luxio-lighting/luxio-hardware/LX0001/v1.0.0/Assets/connectors/JLCEDA-C55251566/README.txt

HDGC 2060-452-HDGC / C55251566 — original library 3D model

Source: JLCEDA/EasyEDA Official Library
https://lceda.cn/
https://easyeda.com/
Exact component metadata, including upstream copyright/source information,
is retained unmodified in EasyEDA-C55251566-original.json.

HDGC_2060_452_C55251566.step is the original STEP AP214 download.
The preview OBJ includes embedded EasyEDA material records; use the STEP
for CAD. Source URLs, hashes and measured preview bounds: provenance.json.

Housing width/length: 7.90 x 11.50 mm. Overall height including terminal
base: 4.50 mm. These match the nominal saved HDGC manufacturer drawing.
Total envelope including tails/marking: 7.91 x 13.15 x 4.50 mm.
No manufacturing-tolerance certification is implied by these nominal bounds.

Original coordinates retained. Register the model to the footprint before
attaching it: its present origin is not the custom footprint's body center.
This extraction does not change the PCB or fabrication package.
