luxio-lighting/luxio-hardware/LX0001/v1.0.0/Export/connection-check.txt

94 electrical footprints; 2 mounting holes; 266 mapped pins checked.
PASS: schematic netlist, PCB and connection table agree.
Pin-specific checks: ESP32-S3/no PSRAM/4MB flash, two 5V outputs, isolated dual-pin button, wired/USB terminals.
