luxio-lighting/luxio-hardware/LX0001/v1.0.0/Assets/io/C37616412_footprint_notes.txt

GCT USB4215-03-A / JLCPCB C37616412 — release USB connector
Verified 2026-11-11 against manufacturer drawing Rev A, 2024-04-26.
Saved: C37616412_USB4215-03-A.pdf (manufacturer drawing, distributor mirror).
Primary product: https://gct.co/connector/usb4215
Drawing: https://mm.digikey.com/Volume0/opasdata/d220001/medias/docus/6328/USB4215-03-A.pdf
Supplier: https://jlcpcb.com/partdetail/C37616412

USB 2.0, 16 contacts; 5 A collective VBUS / 48 V connector rating.
Source-advertised USB current still limits the controller's USB-only load.
No plastic locating pegs. Four plated slotted shell holes, for 0.80 +/-0.20 mm
metal stakes. Standard component-side pin-in-paste reflow is intended.

Footprint LX0001:USB_C_GCT_USB4215_03_A uses a body-centered origin.
Native mouth points +Y. Body 8.94 x 6.50 x 3.16 mm; body x +/-4.47,
y +/-3.25. All dimensions below are mm and viewed from component side.
Signal row: y=-3.425; length 1.15. Shared A1/B12, A4/B9, A9/B4, A12/B1
lands are 0.60 wide at x=-3.20,-2.40,+2.40,+3.20. Eight 0.30-wide lands
are at x=-1.75,-1.25,-0.75,-0.25,+0.25,+0.75,+1.25,+1.75, in drawing order
B8,A5,B7,A6,A7,B6,A8,B5. Shared physical lands carry both logical pin names.
Shell centers x +/-4.32. Rear y=-2.85, land 1.00x1.80, slot 0.60x1.40.
Front y=+1.15, land 1.00x2.20, slot 0.60x1.80. All shell pads named SH/GND.
Copper extents x +/-4.82, y=-4.00..+2.25. Body extends to y=+3.25.
Courtyard x +/-5.07, y=-4.25..+3.50 (plus 0.025 stroke).
The 5.15 distance from front stake center to signal-land rear edge, 4.00
stake-row pitch and 2.10 mouth-to-front-stake distance determine registration.

60 x 20 mm board integration, v1.0.0 revision 2026-11-11:
Load native footprint on top, rotate -90 degrees, place at (2.75,5.25).
Board outline x=0..60,y=0..20. Fabrication origin (0,20): CPL=(X,20-Y).
Mouth x=-0.50 (0.50 mm beyond input edge). Body x=-0.50..6.00,
y=0.78..9.72. Shell centers (1.60,0.93),(5.60,0.93),(1.60,9.57),
(5.60,9.57). J2 is also on top at (6.50,15.25), rotation -90;
its body spans x=0.75..12.25,y=11.30..19.20. Nominal body-to-body gap
across the width is 1.58 mm. Both connectors open toward the input end;
J2's face sits 1.25 mm farther inward than the USB mouth.
All shell holes and annuli clear J2 and other component bodies.
Shell masks open on BOTH sides; F.Paste only. Normal hybrid SMT/PIP assembly
applies, with no courtyard exception or opposite-side fillet restriction.
Previous 66.5 mm geometry: Assets/review-history/stacked-inputs-665mm.

Attached STEP: Source/libraries/models/USB_C_C37616412_library.step.
The exact C37616412 library record links to the shared model
USB-C-SMD_GT-USB-7010B. Its 8.94 x 6.50 x 3.16 mm body and shell centers
match the GCT drawing. The 0.90 mm stake depth is within 0.80 +/-0.20 mm.
Offset (0,0,1.58) mm; no rotation/scaling. This is a library visualization,
not a manufacturer-authenticated GCT enclosure model. Original metadata and
source files: Assets/connectors/JLCEDA-C37616412. The older simplified WRL
is retained as history and is no longer attached.

Superseded: HDGC C2936195 and HRO C165948 footprints/PDFs are historical
comparison evidence only. The HDGC plastic peg holes collide with terminal
copper when both input connectors are centered; do not substitute it back.
