luxio-lighting/luxio-hardware/LX0001/v1.0.0/Assets/connectors/HDGC_2060_452_C55251566_drawing.png

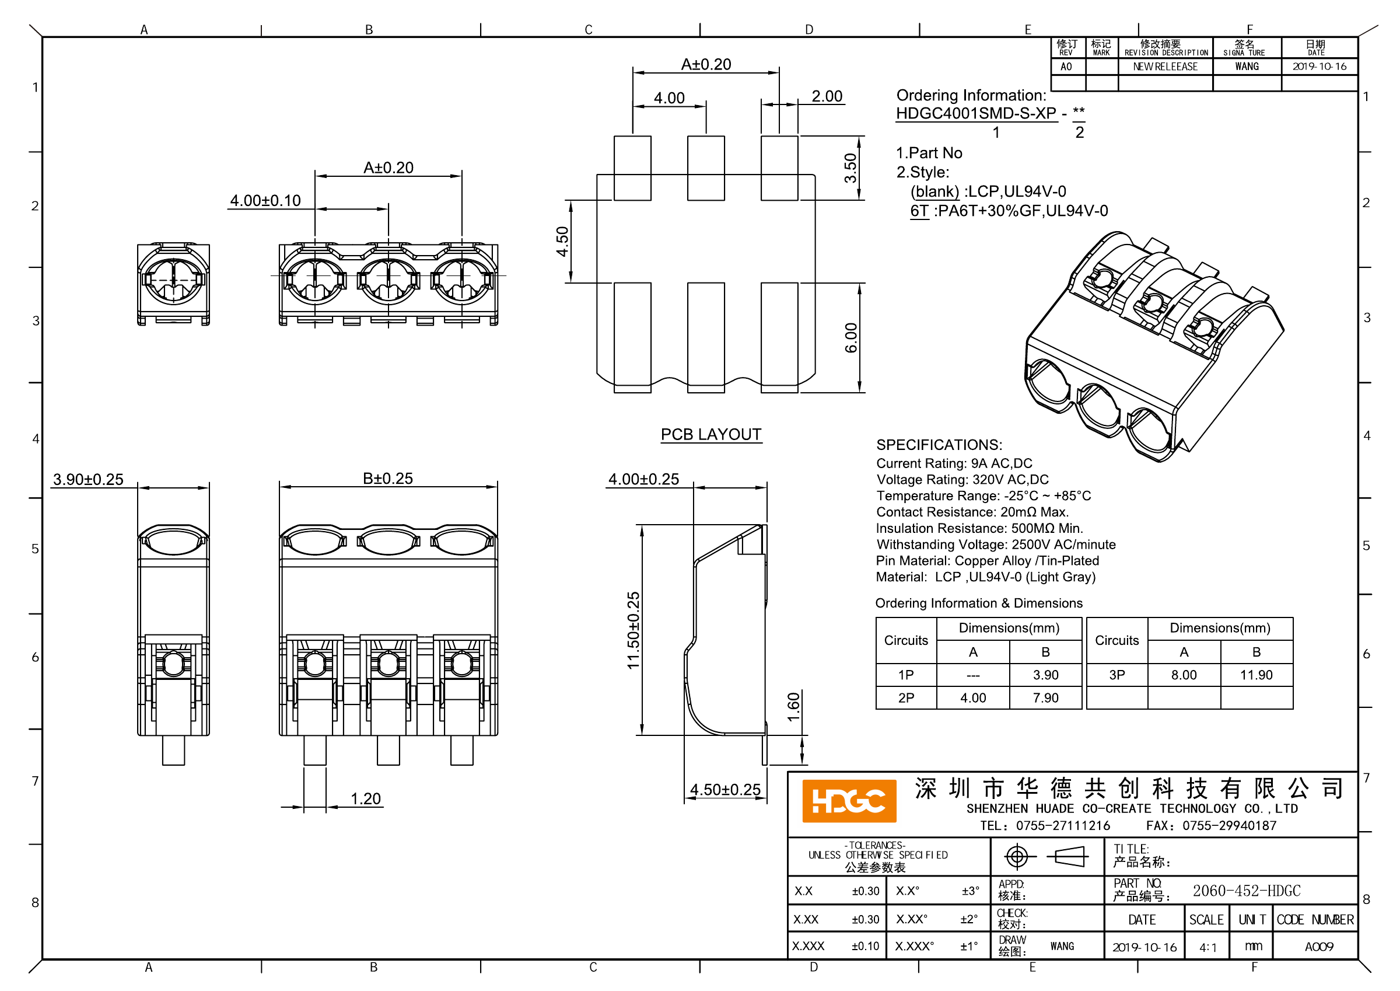
LX0001/v1.0.0/Assets/connectors/HDGC_2060_452_C55251566_drawing.png
