luxio-lighting/luxio-hardware/LX0001/v1.0.0/Assets/connectors/WAGO_2060_452_dimensional_drawing.png

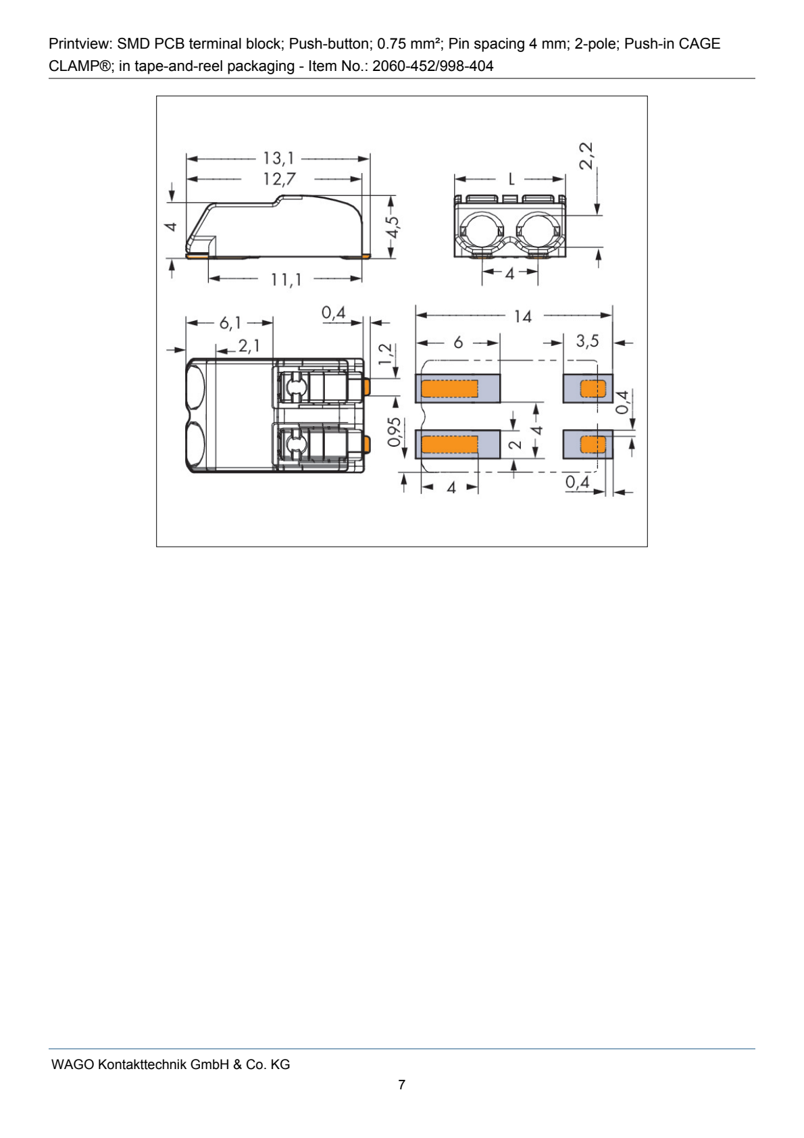
LX0001/v1.0.0/Assets/connectors/WAGO_2060_452_dimensional_drawing.png
