luxio-lighting/luxio-hardware/LX0001/v1.0.0/Assets/input-layout-proposal/side-by-side-top.png

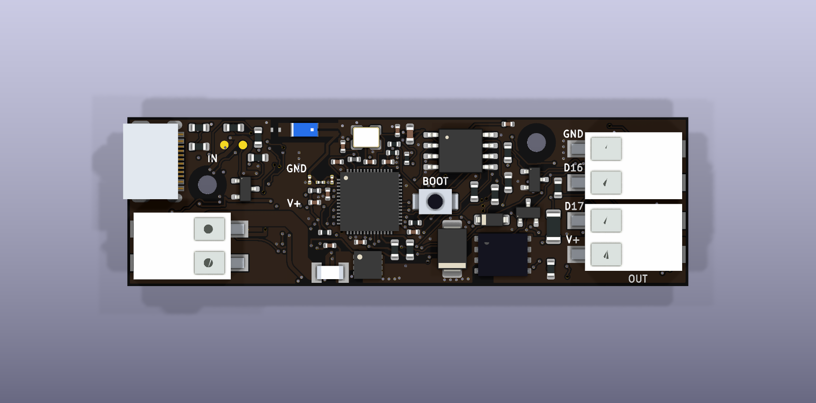
LX0001/v1.0.0/Assets/input-layout-proposal/side-by-side-top.png
