luxio-lighting/luxio-hardware/LX0001/v1.0.0/Assets/io/C2135_BAT54C_page1.png

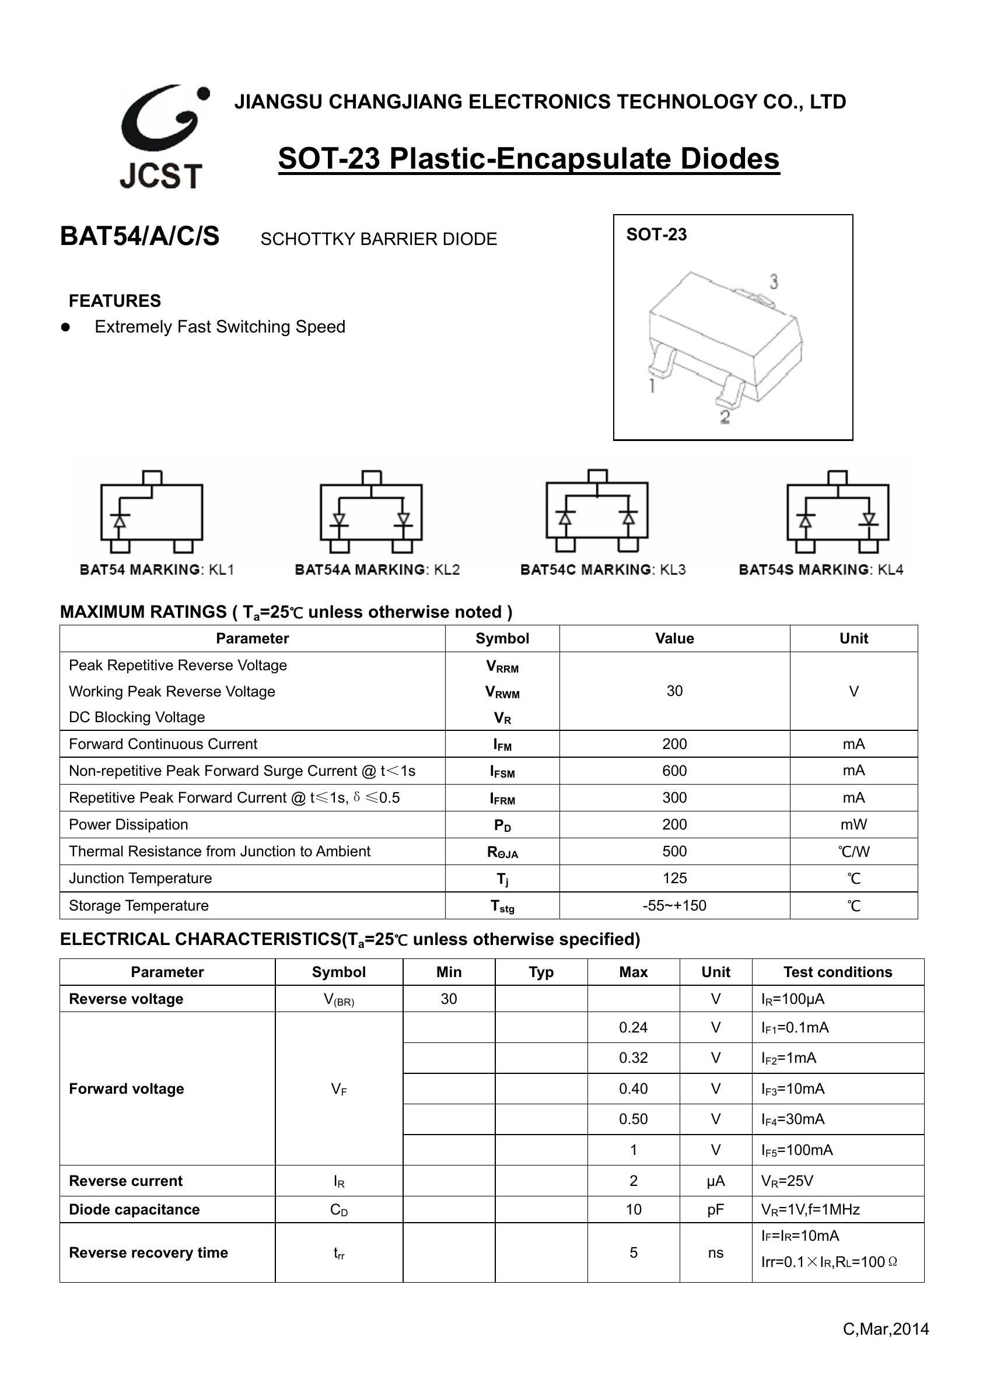
LX0001/v1.0.0/Assets/io/C2135_BAT54C_page1.png
