luxio-lighting/luxio-hardware/LX0001/v1.0.0/Assets/io/C165948_TYPE-C-31-M-12_page1.png

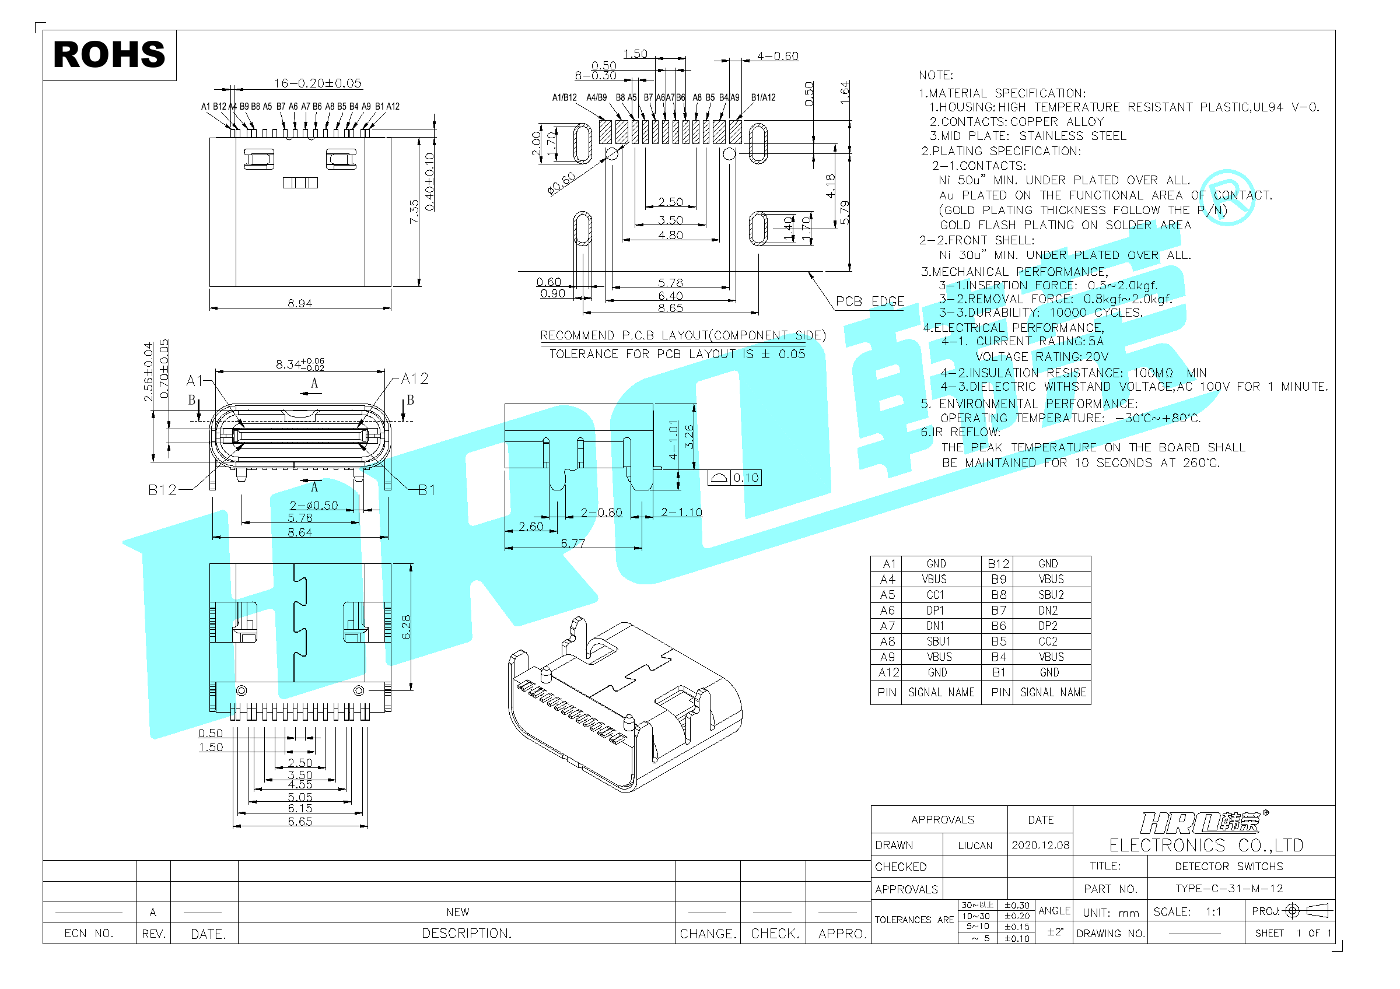
LX0001/v1.0.0/Assets/io/C165948_TYPE-C-31-M-12_page1.png
