luxio-lighting/luxio-hardware/LX0001/v1.0.0/Assets/io/C720477_TS-1088-AR02016_page1.png

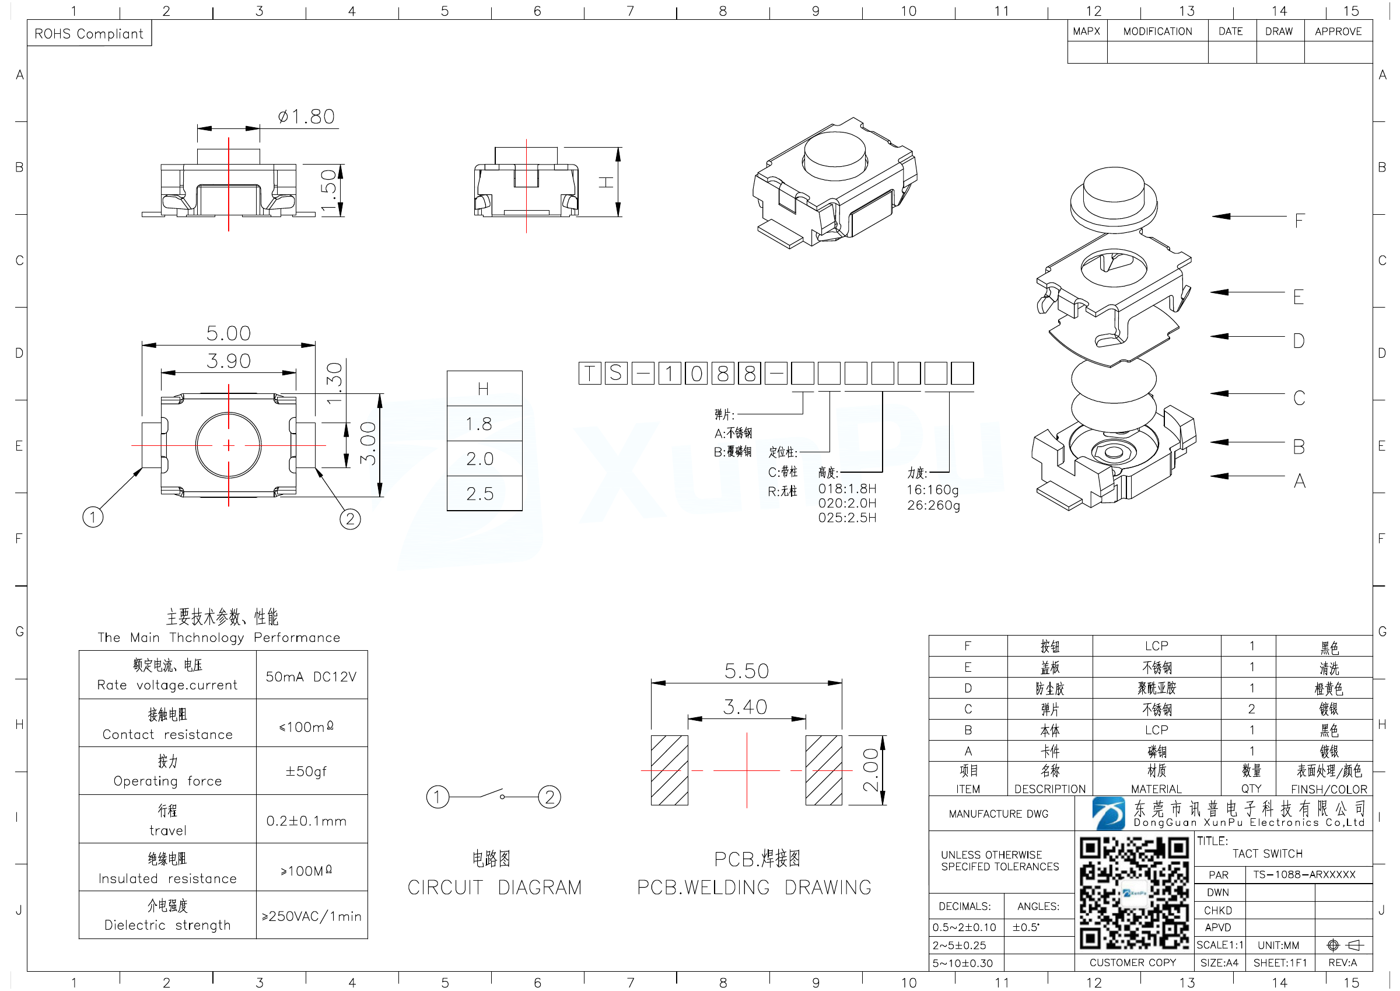
LX0001/v1.0.0/Assets/io/C720477_TS-1088-AR02016_page1.png
