luxio-lighting/luxio-hardware/LX0001/v1.0.0/Assets/io/C2927038_USB-TYPE-C-018_drawing.png

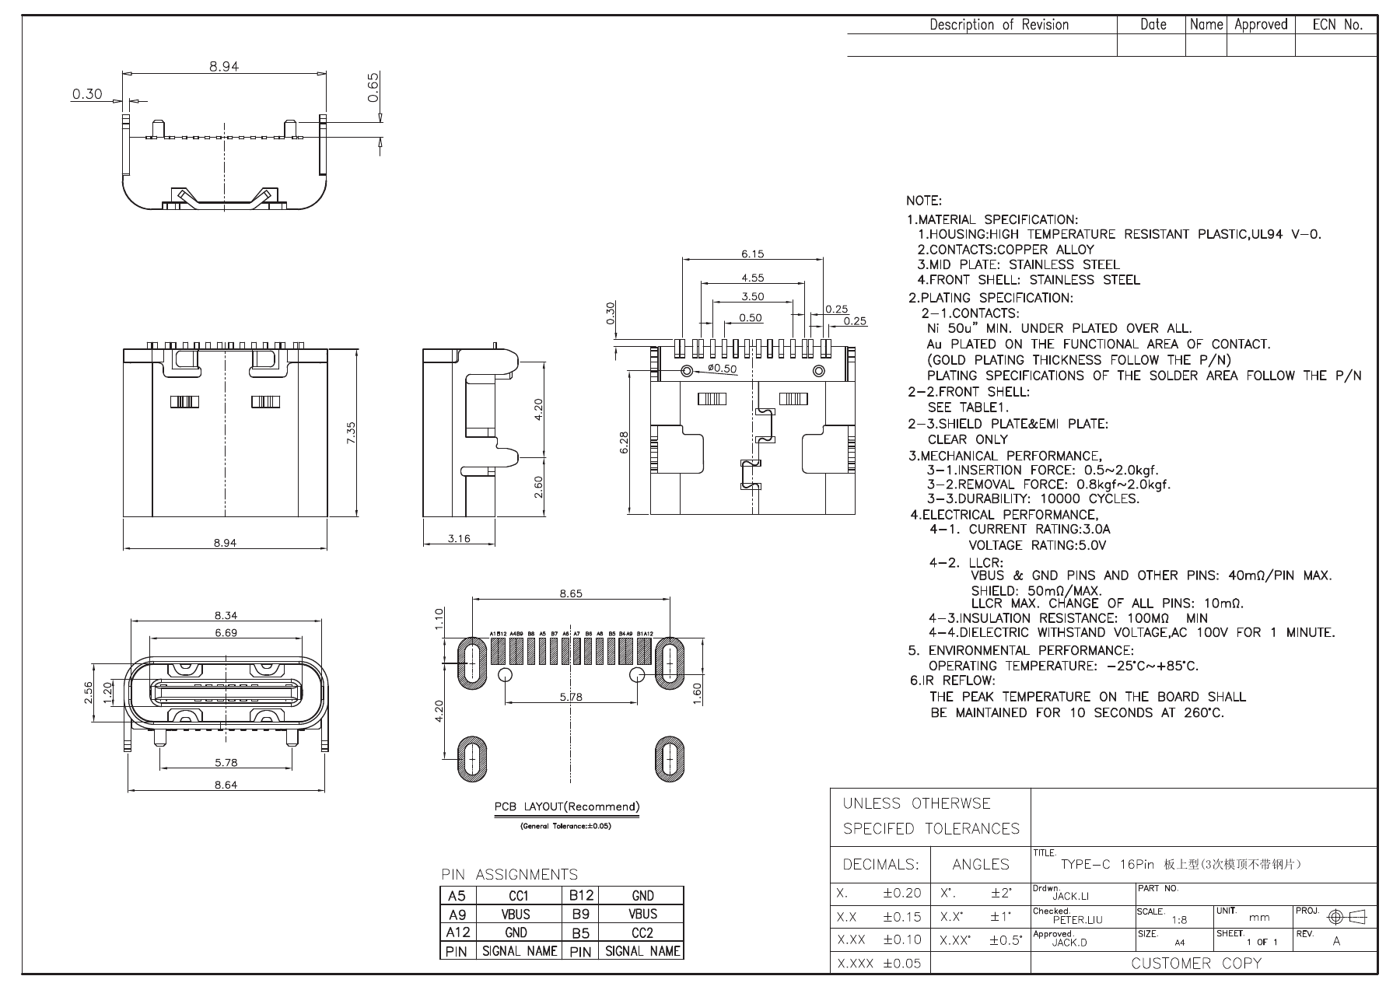
LX0001/v1.0.0/Assets/io/C2927038_USB-TYPE-C-018_drawing.png
