luxio-lighting/luxio-hardware/LX0001/v1.0.0/Assets/io/C2936195_USB_candidate.png

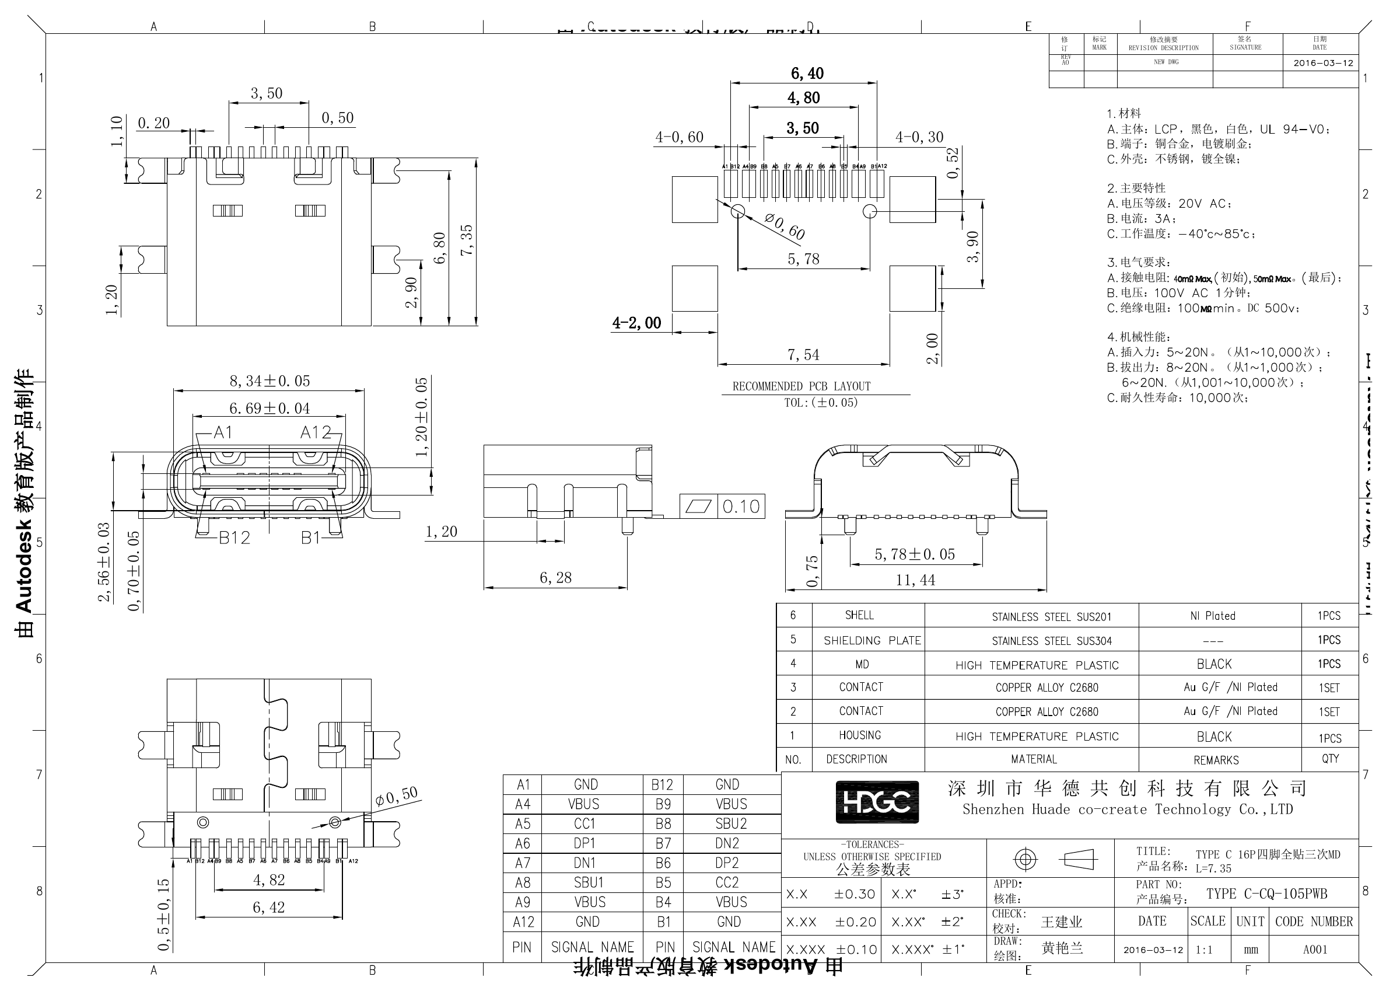
LX0001/v1.0.0/Assets/io/C2936195_USB_candidate.png
