luxio-lighting/luxio-hardware/LX0001/v1.0.0/Assets/io/C37616412_USB4215-03-A_drawing.png

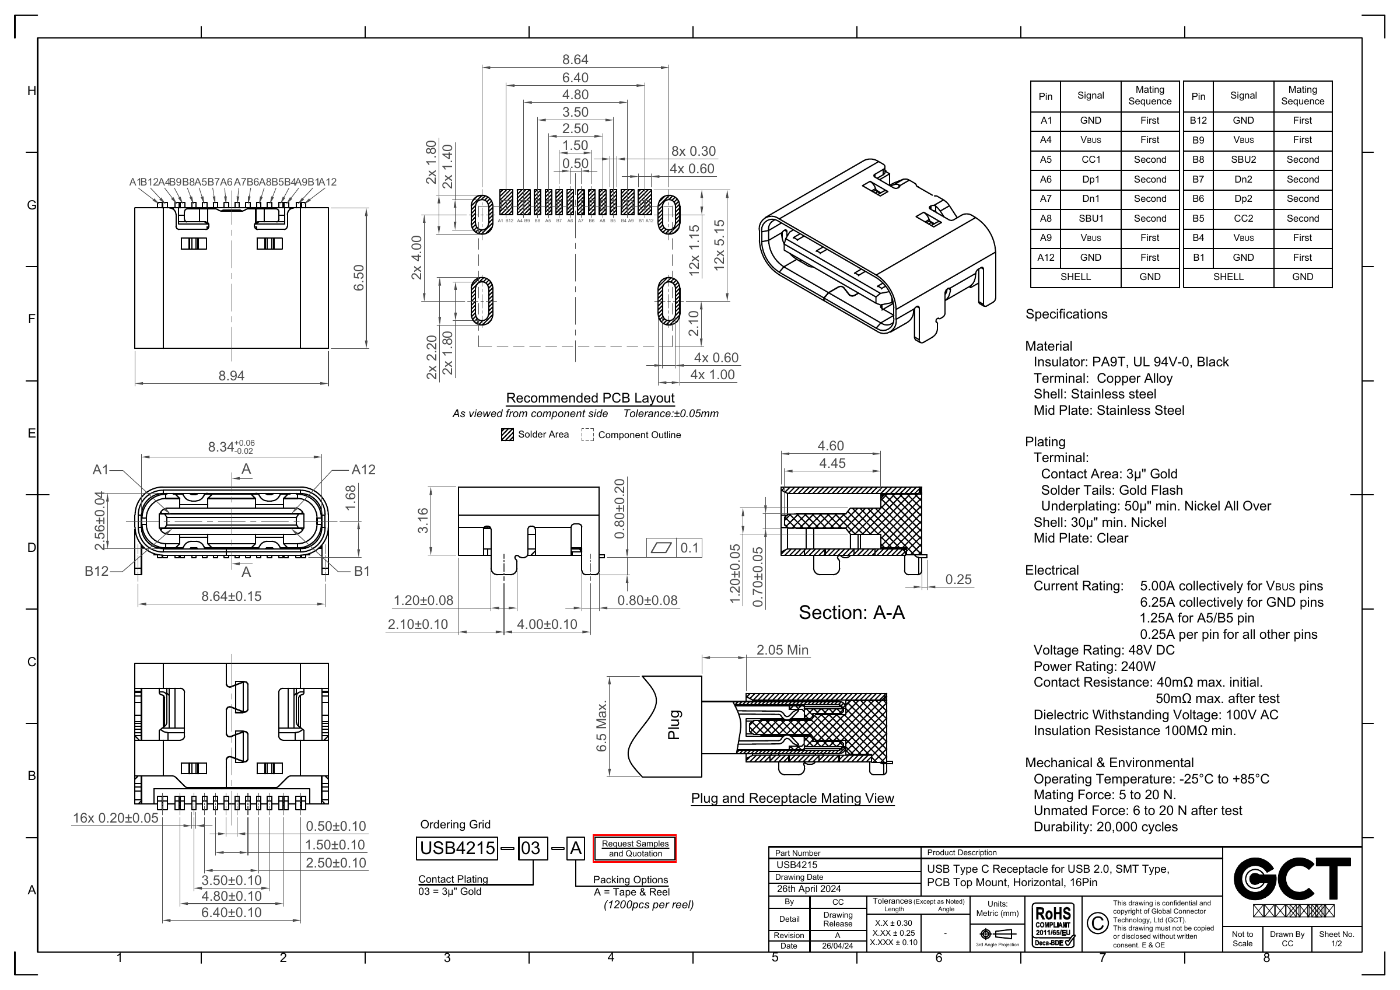
LX0001/v1.0.0/Assets/io/C37616412_USB4215-03-A_drawing.png
