luxio-lighting/luxio-hardware/LX0001/v1.0.0/Assets/io/C53340455_USB_candidate.png

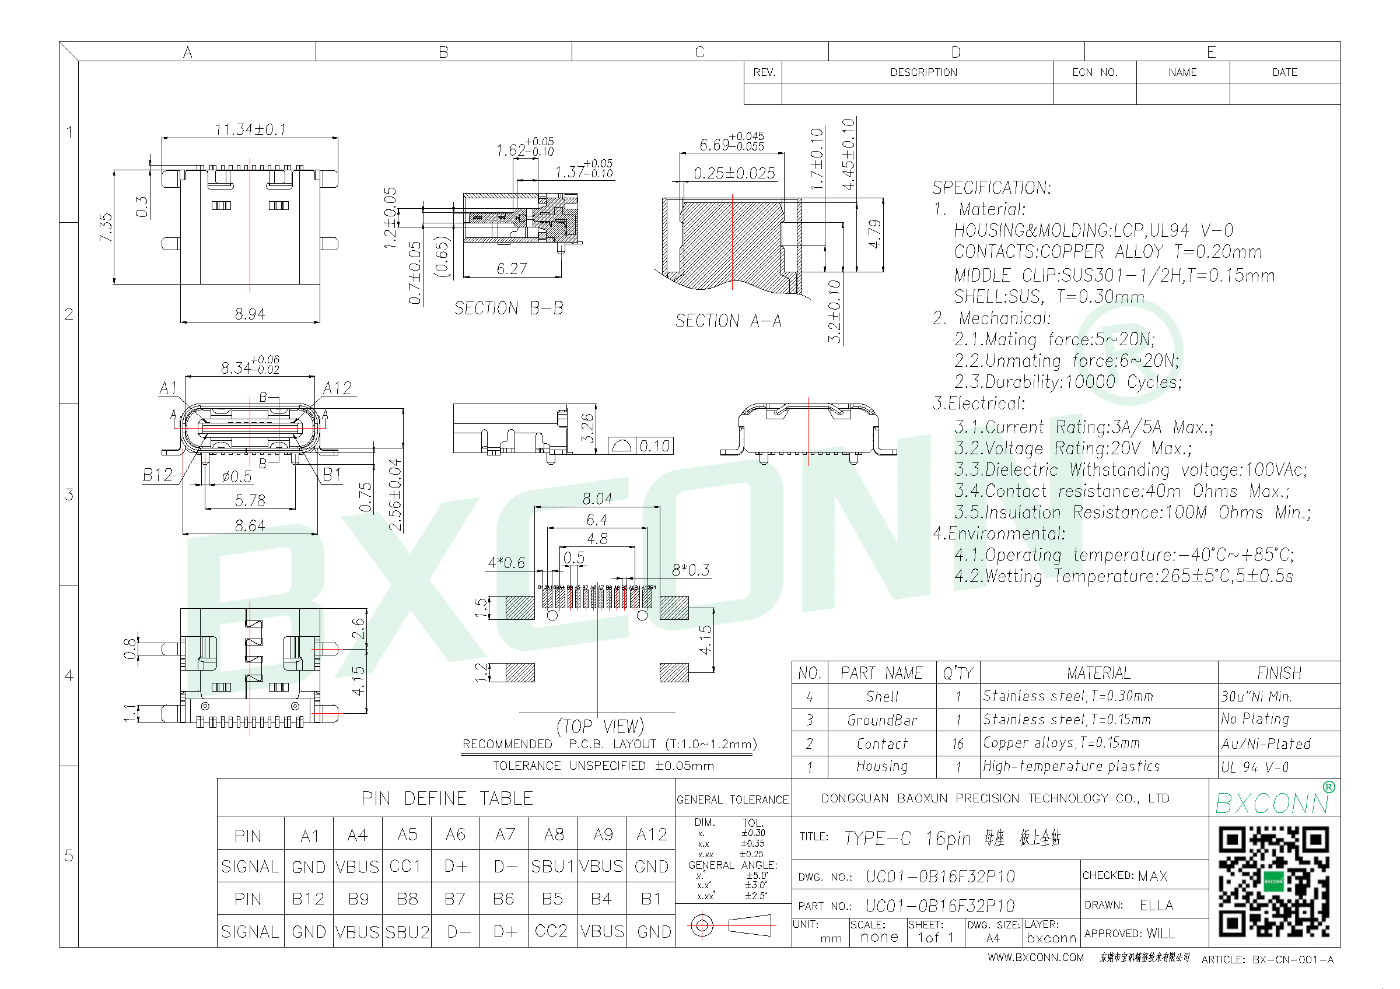
LX0001/v1.0.0/Assets/io/C53340455_USB_candidate.png
