luxio-lighting/luxio-hardware/LX0001/v1.0.0/Assets/power/CMSA80P06A-2.png

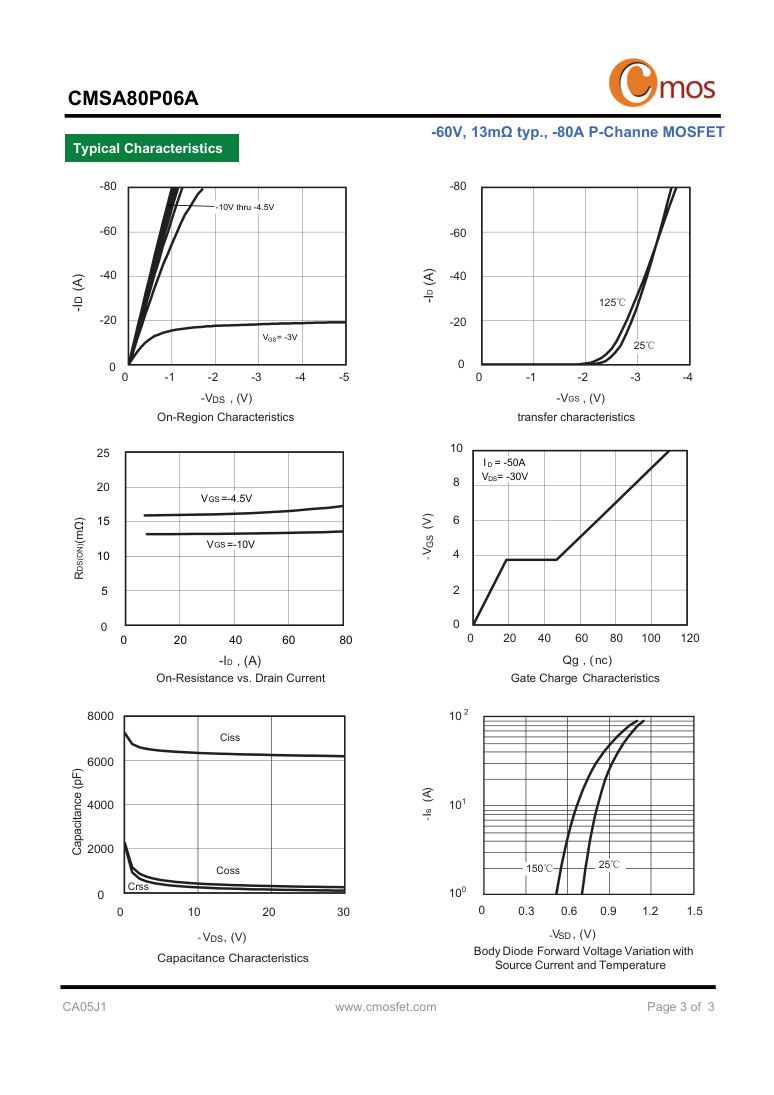
LX0001/v1.0.0/Assets/power/CMSA80P06A-2.png
