luxio-lighting/luxio-hardware/LX0001/v1.0.0/Assets/power/csd18543q3a.pdf.png

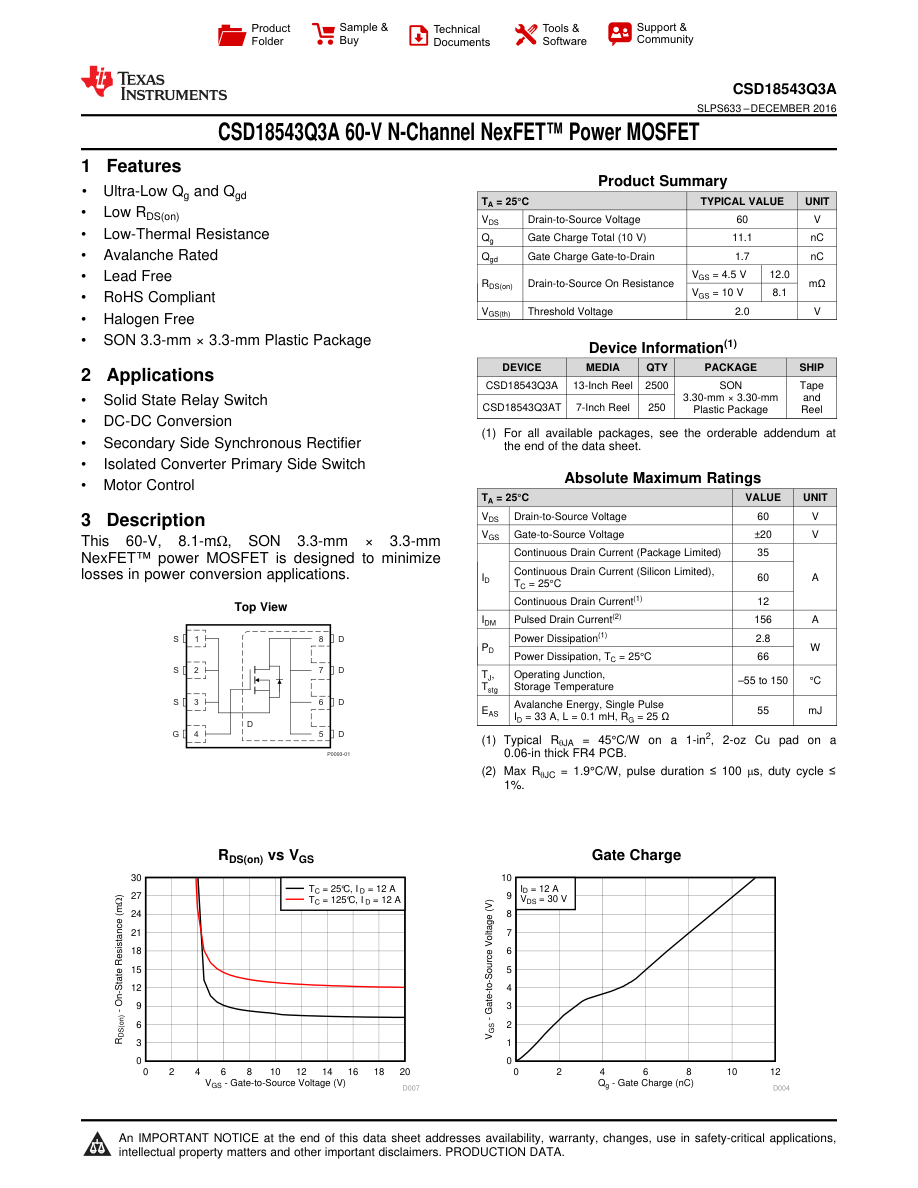
LX0001/v1.0.0/Assets/power/csd18543q3a.pdf.png
