luxio-lighting/luxio-hardware/LX0001/v1.0.0/Assets/power/DMP6023LE-pinout.png

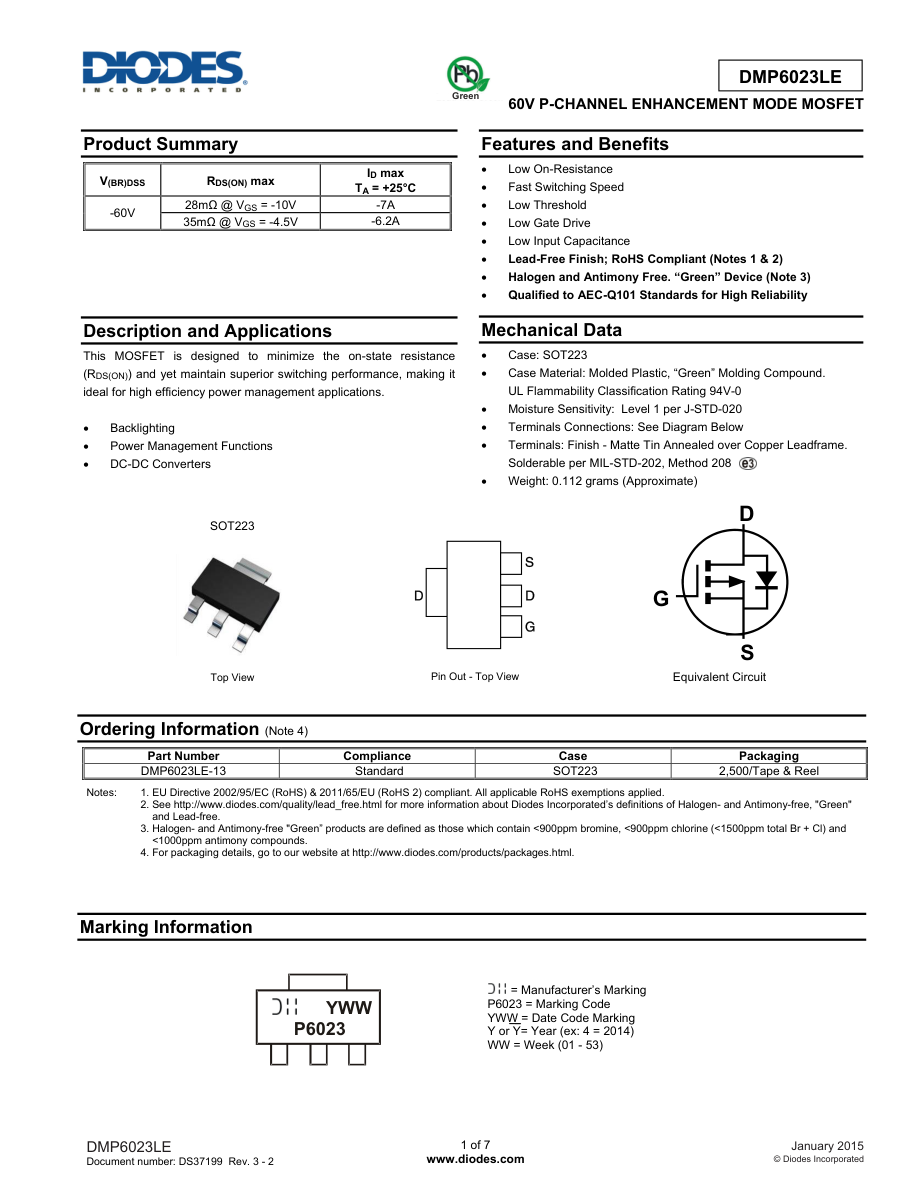
LX0001/v1.0.0/Assets/power/DMP6023LE-pinout.png
