luxio-lighting/luxio-hardware/LX0001/v1.0.0/Assets/power/tps2553.pdf.png

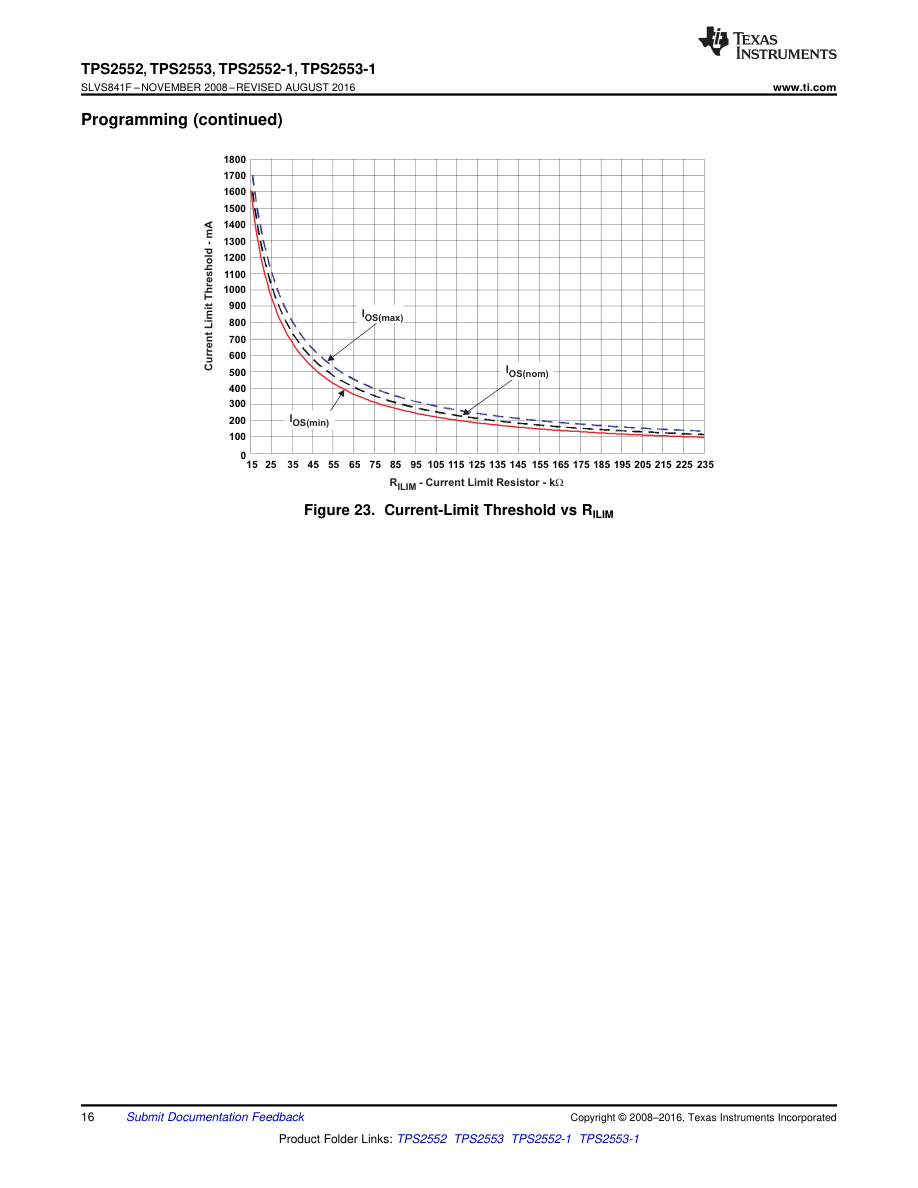
LX0001/v1.0.0/Assets/power/tps2553.pdf.png
