luxio-lighting/luxio-hardware/LX0001/v1.0.0/Export/copper-bottom.png

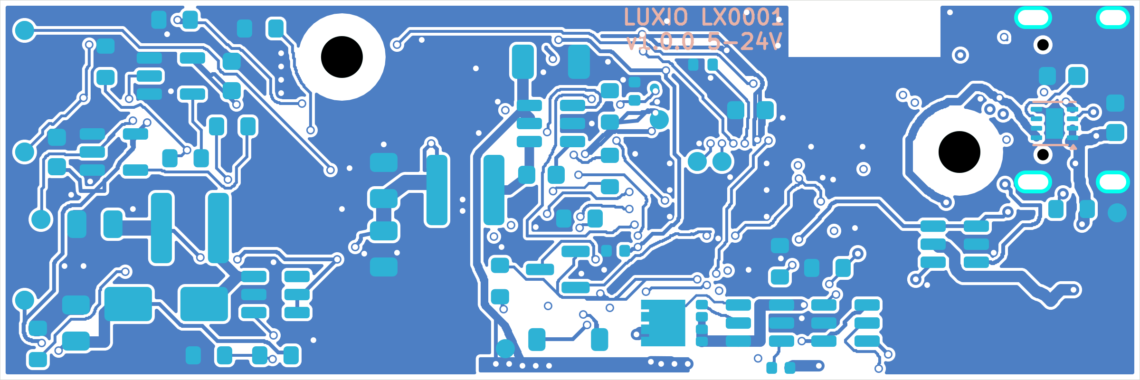
LX0001/v1.0.0/Export/copper-bottom.png
