luxio-lighting/luxio-hardware/LX0001/v1.0.0/Source/cost_review.txt

LX0001 v1.0.0 — component cost estimate after DEALON USB substitution

83 fitted parts /46 supplier codes; USD12.3170/board at100 boards.
Excludes PCB, assembly, feeders, attrition, shipping and tax.
C2927038 price/stock fetched2026-11-12. Other components retain their dated supplier snapshots. Not a reserved quotation.

LCSC       Qty/board UnitUSD Cost/board Ref
C122837        1 0.1969 0.1969 U4
C127620        1 0.0443 0.0443 ANT1
C13585         1 0.1011 0.1011 C8
C14663         3 0.0058 0.0174 C9,C14,C17
C14890         1 0.0018 0.0018 R14
C1525          7 0.0031 0.0217 C101,C102,C103,C104,C105,C108,C110
C1549          2 0.0018 0.0036 C112,C113
C15849         1 0.0112 0.0112 C6
C1588          1 0.0082 0.0082 C18
C161414        2 0.0125 0.0250 C114,C115
C17168         1 0.0012 0.0012 R105
C179173        1 1.0674 1.0674 U10
C18216         1 0.0228 0.0228 L100
C183158        1 0.0844 0.0844 F1
C19702         2 0.0177 0.0354 C100,C107
C20526         1 0.0103 0.0103 Q2
C2135          1 0.0246 0.0246 D4
C22775         2 0.0021 0.0042 R16,R27
C23186         2 0.0015 0.0030 R1,R2
C23345         2 0.0017 0.0034 R3,R4
C2480          1 0.0192 0.0192 D2
C25744         5 0.0010 0.0050 R100,R101,R102,R103,R110
C25803         7 0.0029 0.0203 R22,R17,R18,R28,R29,R10,R13
C25804         3 0.0022 0.0066 R15,R24,R30
C25819         1 0.0016 0.0016 R12
C2913192       1 2.0662 2.0662 U1
C2927038       1 0.0506 0.0506 J1
C2941042       2 2.0515 4.1030 U3,U5
C307331        2 0.0085 0.0170 C5,C7
C31850         1 0.0042 0.0042 R23
C32347484      1 0.8500 0.8500 U6
C38117         1 0.0493 0.0493 L1
C45783         4 0.0842 0.3368 C10,C11,C12,C13
C52923         3 0.0057 0.0171 C106,C109,C111
C55251566      3 0.1660 0.4980 J2,J3,J4
C57269         1 0.0466 0.0466 L2
C655034        1 0.0532 0.0532 Y1
C720477        1 0.0414 0.0414 SW1
C7470946       1 0.0403 0.0403 D3
C7484          2 0.0695 0.1390 U8,U9
C7519          1 0.1192 0.1192 U2
C81598         1 0.0124 0.0124 D1
C840100        2 0.9694 1.9388 Q1,Q3
C84817         1 0.0823 0.0823 U7
C913699        1 0.0944 0.0944 L101
C98043         1 0.0166 0.0166 L102
