luxio-lighting/luxio-hardware/LX0001/v1.0.0/Export/component-costs.csv

lcsc | designators | quantity_per_board | required_quantity_100_boards | unit_price_usd | cost_per_board_usd | cost_100_boards_usd | available_stock | observed_at_utc | source_url
C122837 | U4 | 1 | 100 | 0.1969 | 0.1969 | 19.69 | 12099 | 2026-11-11T22:44:12.739354+00:00 | https://jlcpcb.com/api/overseas-pcb-order/v1/smtComponentShopCart/getComponentDetail?componentCode=C122837
C127620 | ANT1 | 1 | 100 | 0.0443 | 0.0443 | 4.43 | 21976 | 2026-11-11T13:00:22Z | https://jlcpcb.com/api/overseas-pcb-order/v1/smtComponentShopCart/getComponentDetail?componentCode=C127620
C13585 | C8 | 1 | 100 | 0.1011 | 0.1011 | 10.11 | 2595851 | 2026-11-11T11:47:00Z | https://jlcpcb.com/api/overseas-pcb-order/v1/smtComponentShopCart/getComponentDetail?componentCode=C13585
C14663 | C9,C14,C17 | 3 | 300 | 0.0058 | 0.0174 | 1.74 | 24795240 | 2026-11-11T11:47:00Z | https://jlcpcb.com/api/overseas-pcb-order/v1/smtComponentShopCart/getComponentDetail?componentCode=C14663
C14890 | R14 | 1 | 100 | 0.0018 | 0.0018 | 0.18 | 29104 | 2026-11-11T11:47:00Z | https://jlcpcb.com/api/overseas-pcb-order/v1/smtComponentShopCart/getComponentDetail?componentCode=C14890
C1525 | C101,C102,C103,C104,C105,C108,C110 | 7 | 700 | 0.0031 | 0.0217 | 2.17 | 23336222 | 2026-11-11T11:46:59Z | https://jlcpcb.com/api/overseas-pcb-order/v1/smtComponentShopCart/getComponentDetail?componentCode=C1525
C1549 | C112,C113 | 2 | 200 | 0.0018 | 0.0036 | 0.36 | 958063 | 2026-11-11T11:46:59Z | https://jlcpcb.com/api/overseas-pcb-order/v1/smtComponentShopCart/getComponentDetail?componentCode=C1549
C15849 | C6 | 1 | 100 | 0.0112 | 0.0112 | 1.12 | 8918774 | 2026-11-11T11:47:44Z | https://jlcpcb.com/api/overseas-pcb-order/v1/smtComponentShopCart/getComponentDetail?componentCode=C15849
C1588 | C18 | 1 | 100 | 0.0082 | 0.0082 | 0.82 | 4761056 | 2026-11-11T22:44:12.739354+00:00 | https://jlcpcb.com/api/overseas-pcb-order/v1/smtComponentShopCart/getComponentDetail?componentCode=C1588
C161414 | C114,C115 | 2 | 200 | 0.0125 | 0.025 | 2.5 | 33848 | 2026-11-11T11:47:01Z | https://jlcpcb.com/api/overseas-pcb-order/v1/smtComponentShopCart/getComponentDetail?componentCode=C161414
C17168 | R105 | 1 | 100 | 0.0012 | 0.0012 | 0.12 | 13890683 | 2026-11-11T11:47:00Z | https://jlcpcb.com/api/overseas-pcb-order/v1/smtComponentShopCart/getComponentDetail?componentCode=C17168
C179173 | U10 | 1 | 100 | 1.0674 | 1.0674 | 106.74 | 2064 | 2026-11-11T11:47:01Z | https://jlcpcb.com/api/overseas-pcb-order/v1/smtComponentShopCart/getComponentDetail?componentCode=C179173
C18216 | L100 | 1 | 100 | 0.0228 | 0.0228 | 2.28 | 50007 | 2026-11-11T11:47:00Z | https://jlcpcb.com/api/overseas-pcb-order/v1/smtComponentShopCart/getComponentDetail?componentCode=C18216
C183158 | F1 | 1 | 100 | 0.0844 | 0.0844 | 8.44 | 2122 | 2026-11-11T11:47:01Z | https://jlcpcb.com/api/overseas-pcb-order/v1/smtComponentShopCart/getComponentDetail?componentCode=C183158
C19702 | C100,C107 | 2 | 200 | 0.0177 | 0.0354 | 3.54 | 6970687 | 2026-11-11T11:47:00Z | https://jlcpcb.com/api/overseas-pcb-order/v1/smtComponentShopCart/getComponentDetail?componentCode=C19702
C20526 | Q2 | 1 | 100 | 0.0103 | 0.0103 | 1.03 | 4111492 | 2026-11-11T11:47:00Z | https://jlcpcb.com/api/overseas-pcb-order/v1/smtComponentShopCart/getComponentDetail?componentCode=C20526
C2135 | D4 | 1 | 100 | 0.0246 | 0.0246 | 2.46 | 165977 | 2026-11-11T11:47:00Z | https://jlcpcb.com/api/overseas-pcb-order/v1/smtComponentShopCart/getComponentDetail?componentCode=C2135
C22775 | R16,R27 | 2 | 200 | 0.0021 | 0.0042 | 0.42 | 6545386 | 2026-11-11T11:47:00Z | https://jlcpcb.com/api/overseas-pcb-order/v1/smtComponentShopCart/getComponentDetail?componentCode=C22775
C23186 | R1,R2 | 2 | 200 | 0.0015 | 0.003 | 0.3 | 18434736 | 2026-11-11T11:47:00Z | https://jlcpcb.com/api/overseas-pcb-order/v1/smtComponentShopCart/getComponentDetail?componentCode=C23186
C23345 | R3,R4 | 2 | 200 | 0.0017 | 0.0034 | 0.34 | 4690688 | 2026-11-11T11:47:00Z | https://jlcpcb.com/api/overseas-pcb-order/v1/smtComponentShopCart/getComponentDetail?componentCode=C23345
C2480 | D2 | 1 | 100 | 0.0192 | 0.0192 | 1.92 | 1393158 | 2026-11-11T11:46:59Z | https://jlcpcb.com/api/overseas-pcb-order/v1/smtComponentShopCart/getComponentDetail?componentCode=C2480
C25744 | R100,R101,R102,R103,R110 | 5 | 500 | 0.001 | 0.005 | 0.5 | 15152057 | 2026-11-11T11:47:00Z | https://jlcpcb.com/api/overseas-pcb-order/v1/smtComponentShopCart/getComponentDetail?componentCode=C25744
C25803 | R22,R17,R18,R28,R29,R10,R13 | 7 | 700 | 0.0029 | 0.0203 | 2.03 | 12927296 | 2026-11-11T11:47:00Z | https://jlcpcb.com/api/overseas-pcb-order/v1/smtComponentShopCart/getComponentDetail?componentCode=C25803
C25804 | R15,R24,R30 | 3 | 300 | 0.0022 | 0.0066 | 0.66 | 33355199 | 2026-11-11T11:47:00Z | https://jlcpcb.com/api/overseas-pcb-order/v1/smtComponentShopCart/getComponentDetail?componentCode=C25804
C25819 | R12 | 1 | 100 | 0.0016 | 0.0016 | 0.16 | 2253598 | 2026-11-11T11:47:00Z | https://jlcpcb.com/api/overseas-pcb-order/v1/smtComponentShopCart/getComponentDetail?componentCode=C25819
C2913192 | U1 | 1 | 100 | 2.0662 | 2.0662 | 206.62 | 781 | 2026-11-11T11:47:45Z | https://jlcpcb.com/api/overseas-pcb-order/v1/smtComponentShopCart/getComponentDetail?componentCode=C2913192
C2927038 | J1 | 1 | 100 | 0.0506 | 0.0506 | 5.06 | 194721 | 2026-11-12T13:22:00.833419+00:00 | https://jlcpcb.com/api/overseas-pcb-order/v1/smtComponentShopCart/getComponentDetail?componentCode=C2927038
C2941042 | U3,U5 | 2 | 200 | 2.0515 | 4.103 | 410.3 | 18978 | 2026-11-11T11:47:01Z | https://jlcpcb.com/api/overseas-pcb-order/v1/smtComponentShopCart/getComponentDetail?componentCode=C2941042
C307331 | C5,C7 | 2 | 200 | 0.0085 | 0.017 | 1.7 | 15474133 | 2026-11-11T19:44:21Z | https://jlcpcb.com/partdetail/C307331
C31850 | R23 | 1 | 100 | 0.0042 | 0.0042 | 0.42 | 2239622 | 2026-11-11T11:47:44Z | https://jlcpcb.com/api/overseas-pcb-order/v1/smtComponentShopCart/getComponentDetail?componentCode=C31850
C32347484 | U6 | 1 | 100 | 0.85 | 0.85 | 85.0 | 813 | 2026-11-11T11:47:01Z | https://jlcpcb.com/api/overseas-pcb-order/v1/smtComponentShopCart/getComponentDetail?componentCode=C32347484
C38117 | L1 | 1 | 100 | 0.0493 | 0.0493 | 4.93 | 37531 | 2026-11-11T11:47:00Z | https://jlcpcb.com/api/overseas-pcb-order/v1/smtComponentShopCart/getComponentDetail?componentCode=C38117
C45783 | C10,C11,C12,C13 | 4 | 400 | 0.0842 | 0.3368 | 33.68 | 2799208 | 2026-11-11T11:47:44Z | https://jlcpcb.com/api/overseas-pcb-order/v1/smtComponentShopCart/getComponentDetail?componentCode=C45783
C52923 | C106,C109,C111 | 3 | 300 | 0.0057 | 0.0171 | 1.71 | 8484075 | 2026-11-11T11:47:00Z | https://jlcpcb.com/api/overseas-pcb-order/v1/smtComponentShopCart/getComponentDetail?componentCode=C52923
C55251566 | J2,J3,J4 | 3 | 300 | 0.166 | 0.498 | 49.8 | 19989 | 2026-11-11T11:47:01Z | https://jlcpcb.com/api/overseas-pcb-order/v1/smtComponentShopCart/getComponentDetail?componentCode=C55251566
C57269 | L2 | 1 | 100 | 0.0466 | 0.0466 | 4.66 | 28128 | 2026-11-11T11:47:00Z | https://jlcpcb.com/api/overseas-pcb-order/v1/smtComponentShopCart/getComponentDetail?componentCode=C57269
C655034 | Y1 | 1 | 100 | 0.0532 | 0.0532 | 5.32 | 2657 | 2026-11-11T11:47:45Z | https://jlcpcb.com/api/overseas-pcb-order/v1/smtComponentShopCart/getComponentDetail?componentCode=C655034
C720477 | SW1 | 1 | 100 | 0.0414 | 0.0414 | 4.14 | 850648 | 2026-11-11T11:47:01Z | https://jlcpcb.com/api/overseas-pcb-order/v1/smtComponentShopCart/getComponentDetail?componentCode=C720477
C7470946 | D3 | 1 | 100 | 0.0403 | 0.0403 | 4.03 | 10310 | 2026-11-11T11:47:01Z | https://jlcpcb.com/api/overseas-pcb-order/v1/smtComponentShopCart/getComponentDetail?componentCode=C7470946
C7484 | U8,U9 | 2 | 200 | 0.0695 | 0.139 | 13.9 | 18376 | 2026-11-11T11:46:59Z | https://jlcpcb.com/api/overseas-pcb-order/v1/smtComponentShopCart/getComponentDetail?componentCode=C7484
C7519 | U2 | 1 | 100 | 0.1192 | 0.1192 | 11.92 | 24773 | 2026-11-11T11:47:00Z | https://jlcpcb.com/api/overseas-pcb-order/v1/smtComponentShopCart/getComponentDetail?componentCode=C7519
C81598 | D1 | 1 | 100 | 0.0124 | 0.0124 | 1.24 | 3020259 | 2026-11-11T11:47:01Z | https://jlcpcb.com/api/overseas-pcb-order/v1/smtComponentShopCart/getComponentDetail?componentCode=C81598
C840100 | Q1,Q3 | 2 | 200 | 0.9694 | 1.9388 | 193.88 | 1755 | 2026-11-11T11:47:01Z | https://jlcpcb.com/api/overseas-pcb-order/v1/smtComponentShopCart/getComponentDetail?componentCode=C840100
C84817 | U7 | 1 | 100 | 0.0823 | 0.0823 | 8.23 | 26822 | 2026-11-11T11:47:01Z | https://jlcpcb.com/api/overseas-pcb-order/v1/smtComponentShopCart/getComponentDetail?componentCode=C84817
C913699 | L101 | 1 | 100 | 0.0944 | 0.0944 | 9.44 | 3005 | 2026-11-11T11:47:01Z | https://jlcpcb.com/api/overseas-pcb-order/v1/smtComponentShopCart/getComponentDetail?componentCode=C913699
C98043 | L102 | 1 | 100 | 0.0166 | 0.0166 | 1.66 | 6382 | 2026-11-11T11:47:01Z | https://jlcpcb.com/api/overseas-pcb-order/v1/smtComponentShopCart/getComponentDetail?componentCode=C98043
