luxio-lighting/luxio-hardware/LX0001/v1.0.0/Assets/review-history/stacked-inputs-665mm/Source/connections.csv

Reference | Value | Pin | Net
U1 | ESP32-S3 | 1 | RF_CHIP
U1 | ESP32-S3 | 2 | VDD3P3_RF
U1 | ESP32-S3 | 3 | VDD3P3_RF
U1 | ESP32-S3 | 4 | ESP_EN
U1 | ESP32-S3 | 5 | BOOT
U1 | ESP32-S3 | 6 | CC1_SENSE
U1 | ESP32-S3 | 7 | CC2_SENSE
U1 | ESP32-S3 | 9 | VBUS_SENSE
U1 | ESP32-S3 | 10 | USB_STRIP_EN
U1 | ESP32-S3 | 20 | +3V3
U1 | ESP32-S3 | 22 | GPIO16
U1 | ESP32-S3 | 23 | GPIO17
U1 | ESP32-S3 | 24 | GPIO18_BUTTON
U1 | ESP32-S3 | 25 | USB_DM
U1 | ESP32-S3 | 26 | USB_DP
U1 | ESP32-S3 | 27 | DATA_ENABLE
U1 | ESP32-S3 | 29 | VDD_SPI
U1 | ESP32-S3 | 30 | FLASH_IO3
U1 | ESP32-S3 | 31 | FLASH_IO2
U1 | ESP32-S3 | 32 | FLASH_CS
U1 | ESP32-S3 | 33 | SPICLK
U1 | ESP32-S3 | 34 | FLASH_IO1
U1 | ESP32-S3 | 35 | FLASH_IO0
U1 | ESP32-S3 | 46 | +3V3
U1 | ESP32-S3 | 51 | STRAP45
U1 | ESP32-S3 | 52 | STRAP46
U1 | ESP32-S3 | 53 | XTAL_N
U1 | ESP32-S3 | 54 | XTAL_P
U1 | ESP32-S3 | 55 | +3V3
U1 | ESP32-S3 | 56 | +3V3
U1 | ESP32-S3 | 57 | GND
U1 | ESP32-S3 | 11 | USB_HIGH_CURRENT
U1 | ESP32-S3 | 49 | UART_TX
U1 | ESP32-S3 | 50 | UART_RX
U10 | W25Q32JVSSIQ | 1 | FLASH_CS
U10 | W25Q32JVSSIQ | 2 | FLASH_IO1
U10 | W25Q32JVSSIQ | 3 | FLASH_IO2
U10 | W25Q32JVSSIQ | 4 | GND
U10 | W25Q32JVSSIQ | 5 | FLASH_IO0
U10 | W25Q32JVSSIQ | 6 | FLASH_CLK
U10 | W25Q32JVSSIQ | 7 | FLASH_IO3
U10 | W25Q32JVSSIQ | 8 | VDD_SPI
L100 | 2nH 900mA | 1 | +3V3
L100 | 2nH 900mA | 2 | VDD3P3_RF
C100 | 10uF 10V | 1 | +3V3
C100 | 10uF 10V | 2 | GND
C101 | 100nF 16V | 1 | +3V3
C101 | 100nF 16V | 2 | GND
C102 | 100nF 16V | 1 | VDD3P3_RF
C102 | 100nF 16V | 2 | GND
C103 | 100nF 16V | 1 | +3V3
C103 | 100nF 16V | 2 | GND
C104 | 100nF 16V | 1 | +3V3
C104 | 100nF 16V | 2 | GND
C105 | 100nF 16V | 1 | +3V3
C105 | 100nF 16V | 2 | GND
C106 | 1uF 25V | 1 | +3V3
C106 | 1uF 25V | 2 | GND
C107 | 10uF 10V | 1 | +3V3
C107 | 10uF 10V | 2 | GND
C108 | 100nF 16V | 1 | VDD_SPI
C108 | 100nF 16V | 2 | GND
C109 | 1uF 25V | 1 | VDD_SPI
C109 | 1uF 25V | 2 | GND
C110 | 100nF 16V | 1 | VDD_SPI
C110 | 100nF 16V | 2 | GND
R100 | 10k | 1 | +3V3
R100 | 10k | 2 | ESP_EN
C111 | 1uF 25V | 1 | ESP_EN
C111 | 1uF 25V | 2 | GND
R101 | 10k | 1 | +3V3
R101 | 10k | 2 | BOOT
R102 | 10k | 1 | STRAP45
R102 | 10k | 2 | GND
R103 | 10k | 1 | STRAP46
R103 | 10k | 2 | GND
Y1 | 40MHz 12pF 10ppm | 1 | XTAL_P_CRYSTAL
Y1 | 40MHz 12pF 10ppm | 2 | GND
Y1 | 40MHz 12pF 10ppm | 3 | XTAL_N
Y1 | 40MHz 12pF 10ppm | 4 | GND
C112 | 18pF 50V C0G | 1 | XTAL_P_CRYSTAL
C112 | 18pF 50V C0G | 2 | GND
C113 | 18pF 50V C0G | 1 | XTAL_N
C113 | 18pF 50V C0G | 2 | GND
L101 | 24nH | 1 | XTAL_P
L101 | 24nH | 2 | XTAL_P_CRYSTAL
C114 | 1.5pF 50V C0G | 1 | RF_CHIP
C114 | 1.5pF 50V C0G | 2 | GND
L102 | 2.7nH | 1 | RF_CHIP
L102 | 2.7nH | 2 | RF_50
C115 | 1.5pF 50V C0G | 1 | RF_50
C115 | 1.5pF 50V C0G | 2 | GND
L104 | DNP 0R antenna tune | 1 | ANT_TUNE
L104 | DNP 0R antenna tune | 2 | GND
ANT1 | RFECA3216060A1T | 1 | RF_50
ANT1 | RFECA3216060A1T | 2 | ANT_TUNE
ANT1 | RFECA3216060A1T | 3 | GND
R105 | 0 | 1 | SPICLK
R105 | 0 | 2 | FLASH_CLK
R110 | 10k | 1 | VDD_SPI
R110 | 10k | 2 | FLASH_CS
J1 | USB4215-03-A | A1 | GND
J1 | USB4215-03-A | A4 | USB_5V
J1 | USB4215-03-A | A5 | CC1
J1 | USB4215-03-A | A6 | USB_DP_CONN
J1 | USB4215-03-A | A7 | USB_DM_CONN
J1 | USB4215-03-A | A9 | USB_5V
J1 | USB4215-03-A | A12 | GND
J1 | USB4215-03-A | B1 | GND
J1 | USB4215-03-A | B4 | USB_5V
J1 | USB4215-03-A | B5 | CC2
J1 | USB4215-03-A | B6 | USB_DP_CONN
J1 | USB4215-03-A | B7 | USB_DM_CONN
J1 | USB4215-03-A | B9 | USB_5V
J1 | USB4215-03-A | B12 | GND
J1 | USB4215-03-A | SH | GND
R1 | 5.1k | 1 | CC1
R1 | 5.1k | 2 | GND
R2 | 5.1k | 1 | CC2
R2 | 5.1k | 2 | GND
R3 | 22 | 1 | USB_DM_CONN
R3 | 22 | 2 | USB_DM
R4 | 22 | 1 | USB_DP_CONN
R4 | 22 | 2 | USB_DP
U2 | USBLC6-2SC6 | 1 | USB_DM_CONN
U2 | USBLC6-2SC6 | 2 | GND
U2 | USBLC6-2SC6 | 3 | USB_DP_CONN
U2 | USBLC6-2SC6 | 4 | USB_DP_CONN
U2 | USBLC6-2SC6 | 5 | USB_5V
U2 | USBLC6-2SC6 | 6 | USB_DM_CONN
R8 | 100k | 1 | USB_5V
R8 | 100k | 2 | VBUS_SENSE
R9 | 150k | 1 | VBUS_SENSE
R9 | 150k | 2 | GND
C4 | 100nF 50V | 1 | VBUS_SENSE
C4 | 100nF 50V | 2 | GND
C6 | 1uF 50V | 1 | USB_5V
C6 | 1uF 50V | 2 | GND
R25 | 100k | 1 | CC1
R25 | 100k | 2 | CC1_SENSE
R26 | 100k | 1 | CC2
R26 | 100k | 2 | CC2_SENSE
C15 | 100nF 50V | 1 | CC1_SENSE
C15 | 100nF 50V | 2 | GND
C16 | 100nF 50V | 1 | CC2_SENSE
C16 | 100nF 50V | 2 | GND
U6 | LMR51410YFDBVR | 1 | BUCK_BST
U6 | LMR51410YFDBVR | 2 | GND
U6 | LMR51410YFDBVR | 3 | BUCK_FB
U6 | LMR51410YFDBVR | 4 | VSYS
U6 | LMR51410YFDBVR | 5 | VSYS
U6 | LMR51410YFDBVR | 6 | BUCK_SW
C8 | 10uF 50V | 1 | VSYS
C8 | 10uF 50V | 2 | GND
C9 | 100nF 50V | 1 | BUCK_BST
C9 | 100nF 50V | 2 | BUCK_SW
L1 | 10uH 1.5A Isat1.95A | 1 | BUCK_SW
L1 | 10uH 1.5A Isat1.95A | 2 | +3V3
C10 | 22uF 25V | 1 | +3V3
C10 | 22uF 25V | 2 | GND
C11 | 22uF 25V | 1 | +3V3
C11 | 22uF 25V | 2 | GND
U7 | MT3608 | 1 | BOOST_SW
U7 | MT3608 | 2 | GND
U7 | MT3608 | 3 | BOOST_FB
U7 | MT3608 | 4 | +3V3
U7 | MT3608 | 5 | +3V3
L2 | 4.7uH 2A Isat2.9A | 1 | +3V3
L2 | 4.7uH 2A Isat2.9A | 2 | BOOST_SW
D2 | SS14 | 1 | +5V_DATA
D2 | SS14 | 2 | BOOST_SW
C12 | 22uF 25V | 1 | +3V3
C12 | 22uF 25V | 2 | GND
C13 | 22uF 25V | 1 | +5V_DATA
C13 | 22uF 25V | 2 | GND
R14 | 73.2k | 1 | +5V_DATA
R14 | 73.2k | 2 | BOOST_FB
R15 | 10k | 1 | BOOST_FB
R15 | 10k | 2 | GND
R22 | 100k | 1 | +3V3
R22 | 100k | 2 | BUCK_FB
R23 | 22k | 1 | BUCK_FB
R23 | 22k | 2 | BUCK_FB_LOW
R24 | 10k | 1 | BUCK_FB_LOW
R24 | 10k | 2 | GND
D3 | SMBJ24A | 1 | VSYS
D3 | SMBJ24A | 2 | GND
U8 | SN74AHCT1G125DBVR | 1 | DATA_OE_N
U8 | SN74AHCT1G125DBVR | 2 | GPIO16
U8 | SN74AHCT1G125DBVR | 3 | GND
U8 | SN74AHCT1G125DBVR | 4 | DATA16_5V
U8 | SN74AHCT1G125DBVR | 5 | +5V_DATA
R16 | 100 | 1 | DATA16_5V
R16 | 100 | 2 | DATA16_OUT
R17 | 100k | 1 | DATA16_OUT
R17 | 100k | 2 | GND
R18 | 100k | 1 | GPIO16
R18 | 100k | 2 | GND
C14 | 100nF 50V | 1 | +5V_DATA
C14 | 100nF 50V | 2 | GND
Q4 | MMBT3904 | 1 | DATA_ENABLE_B
Q4 | MMBT3904 | 2 | GND
Q4 | MMBT3904 | 3 | DATA_OE_N
R19 | 10k | 1 | DATA_ENABLE
R19 | 10k | 2 | DATA_ENABLE_B
R20 | 100k | 1 | DATA_ENABLE_B
R20 | 100k | 2 | GND
R21 | 10k | 1 | +5V_DATA
R21 | 10k | 2 | DATA_OE_N
SW1 | TS-1088-AR02016 | 1 | BUTTON_COMMON
SW1 | TS-1088-AR02016 | 2 | GND
U9 | SN74AHCT1G125DBVR | 1 | DATA_OE_N
U9 | SN74AHCT1G125DBVR | 2 | GPIO17
U9 | SN74AHCT1G125DBVR | 3 | GND
U9 | SN74AHCT1G125DBVR | 4 | DATA17_5V
U9 | SN74AHCT1G125DBVR | 5 | +5V_DATA
R27 | 100 | 1 | DATA17_5V
R27 | 100 | 2 | DATA17_OUT
R28 | 100k | 1 | DATA17_OUT
R28 | 100k | 2 | GND
R29 | 100k | 1 | GPIO17
R29 | 100k | 2 | GND
C17 | 100nF 50V | 1 | +5V_DATA
C17 | 100nF 50V | 2 | GND
J2 | 2060-452-HDGC | 1 | GND
J2 | 2060-452-HDGC | 2 | DC_IN
J3 | 2060-452-HDGC | 1 | DATA16_OUT
J3 | 2060-452-HDGC | 2 | GND
J4 | 2060-452-HDGC | 1 | LED_VCC
J4 | 2060-452-HDGC | 2 | DATA17_OUT
D4 | BAT54C | 1 | BOOT
D4 | BAT54C | 2 | GPIO18_BUTTON
D4 | BAT54C | 3 | BUTTON_COMMON
R30 | 10k | 1 | +3V3
R30 | 10k | 2 | GPIO18_BUTTON
TP1 | GND | 1 | GND
TP2 | +3V3 | 1 | +3V3
TP3 | ESP_EN | 1 | ESP_EN
TP5 | USB_FAULT | 1 | USB_FAULT
TP6 | GPIO16 | 1 | GPIO16
TP7 | GPIO17 | 1 | GPIO17
TP8 | +5V_DATA | 1 | +5V_DATA
TP9 | VSYS | 1 | VSYS
TP10 | GPIO18_BUTTON | 1 | GPIO18_BUTTON
TP11 | UART_TX | 1 | UART_TX
TP12 | UART_RX | 1 | UART_RX
F1 | 8A 32V | 1 | DC_IN
F1 | 8A 32V | 2 | DC_FUSED
Q1 | CSD18543Q3A | 1 | DC_FUSED
Q1 | CSD18543Q3A | 2 | DC_FUSED
Q1 | CSD18543Q3A | 3 | DC_FUSED
Q1 | CSD18543Q3A | 4 | DC_GATE
Q1 | CSD18543Q3A | 5 | VSYS
U3 | LM74700QDBVRQ1 | 1 | DC_VCAP
U3 | LM74700QDBVRQ1 | 2 | GND
U3 | LM74700QDBVRQ1 | 3 | DC_FUSED
U3 | LM74700QDBVRQ1 | 4 | VSYS
U3 | LM74700QDBVRQ1 | 5 | DC_GATE
U3 | LM74700QDBVRQ1 | 6 | DC_FUSED
C5 | 100nF 50V | 1 | DC_VCAP
C5 | 100nF 50V | 2 | DC_FUSED
U4 | TPS2553DBVR | 1 | USB_5V
U4 | TPS2553DBVR | 2 | GND
U4 | TPS2553DBVR | 3 | USB_ENABLE
U4 | TPS2553DBVR | 4 | USB_FAULT
U4 | TPS2553DBVR | 5 | USB_ILIM
U4 | TPS2553DBVR | 6 | USB_LIMITED
R10 | 100k | 1 | USB_5V
R10 | 100k | 2 | USB_ENABLE
R11 | 30.1k 1% | 1 | USB_ILIM
R11 | 30.1k 1% | 2 | USB_ILIM_MID
Q2 | MMBT3904 | 1 | DC_SENSE_B
Q2 | MMBT3904 | 2 | GND
Q2 | MMBT3904 | 3 | USB_ENABLE
D1 | 1N4148W | 1 | DC_SENSE_R
D1 | 1N4148W | 2 | DC_FUSED
R12 | 47k | 1 | DC_SENSE_R
R12 | 47k | 2 | DC_SENSE_B
R13 | 100k | 1 | DC_SENSE_B
R13 | 100k | 2 | GND
U5 | LM74700QDBVRQ1 | 1 | USB_VCAP
U5 | LM74700QDBVRQ1 | 2 | GND
U5 | LM74700QDBVRQ1 | 3 | USB_LIMITED
U5 | LM74700QDBVRQ1 | 4 | VSYS
U5 | LM74700QDBVRQ1 | 5 | USB_GATE
U5 | LM74700QDBVRQ1 | 6 | USB_LIMITED
Q3 | CSD18543Q3A | 1 | USB_LIMITED
Q3 | CSD18543Q3A | 2 | USB_LIMITED
Q3 | CSD18543Q3A | 3 | USB_LIMITED
Q3 | CSD18543Q3A | 4 | USB_GATE
Q3 | CSD18543Q3A | 5 | VSYS
C7 | 100nF 50V | 1 | USB_VCAP
C7 | 100nF 50V | 2 | USB_LIMITED
R31 | 30.1k 1% | 1 | USB_ILIM_MID
R31 | 30.1k 1% | 2 | GND
R32 | 30.1k 1% | 1 | USB_ILIM
R32 | 30.1k 1% | 2 | USB_ILIM_HIGH
Q5 | 2N7002 | 1 | USB_HIGH_CURRENT
Q5 | 2N7002 | 2 | GND
Q5 | 2N7002 | 3 | USB_ILIM_HIGH
R33 | 100k | 1 | USB_HIGH_CURRENT
R33 | 100k | 2 | GND
Q6 | CMSA80P06A | 1 | VSYS
Q6 | CMSA80P06A | 2 | VSYS
Q6 | CMSA80P06A | 3 | VSYS
Q6 | CMSA80P06A | 4 | STRIP_GATE
Q6 | CMSA80P06A | 5 | LED_VCC
R34 | 100k | 1 | VSYS
R34 | 100k | 2 | STRIP_GATE
D5 | BZT52C12 | 1 | VSYS
D5 | BZT52C12 | 2 | STRIP_GATE
R35 | 2.2k 0.25W | 1 | STRIP_GATE
R35 | 2.2k 0.25W | 2 | STRIP_PULLDOWN
Q7 | MMBT5551 | 1 | STRIP_USB_BASE
Q7 | MMBT5551 | 2 | GND
Q7 | MMBT5551 | 3 | STRIP_PULLDOWN
R36 | 10k | 1 | USB_STRIP_EN
R36 | 10k | 2 | STRIP_USB_BASE
R37 | 100k | 1 | STRIP_USB_BASE
R37 | 100k | 2 | GND
Q8 | MMBT5551 | 1 | STRIP_DC_BASE
Q8 | MMBT5551 | 2 | GND
Q8 | MMBT5551 | 3 | STRIP_PULLDOWN
R38 | 10k | 1 | DC_SENSE_R
R38 | 10k | 2 | STRIP_DC_BASE
R39 | 100k | 1 | STRIP_DC_BASE
R39 | 100k | 2 | GND
R40 | 100k | 1 | LED_VCC
R40 | 100k | 2 | GND
