luxio-lighting/luxio-hardware/LX0001/v1.0.0/Assets/connectors/JLCEDA-C55251566/HDGC_2060_452_C55251566.step

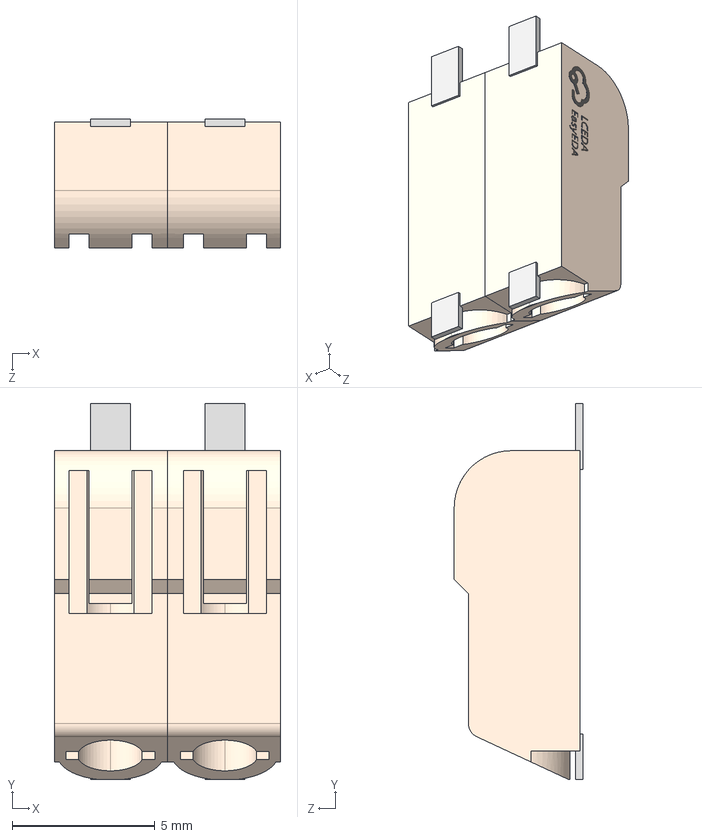
[picture p26: CAD file, 2026-11-11]
LX0001/v1.0.0/Assets/connectors/JLCEDA-C55251566/HDGC_2060_452_C55251566.step
7.91 x 13.2 x 4.50 mm
