luxio-lighting/luxio-hardware/(list of files, cad)

Other CAD files:
LX0001/v1.0.0/Assets/connectors/JLCEDA-C55251566/HDGC_2060_452_C55251566_preview.obj
