luxio-lighting/luxio-hardware/LX0001/v1.0.0/Export/manufacturing-geometry-check.txt

PASS: independent drill / solder-paste geometry check.
Board: /Users/emile/Git/@luxio-lighting/luxio-hardware/LX0001/v1.0.0/Source/LX0001.kicad_pcb
SHA256: 3cc160da4f7fa13ef59384af6bed833262a5ae5767c5308019eb83b8bfa82ea1
189 drilled items (181 vias), 320 paste apertures, 60480 comparisons.
Via-in-paste allowlist: empty. Net equality does not suppress any intersection.
Minimum routing-via drill/paste clearance: 0.100 mm (1nm numerical allowance).
Reviewed connector pin-in-paste slots: 4. These are J1 component stakes, not routing vias.
Violations: 0.
