luxio-lighting/luxio-hardware/LX0001/v1.0.0/Assets/review-history/two-layer-fabrication-intent.txt

LX0001 v1.0.0 — fabrication and assembly intent

Board: 60.0 x 20.0 mm, two copper layers, FR-4, 1.6 mm nominal, 1 oz finished
copper on each side. Black solder mask BOTH sides; white silkscreen. Lead-free
ENIG finish for fine-pitch QFN/RF assembly. Components on BOTH sides. Supply
a panel with tooling rails/fiducials suitable for JLCPCB standard two-side PCBA;
array/rail design belongs to the assembler and must preserve the RF keepout.
Do not change copper thickness without rechecking QFN clearances and RF geometry.

M2 mounting: two 2.2 mm NPTH at (9.0,17.0) and (42.0,3.0) mm measured from the
top-left board corner. Use heads/standoffs no larger than 4.4 mm diameter.
The associated copper/trace/via clearance is 4.6 mm diameter. Add enclosure
strain relief for wiring and USB insertion. No metal/case wall over the antenna.
The centered BOOT/USER button actuator is at (30.0,10.0) mm on the top side.

Input J2 and output J3/J4 are HDGC 2060-452-HDGC, JLCPCB C55251566. Connector
pin numbering is assigned by this design because the mechanical part is
unpolarized. Use schematic, top assembly drawing and silkscreen for wiring.
Viewed from the top with input left/output right, output order from top to
bottom is GND, GPIO16 (5 V logic), GPIO17 (5 V logic), VCC. Input is GND then
VCC from top to bottom. Output VCC follows selected input voltage; it is not
regulated to a strip's required voltage. Choose a matching external supply.

J1 USB-C is centered underside at the input end; GCT USB4215-03-A, C37616412.
Its four metal shell stakes are only 0.80 +/-0.20 mm deep and stay recessed
inside the 1.6 mm PCB. There are no plastic locating pegs. Shell annuli have
component-side mask/paste openings only; top annuli remain mask-covered.
A nominal 0.13 mm annulus/body-edge overlap with the top terminal is an
intentional opposite-side mechanical exception. Do not form a top-side solder
fillet under the terminal; inspect the first article after PIP reflow.
Exact derivation: Assets/io/C37616412_footprint_notes.txt. The earlier HDGC
C2936195 and HRO C165948 USB choices are superseded reference evidence.
Keep manufacturer front/rear terminal lands and verify the assembler's body
origin against the annotated mechanical drawings, especially the HDGC terminal
whose body-to-pad registration is graphical rather than dimensioned.

Minimum electrical clearance 0.127 mm. Ordinary signal width is 0.15 mm;
reviewed short, low-current escapes may use 0.127 mm (including the short BUCK_FB_LOW neck).
NPTH-to-copper minimum 0.20 mm. USB shell holes are plated slots.
Signal vias use 0.45/0.20 mm; power and ground banks retain larger vias where
specified in the board. Tent ordinary vias with mask. Keep routing-via drills
at least 0.10 mm from solder-paste apertures. Do not expose through vias in QFN solder
paste apertures without a filled/capped-via process and updated stencil review.

The ceramic antenna is Walsin RFECA3216060A1T, C127620, at (14.5,1.5) mm.
Preserve its Type1 8 x 3 mm middle-edge clearance window: x=10.5..18.5 mm,
y=0..3 mm. Bottom copper, pads and vias are prohibited there; top copper
contains only the deliberate manufacturer antenna lands and feed pattern.
The split FEED/GND lands and opposite tuning land are specified by Walsin
ASC_RFECA3216060A1T_V09 page 3, saved as
Assets/core/Walsin-RFECA3216060A1T-V09.pdf. L104 is an optional DNP antenna
tuning position; do not populate its 0-ohm candidate without RF measurement.
Maintain continuous bottom ground beneath the RF feed outside this window.
The router-only reference-ground protection must not remove the final ground
pour. See Source/antenna_routing_proposal.json and Source/core_notes.txt.
Matching values are initial reference values. Antenna matching, feed impedance
and radiated performance need first-article measurement in the intended case.
The short feed exit differs from the manufacturer's test-board geometry.
A two-layer board order is not a calibrated RF impedance coupon or RF
certification. The former RFANT corner antenna is superseded.

JLCPCB BOM/CPL use selected supplier C-codes. Cost/stock evidence is a dated
snapshot, not a reservation. The component-only estimate excludes PCB, ENIG,
assembly, setup, feeder fees, attrition, tax and shipping. Obtain the live quote
and review assembly rotations, substitutions and bottom-side mirroring before
accepting a manufacturing order. No fabrication order is placed by this task.
