luxio-lighting/luxio-hardware/LX0001/v1.0.0/Assets/review-history/stacked-inputs-665mm/Export/assembly-top.png

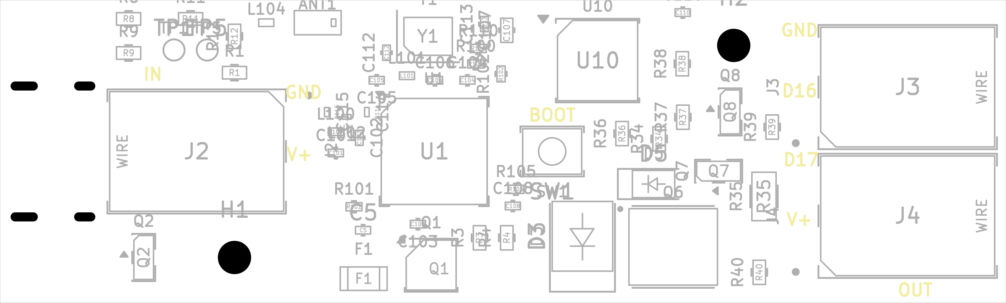
LX0001/v1.0.0/Assets/review-history/stacked-inputs-665mm/Export/assembly-top.png
