luxio-lighting/luxio-hardware/LX0001/v1.0.0/Export/assembly-top.png

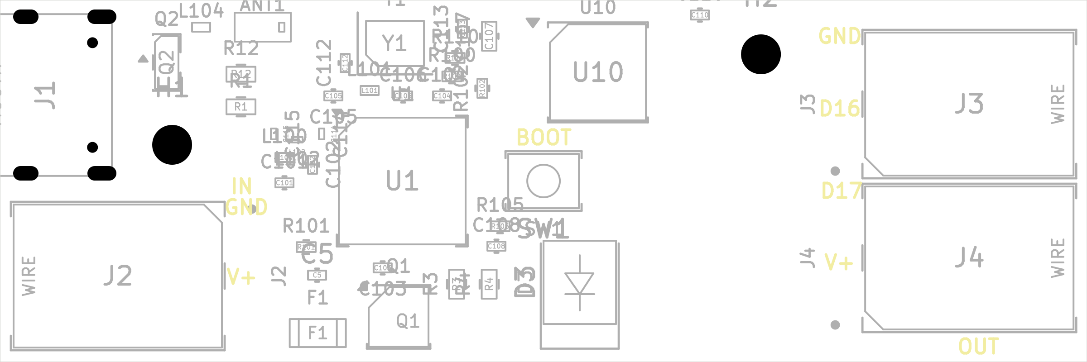
LX0001/v1.0.0/Export/assembly-top.png
