luxio-lighting/luxio-hardware/LX0001/v1.0.0/Assets/review-history/stacked-inputs-665mm/Export/README.txt

LX0001 v1.0.0 — 66.5 x 20 mm four-layer fabrication package

Upload LX0001-v1.0.0-Gerbers.zip with JLCPCB-BOM.csv and JLCPCB-CPL.csv.
Use JLCPCB-order-settings.txt: JLC04161H-7628, 1.6 mm, 1 oz outer/0.5 oz
inner copper, black mask, ENIG, two-sided assembly, minimum via drill 0.30 mm.
Re-upload both Gerbers and CPL: the fabrication origin changed with the outline.

109 fitted components; L104 is DNP. Bare test pads and mounting holes are
excluded from assembly. Review normal supplier placement orientations.
The USB shell holes now clear the opposite-side terminal. No special
courtyard exception or no-top-fillet mounting restriction remains.

CAD checks: zero DRC findings or exclusions, zero unconnected nets, zero
schematic parity differences and clean ERC. All 249 routing vias use 0.30 mm
drills, are tented, and meet the independent 0.10 mm drill/paste check.
The four shell pins intersect their own PIP apertures as intended.

Hardware remains unbuilt. First-article electrical, 5 A thermal, RF, USB and
assembly validation is required before the 100-board lot. Firmware is not
included. No manufacturing order has been placed.

Source/LX0001.kicad_pcb is the editable board. Previous packages in
Assets/review-history are historical evidence, not manufacturing inputs.
