luxio-lighting/luxio-hardware/LX0001/v1.0.0/Assets/review-history/usb-overlap-before-665mm/Export/README.txt

LX0001 v1.0.0 — final four-layer fabrication package

Upload LX0001-v1.0.0-Gerbers.zip for PCB fabrication and JLCPCB-BOM.csv /
JLCPCB-CPL.csv for two-sided assembly. Apply JLCPCB-order-settings.txt,
including JLC04161H-7628, 1.6mm, 1oz outer/0.5oz inner copper, black mask
and ENIG. Select minimum via hole 0.30 mm. Keep the exact stackup and antenna keepout.

The BOM contains109 fitted components. L104 is DNP. Bare test pads and
mounting holes are excluded. Review supplier placement rotations and the
recessed USB shell-stake PIP assembly detail in the assembly preview.

CAD checks: zero unconnected nets, zero schematic parity differences, zero
ERC findings, all246 routing vias with 0.30mm holes, tented and independently checked for
0.10mm drill-to-paste clearance. Four specifically documented USB shell
stake / top terminal courtyard flags remain. They are not waived globally.

Hardware has not been built. First-article electrical,5A thermal,RF tuning,
USB and assembly validation remain necessary before the100-board lot.
Source/first-article-validation.txt and firmware-interface.txt define that
work. Firmware is not included. No manufacturing order has been placed.

Historical candidates are archived in Assets/review-history and are not
manufacturing inputs. The editable final board is Source/LX0001.kicad_pcb.
