luxio-lighting/luxio-hardware/LX0001/v1.0.0/Assets/review-history/authoring-progress/production-work/README.txt

INCOMPLETE ENGINEERING CANDIDATE — NOT FOR FABRICATION

This candidate improves on the34-open main Source checkpoint but still has30 open connections. Do not send it for assembly. Main Source remains unchanged.

Changes: C104 ground via with nearby EN/3V3 via spacing; smaller relocated TP3 retained; C4 ground via between ESP32 paste windows; DC_VCAP escape; R2 GND with split J2 paste aperture; U5 gate escape; additional DC_FUSED route.

The TP3 and J2 footprint edits still require library/generator synchronization and assembly review. All mapping and paste geometry checks pass; those checks do not establish electrical function, current capability or production qualification.

Other private ground-return candidates were rejected for shorts/clearance failures and are not included here.
