luxio-lighting/luxio-hardware/LX0001/v1.0.0/Assets/review-history/authoring-progress/preview-centered-bottom.png

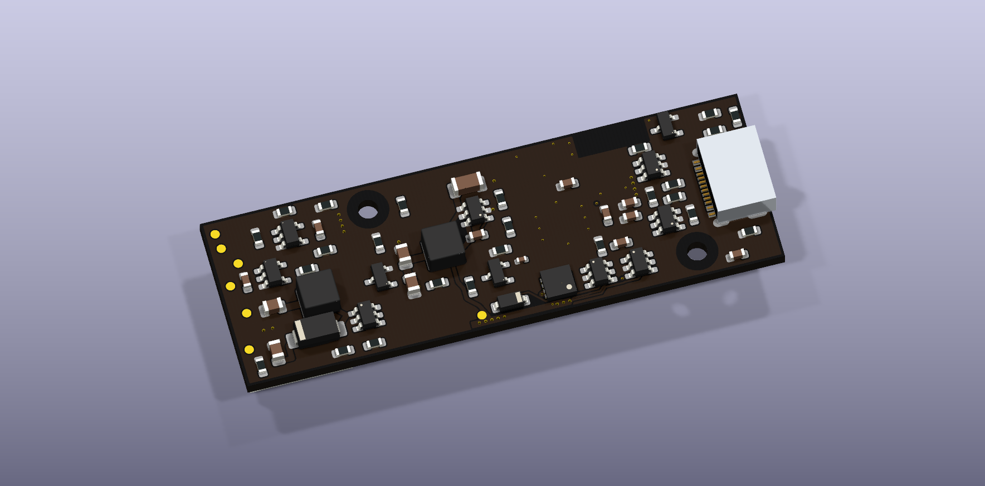
LX0001/v1.0.0/Assets/review-history/authoring-progress/preview-centered-bottom.png
