luxio-lighting/luxio-hardware/LX0001/v1.0.0/Assets/review-history/authoring-progress/preview-routing-bottom.png

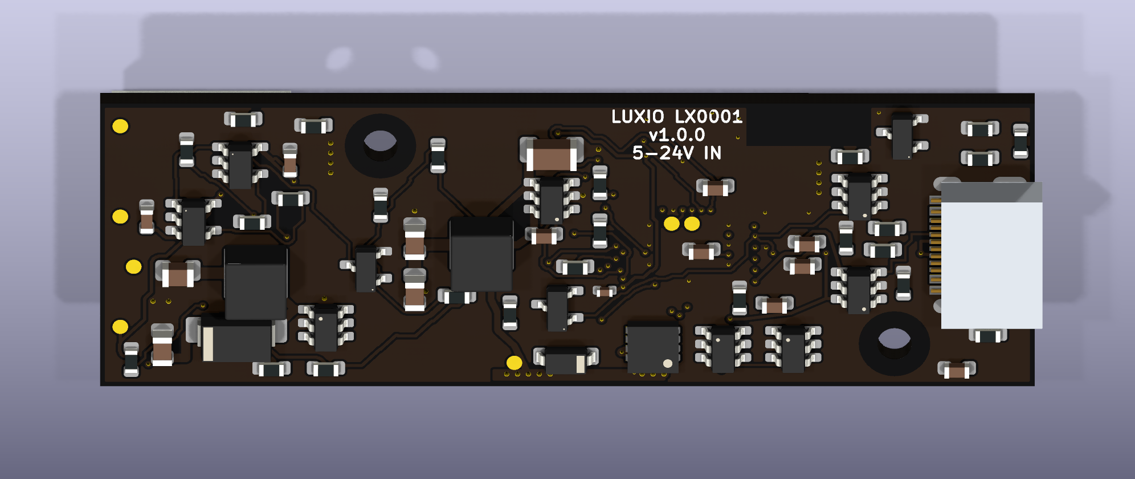
LX0001/v1.0.0/Assets/review-history/authoring-progress/preview-routing-bottom.png
