luxio-lighting/luxio-hardware/LX0001/v1.0.0/Assets/review-history/before-library-3d-models/Export/preview-top.png

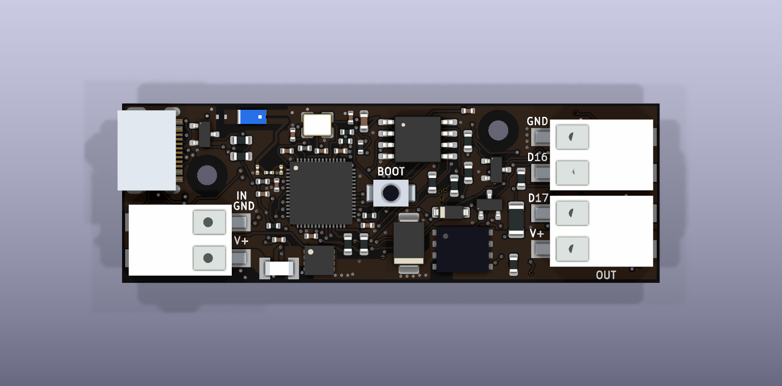
LX0001/v1.0.0/Assets/review-history/before-library-3d-models/Export/preview-top.png
