luxio-lighting/luxio-hardware/LX0001/v1.0.0/Assets/review-history/stacked-inputs-665mm/Export/preview-bottom.png

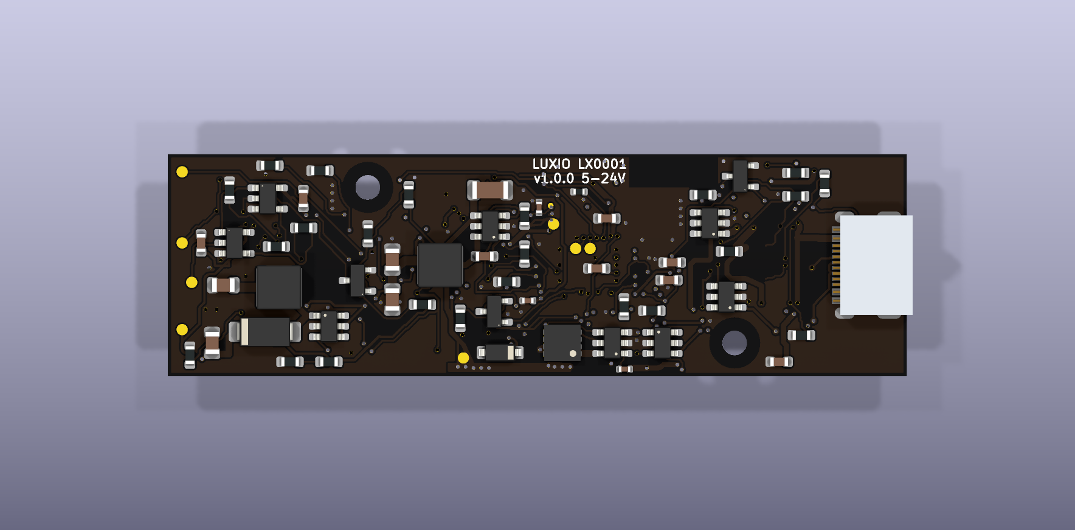
LX0001/v1.0.0/Assets/review-history/stacked-inputs-665mm/Export/preview-bottom.png
