luxio-lighting/luxio-hardware/LX0001/v1.0.0/Assets/review-history/usb-overlap-before-665mm/Export/copper-top.png

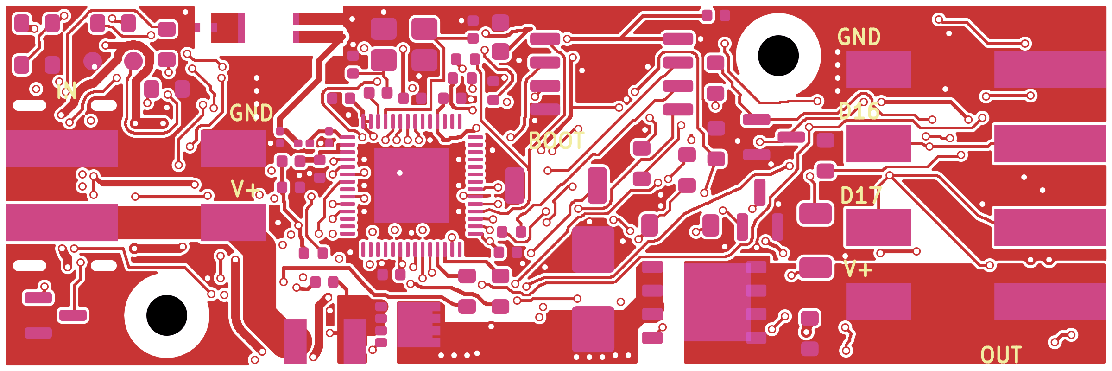
LX0001/v1.0.0/Assets/review-history/usb-overlap-before-665mm/Export/copper-top.png
