luxio-lighting/luxio-hardware/LX0001/v1.0.0/Assets/review-history/before-library-3d-models/Export/schematic.pdf

1 | 2 | 3 | 4 | 5 | 6 | 7 | 8

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
Size: A3 | Rev: 1.0.0 | F Date: 2026-11-11
KiCad E.D.A. 10.0.7 | Id: 1/14

# Title: LX0001 digital LED controller

### File: LX0001.kicad_sch

### Sheet: /

Luxio

MCU power, straps and 40 MHz clock (continued) File: core_2.kicad_sch | 4 MB flash and SPI termination

File: flash.kicad_sch Wired priority and USB current limiting

File: power.kicad_sch | Wired priority and USB current limiting (continued) File: power_2.kicad_sch
Two 5 V data outputs and strip terminals File: outputs.kicad_sch | Centered BOOT / GPIO18 button

File: button.kicad_sch

ESP32-S3 / no PSRAM

File: mcu.kicad_sch | MCU power, straps and 40 MHz clock File: core.kicad_sch 2.4 GHz ceramic antenna and RF matching
File: rf.kicad_sch | USB-C data and source detection
File: usb.kicad_sch 3.3 V buck and 5 V logic boost File: regulators.kicad_sch | 3.3 V buck and 5 V logic boost (continued) File: regulators_2.kicad_sch Production and recovery test pads File: test.kicad_sch

60 x 20 mm / 4 copper layers / black solder mask / 5 A at 24 V design target 4 MB flash, no PSRAM. USB powers 5 V strips only. Wired input has priority. Initial fabrication design: assembled electrical, thermal and RF validation required.

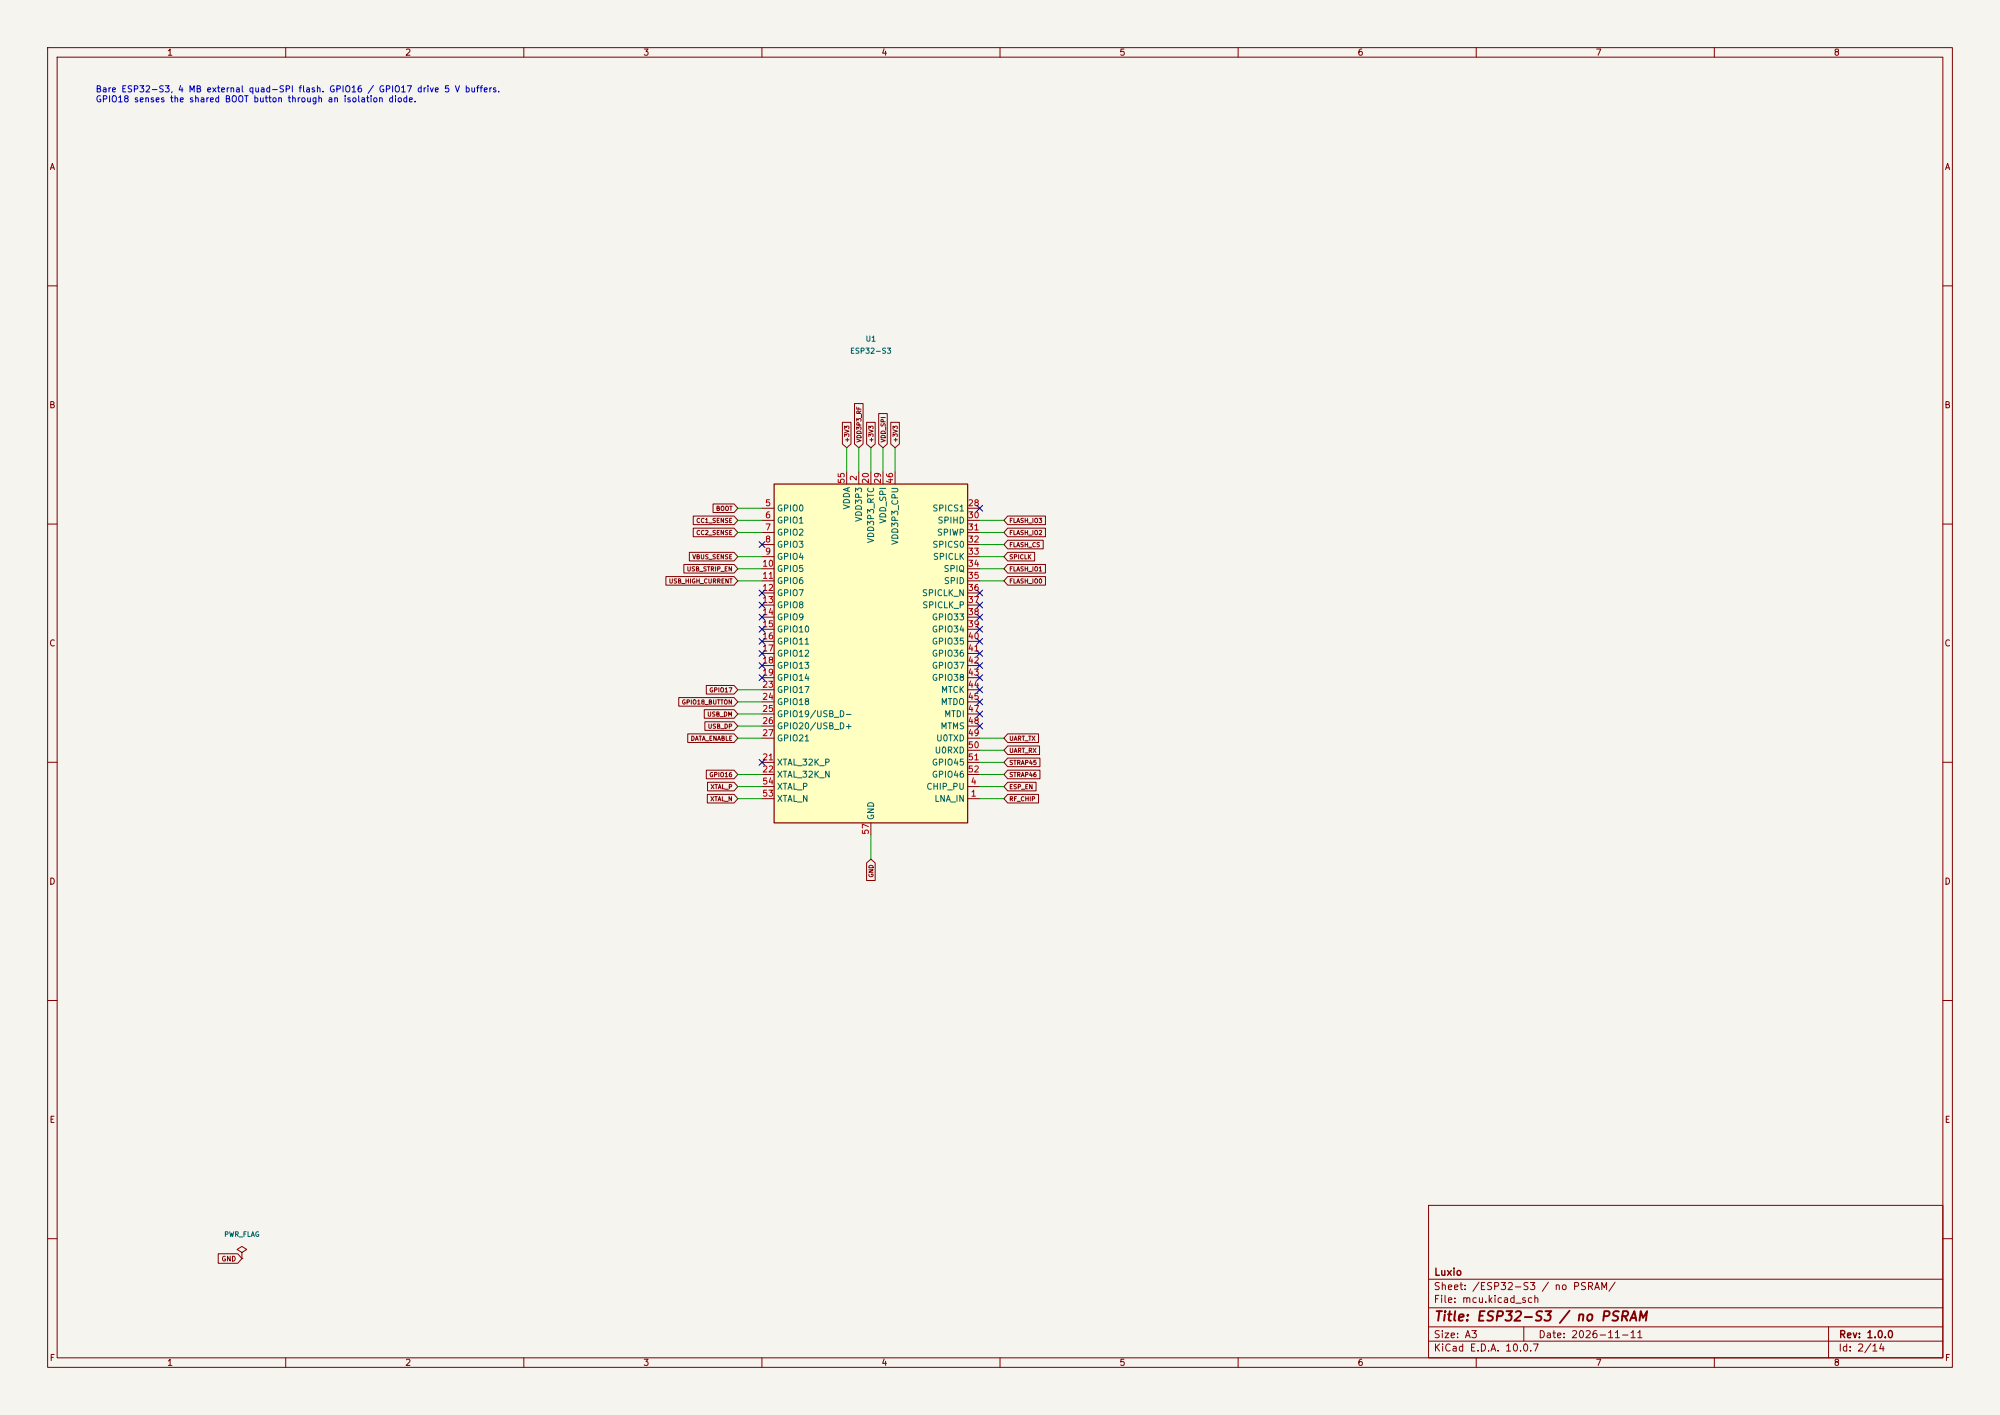
[picture p58: page 2]

Bare ESP32-S3, 4 MB external quad-SPI flash. GPIO16 / GPIO17 drive 5 V buffers. GPIO18 senses the shared BOOT button through an isolation diode.

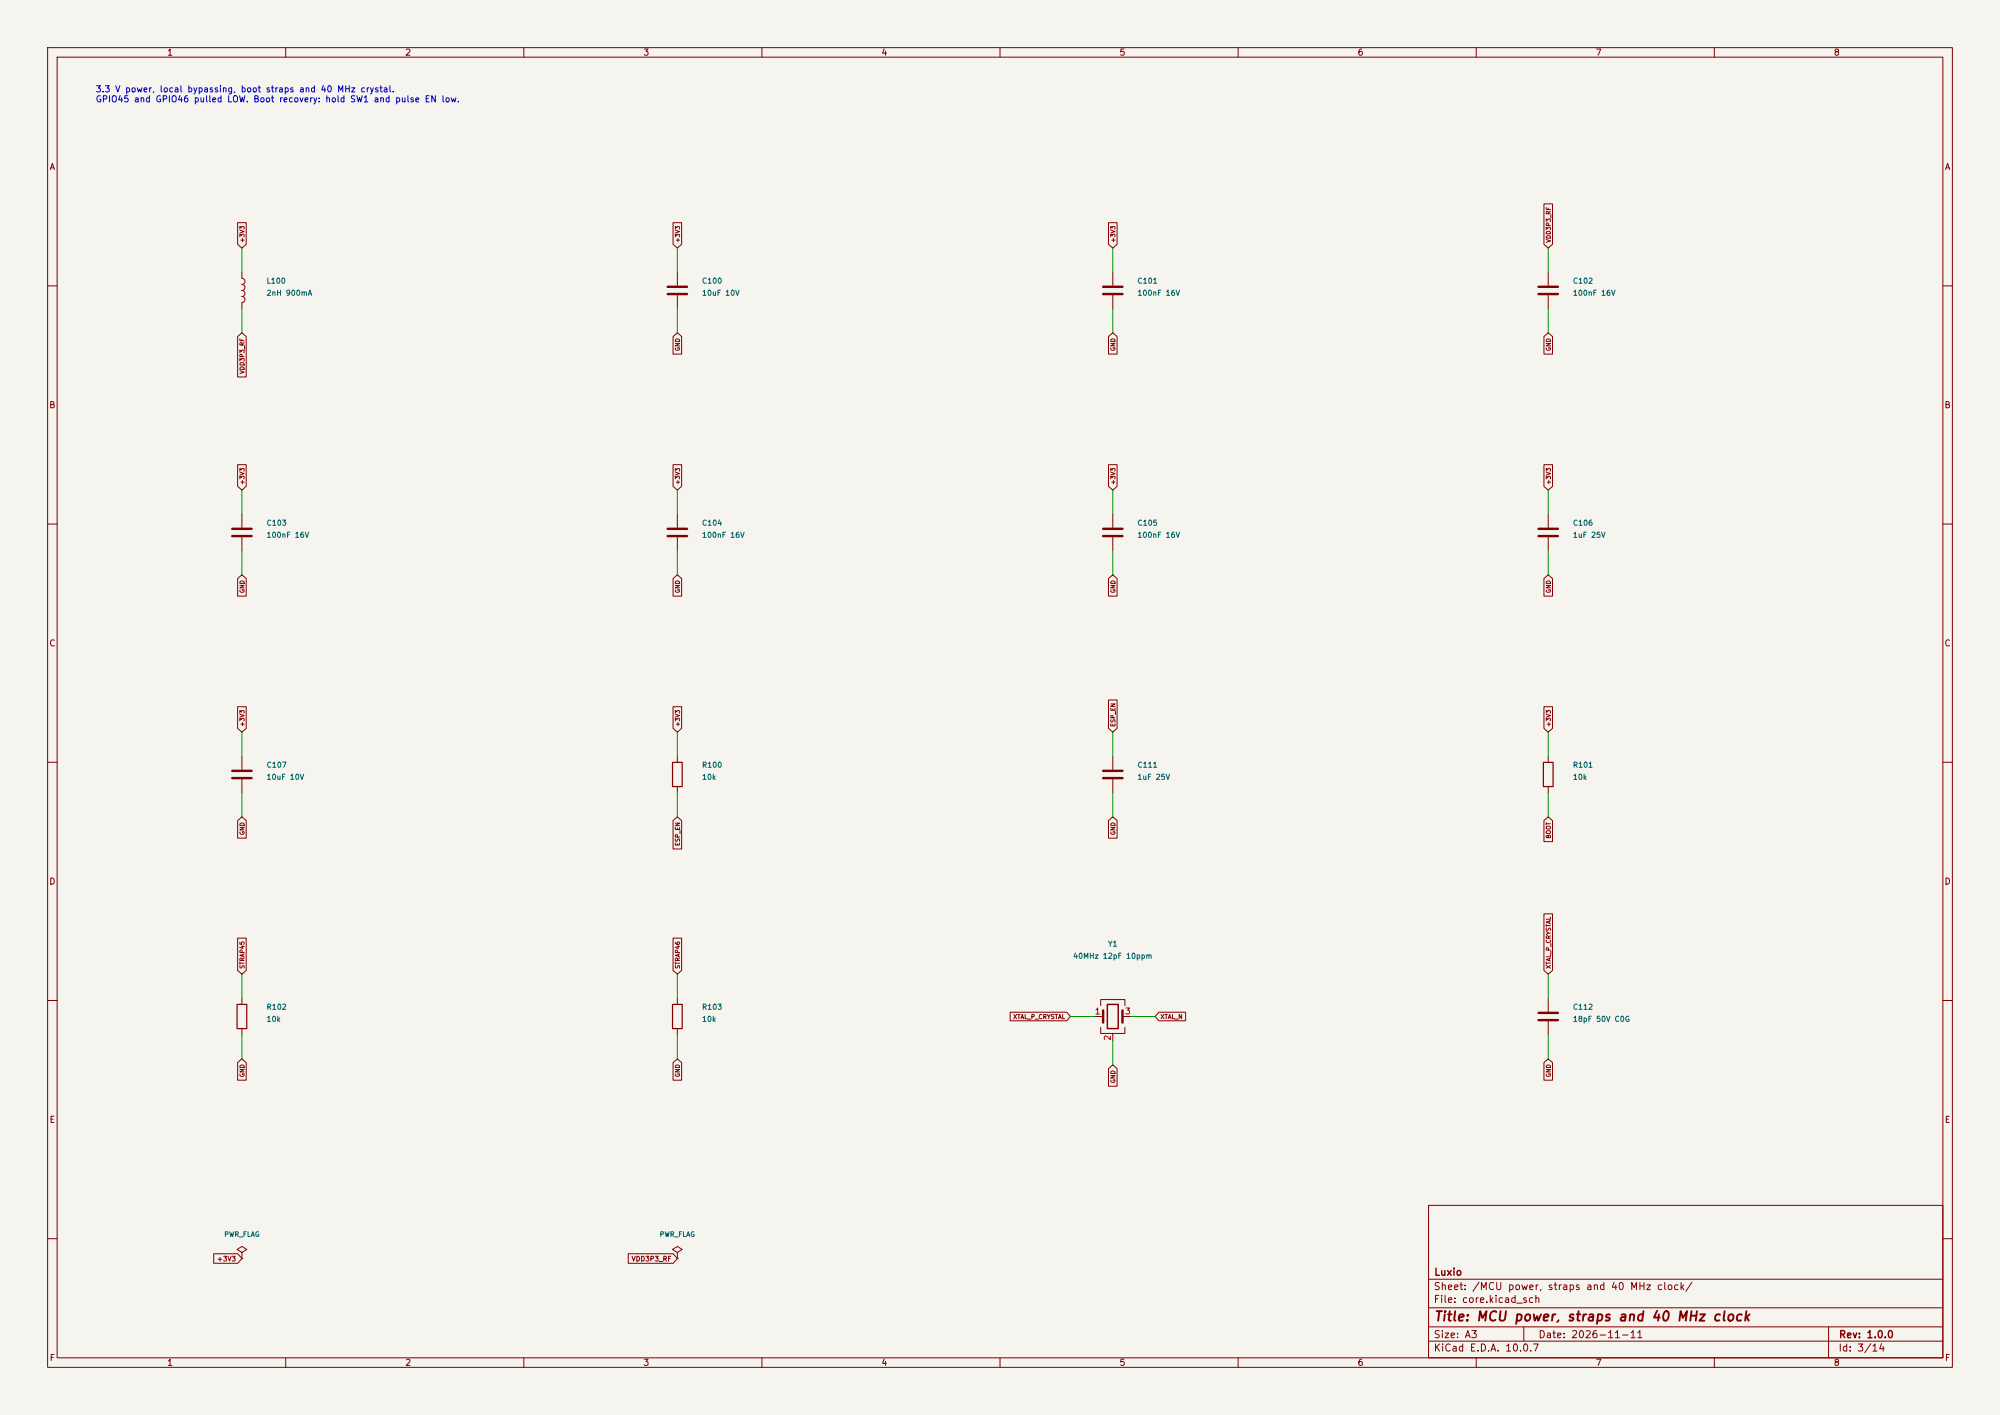
[picture p59: page 3]

Luxio
Sheet: /MCU power, straps and 40 MHz clock/
File: core.kicad_sch
Title: MCU power, straps and 40 MHz clock

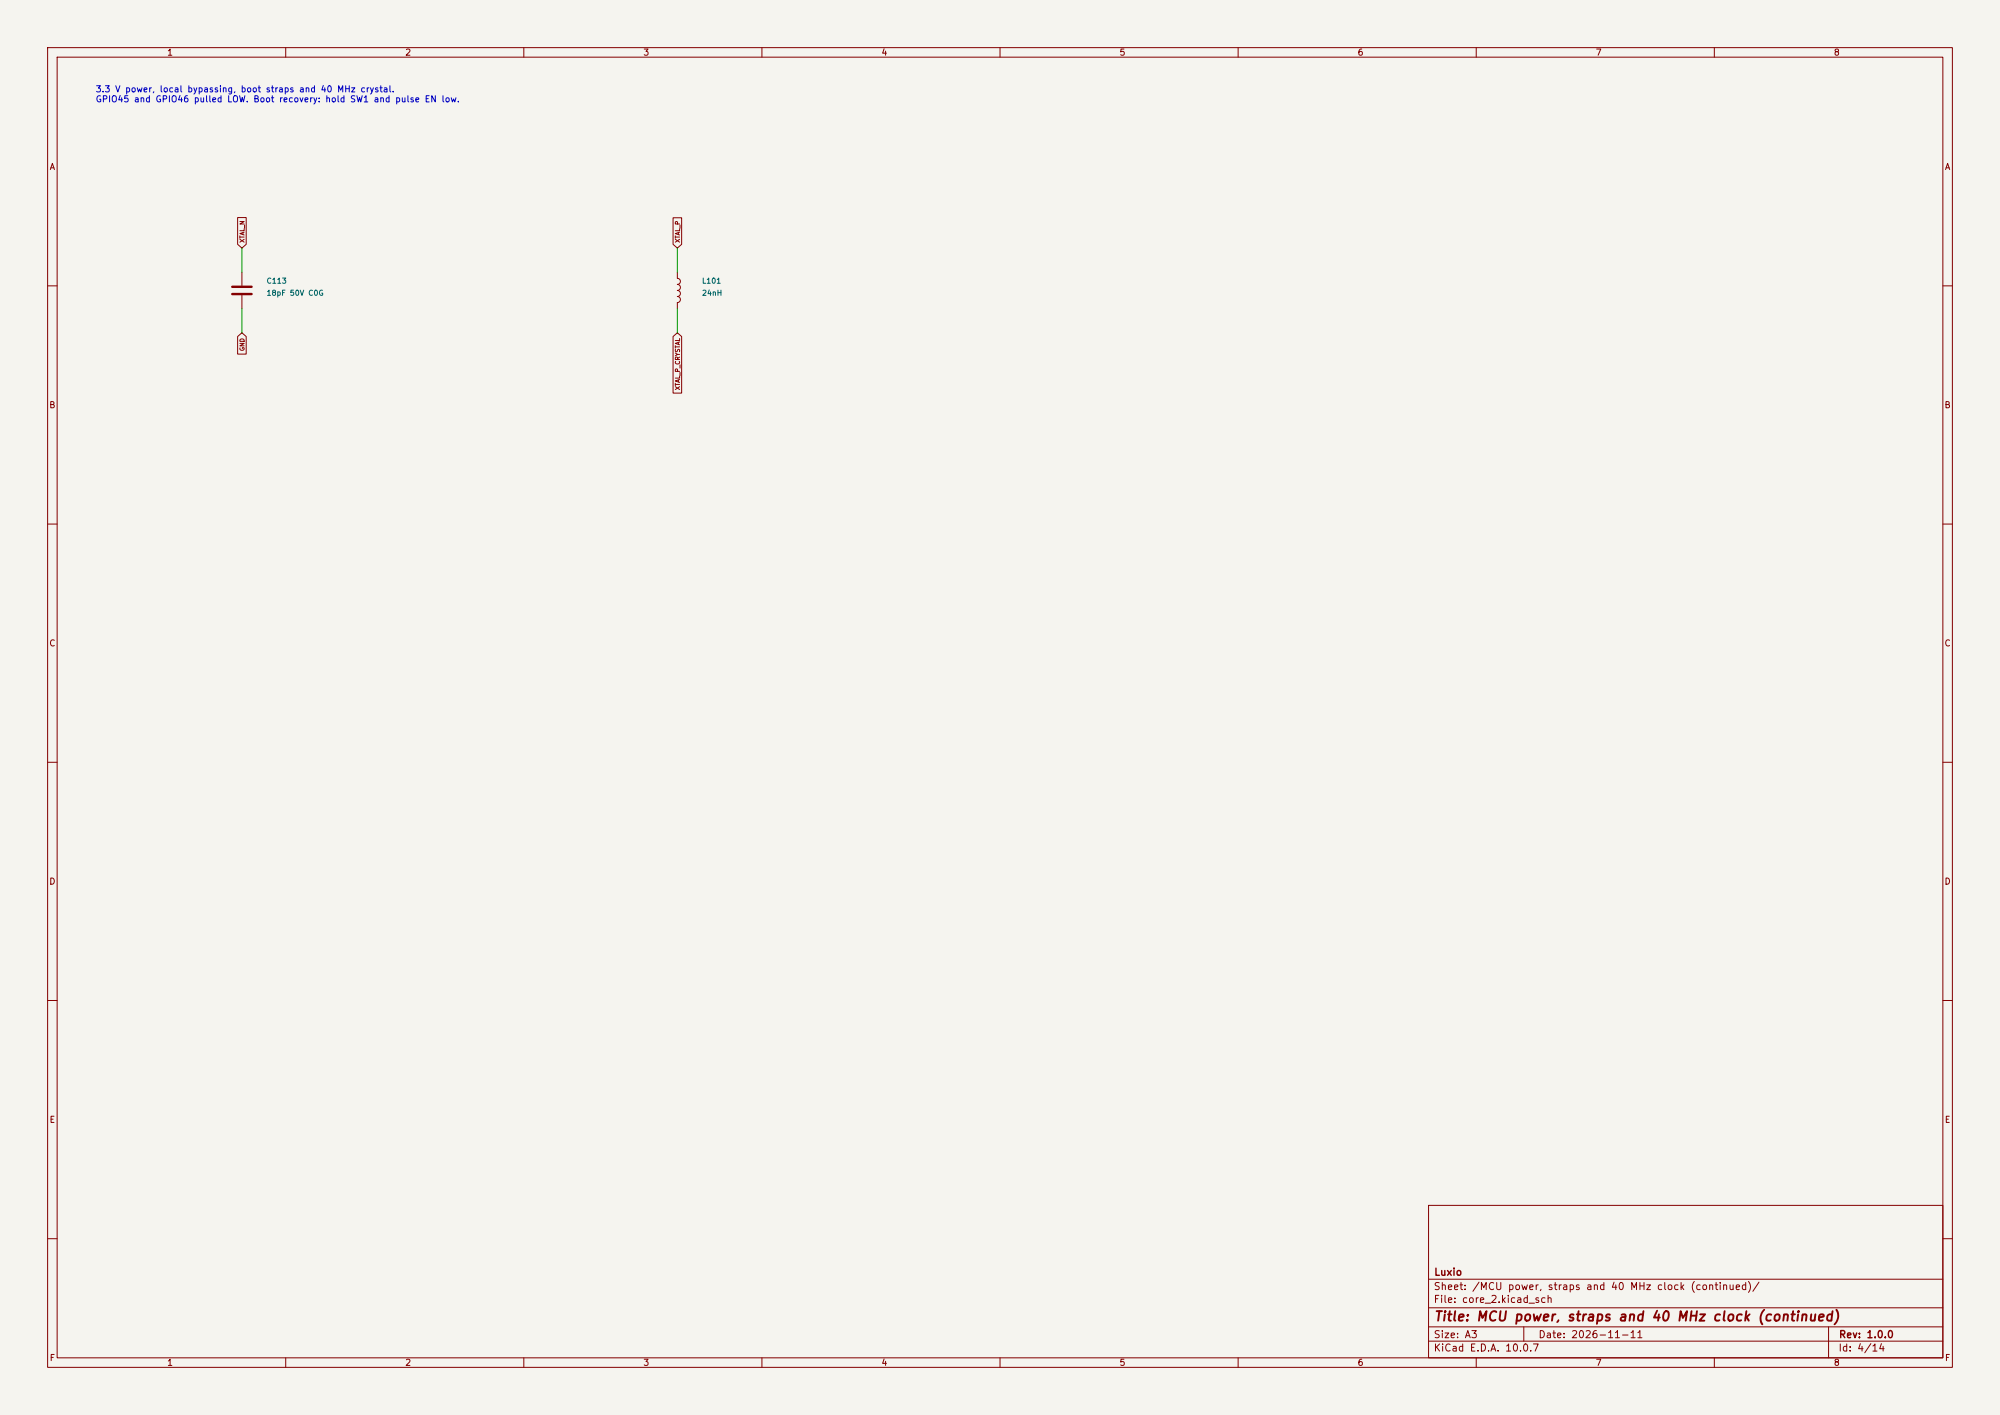
[picture p60: page 4]

3.3 V power, local bypassing, boot straps and 40 MHz crystal. GPIO45 and GPIO46 pulled LOW. Boot recovery: hold SW1 and pulse EN low.

Luxio
Sheet: /MCU power, straps and 40 MHz clock (continued)/
File: core_2.kicad_sch
Title: MCU power, straps and 40 MHz clock (continued)

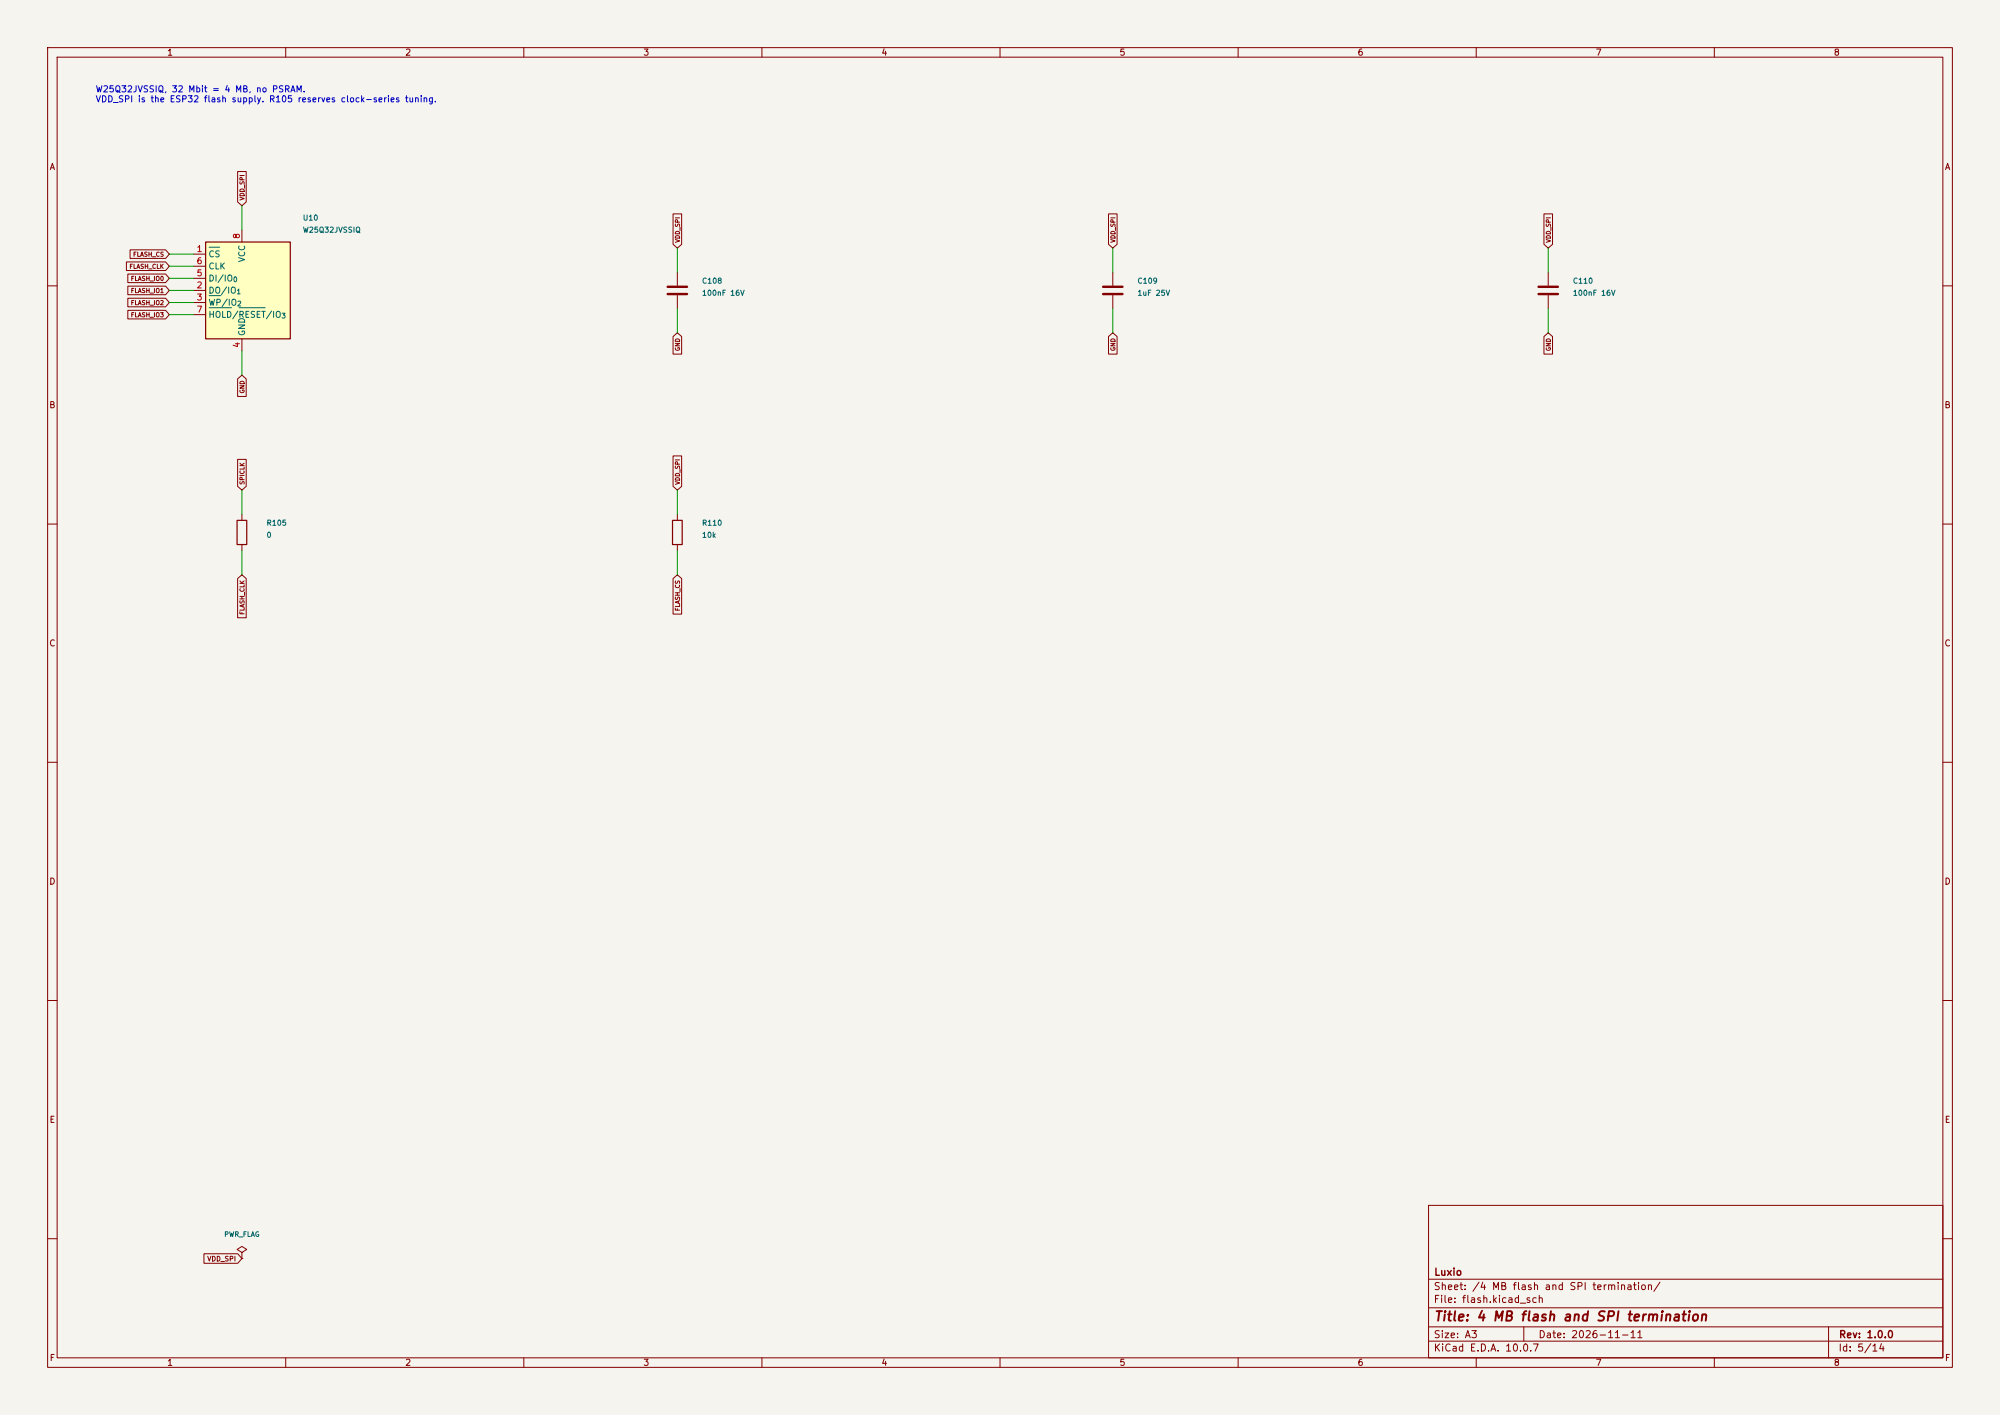
[picture p61: page 5]

W25Q32JVSSIQ, 32 Mbit = 4 MB, no PSRAM. VDD_SPI is the ESP32 flash supply. R105 reserves clock-series tuning.

4 DI/IO0 5 CLK 6 HOLD/RESET/IO3 7 VCC

Luxio
Sheet: /4 MB flash and SPI termination/
File: flash.kicad_sch
Title: 4 MB flash and SPI termination

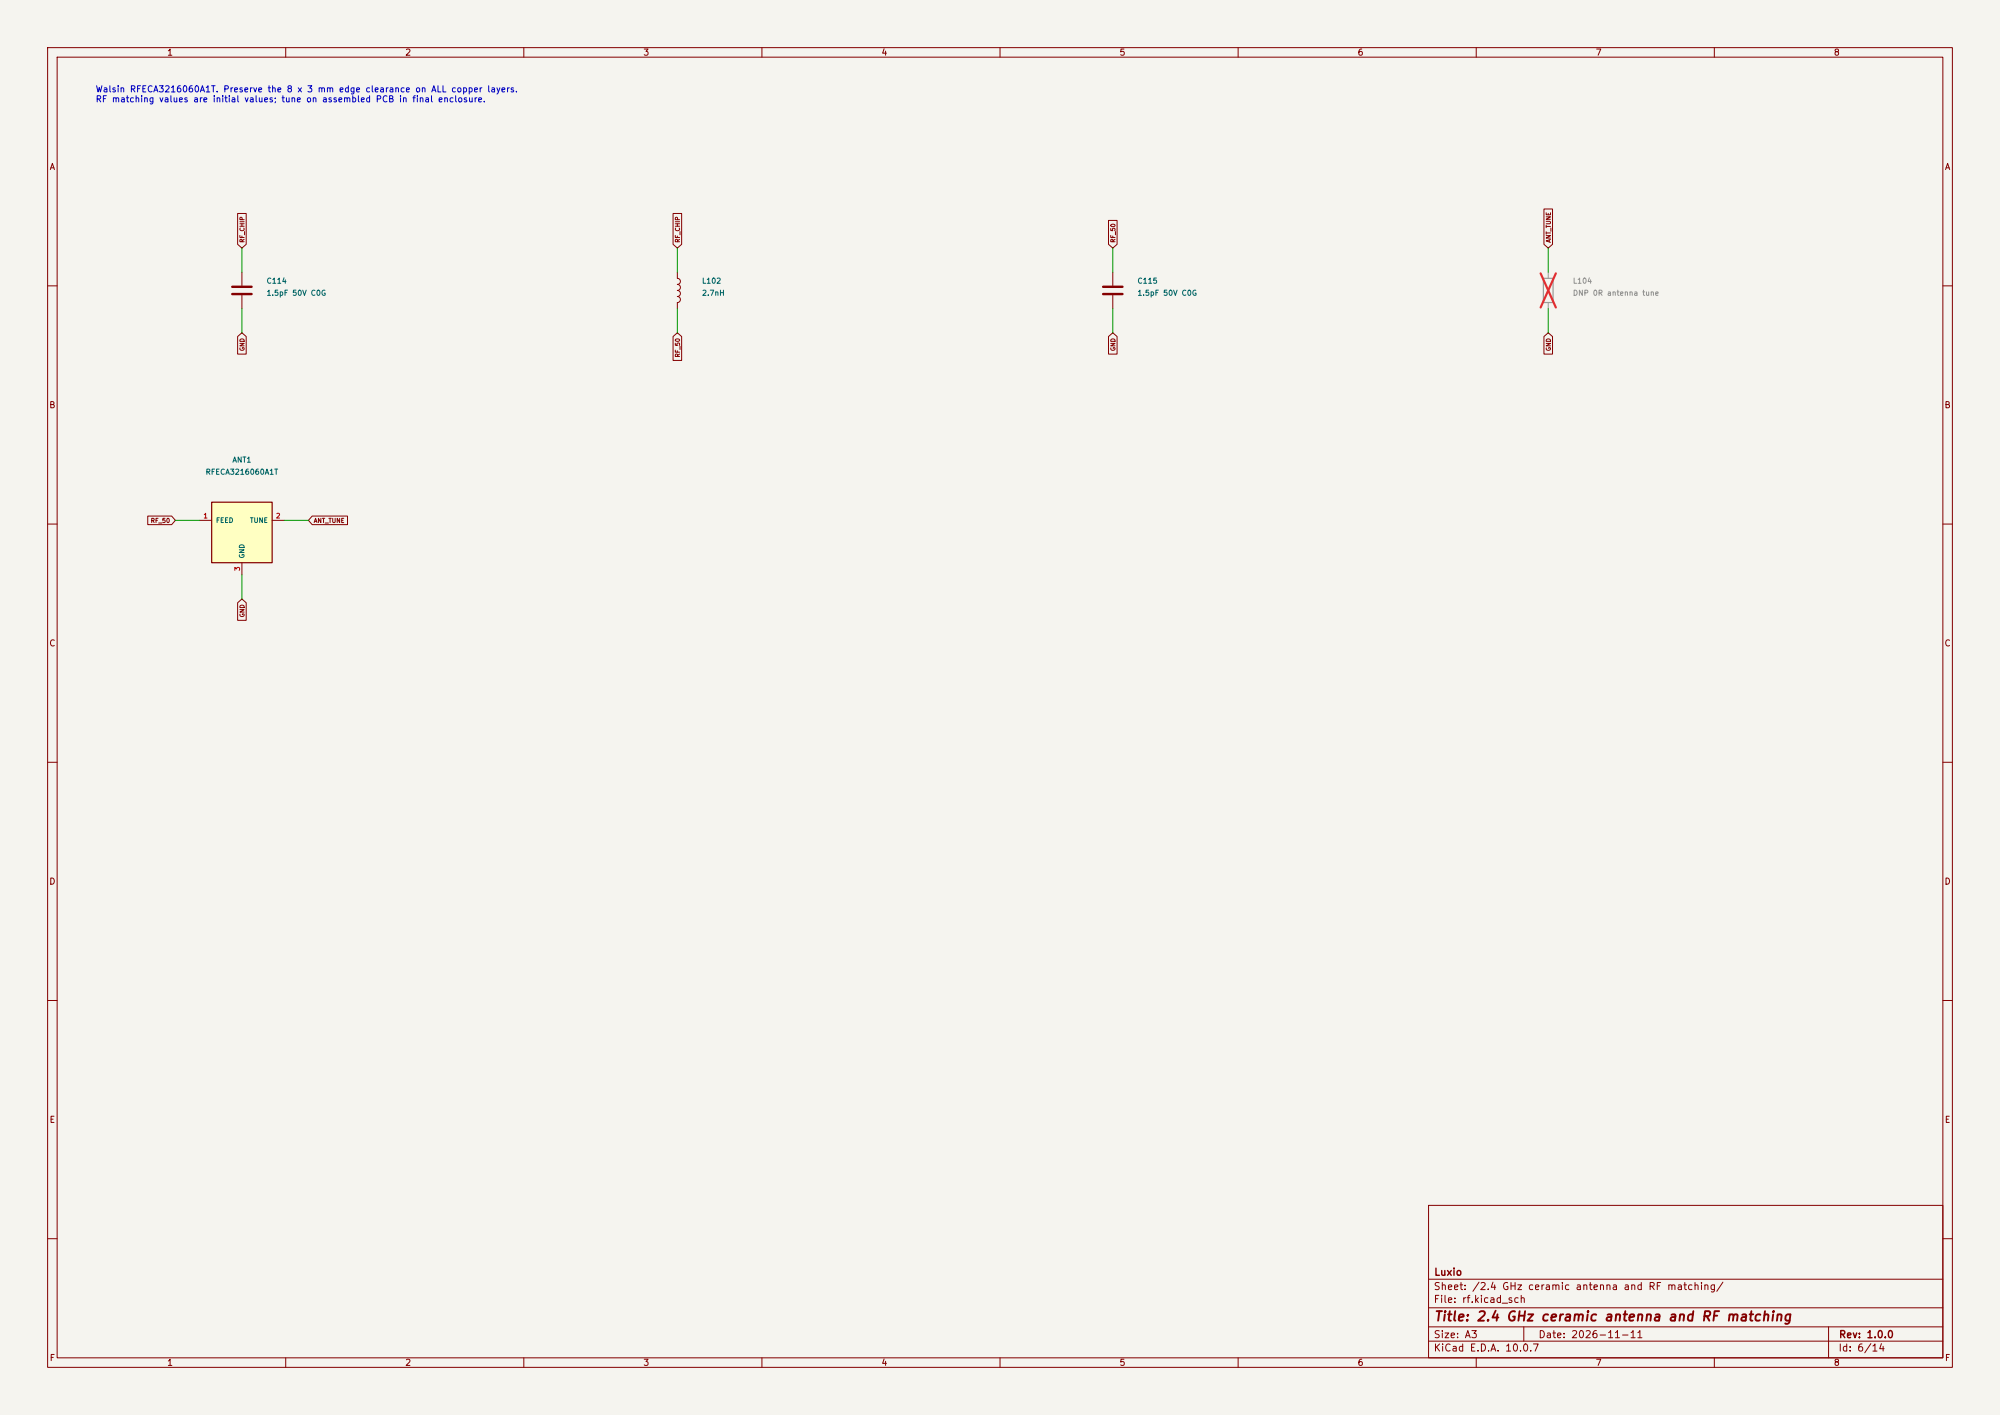
[picture p62: page 6]

Walsin RFECA3216060A1T. Preserve the 8 x 3 mm edge clearance on ALL copper layers. RF matching values are initial values; tune on assembled PCB in final enclosure.
ANT_TUNE RF_CHIP

Luxio
Sheet: /2.4 GHz ceramic antenna and RF matching/
File: rf.kicad_sch
Title: 2.4 GHz ceramic antenna and RF matching

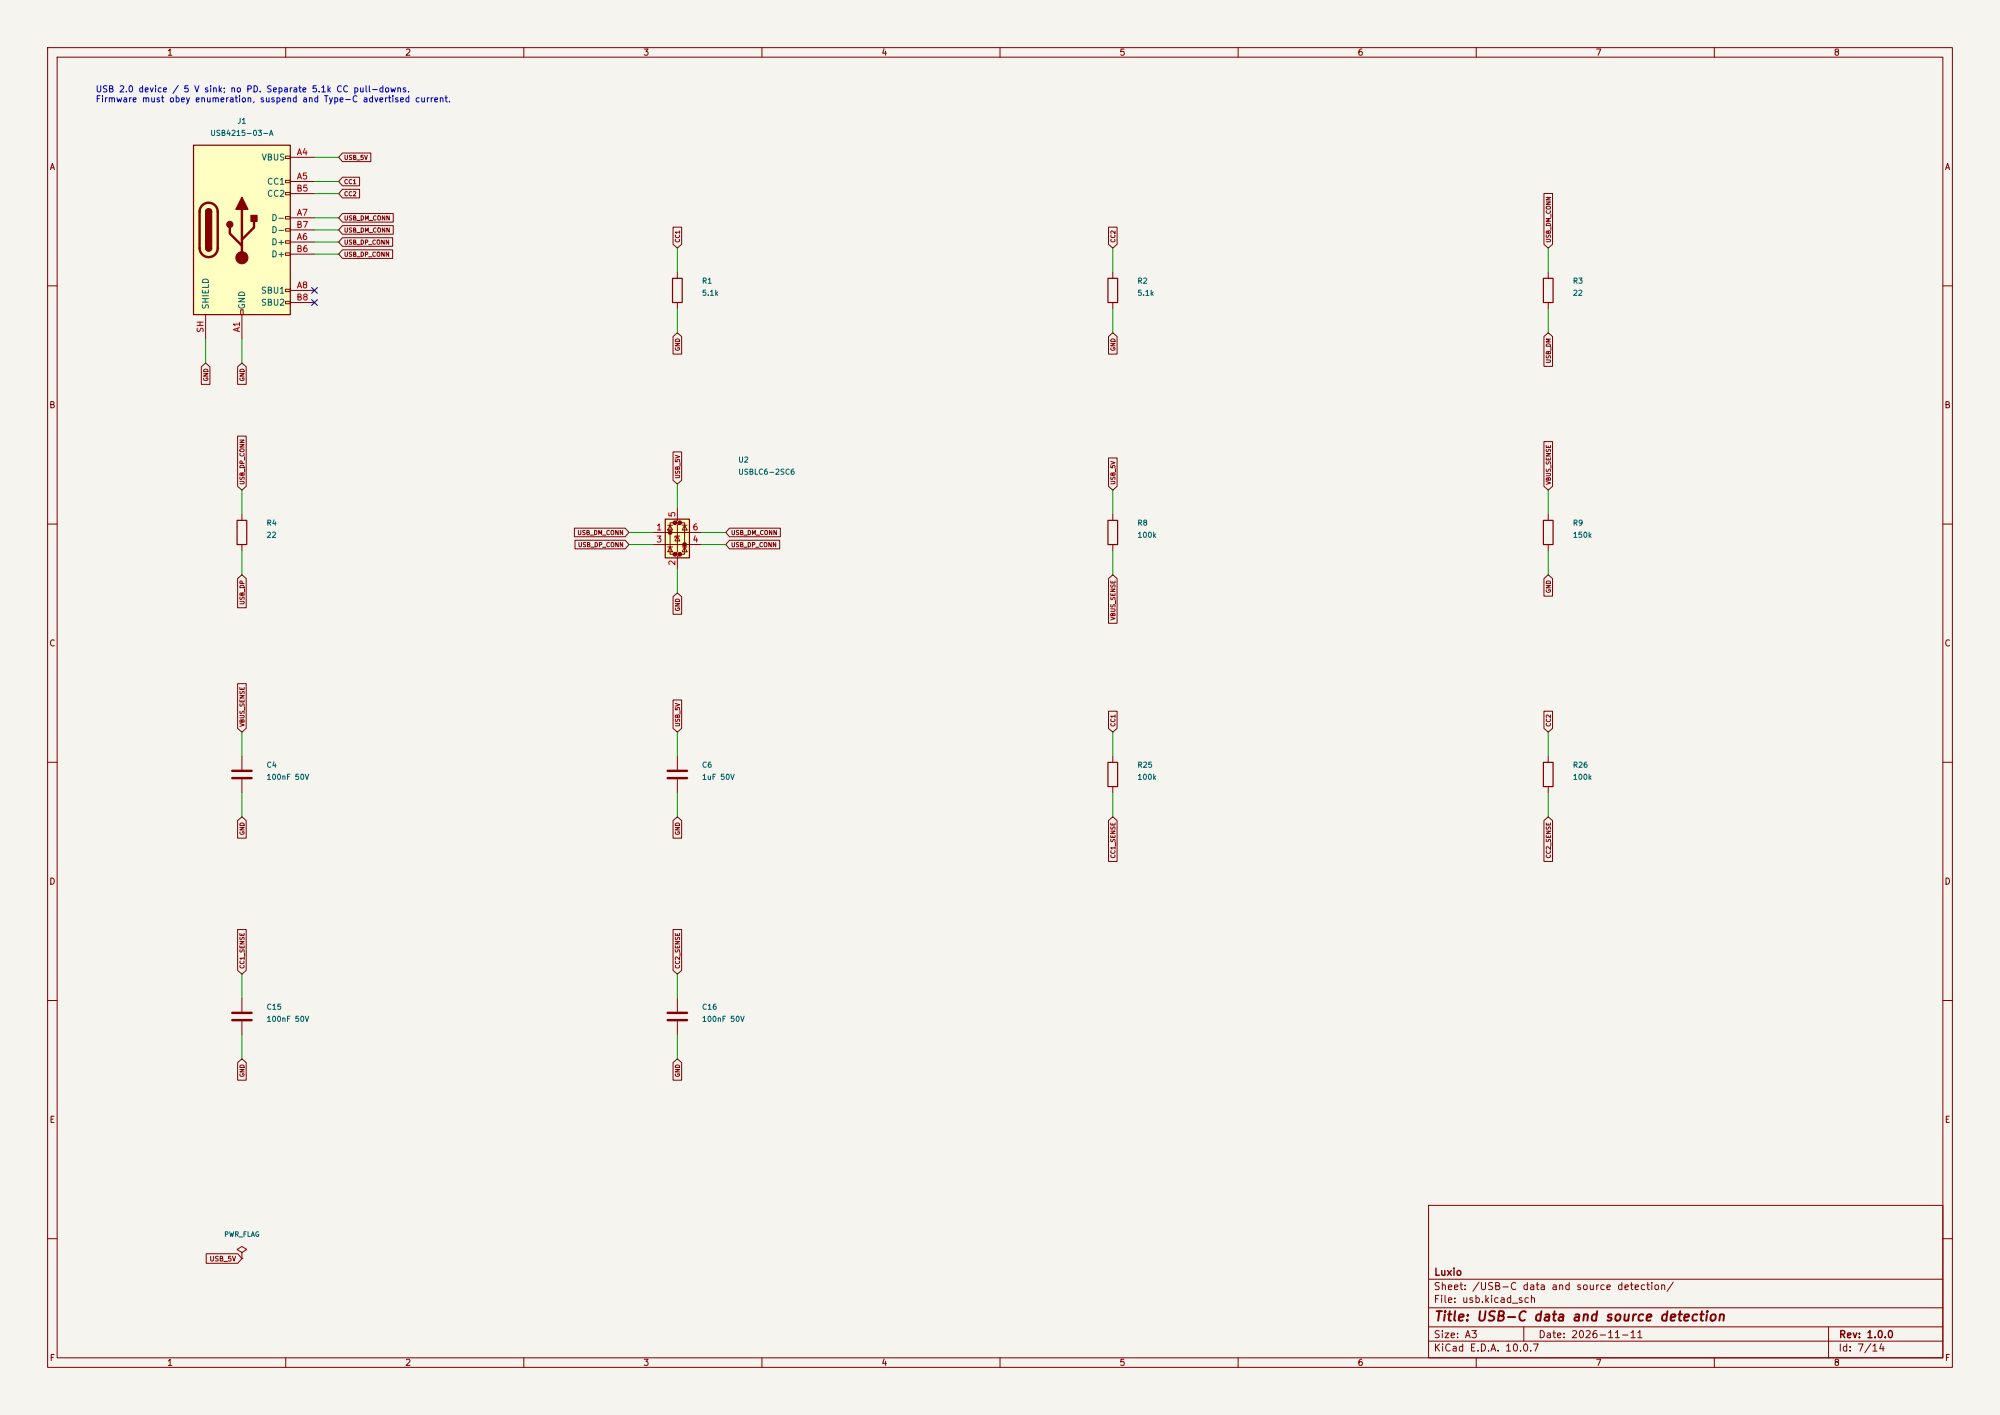
[picture p63: page 7]

USB 2.0 device / 5 V sink; no PD. Separate 5.1k CC pull-downs. Firmware must obey enumeration, suspend and Type-C advertised current.
CC2 USB_DM_CONN GND GND

Luxio
Sheet: /USB-C data and source detection/
File: usb.kicad_sch
Title: USB-C data and source detection

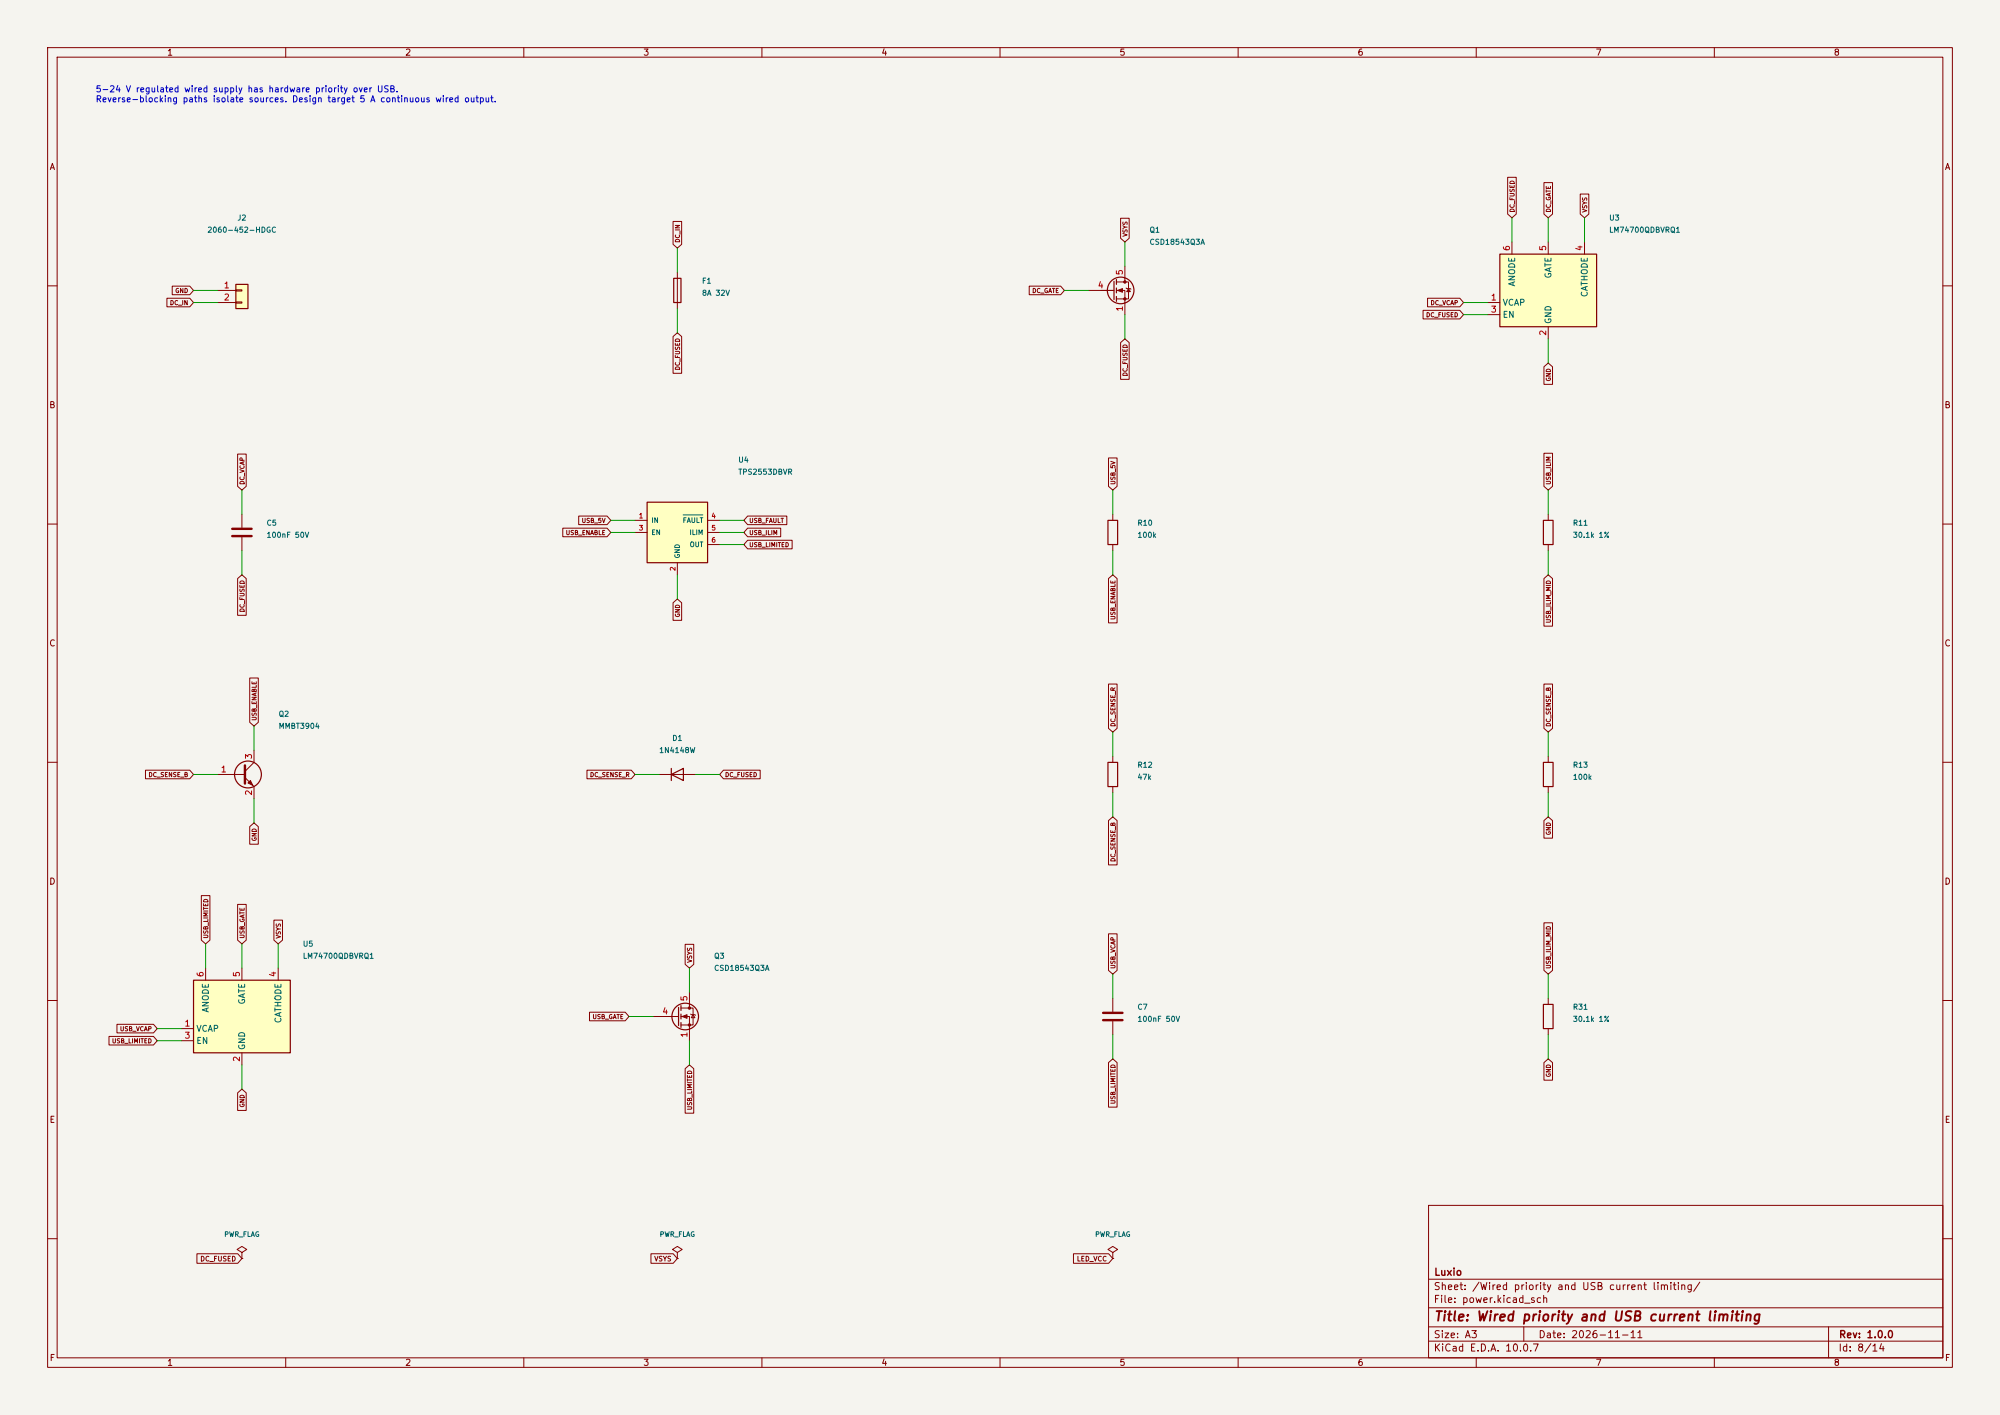
[picture p64: page 8]

Luxio
Sheet: /Wired priority and USB current limiting/
File: power.kicad_sch
Title: Wired priority and USB current limiting

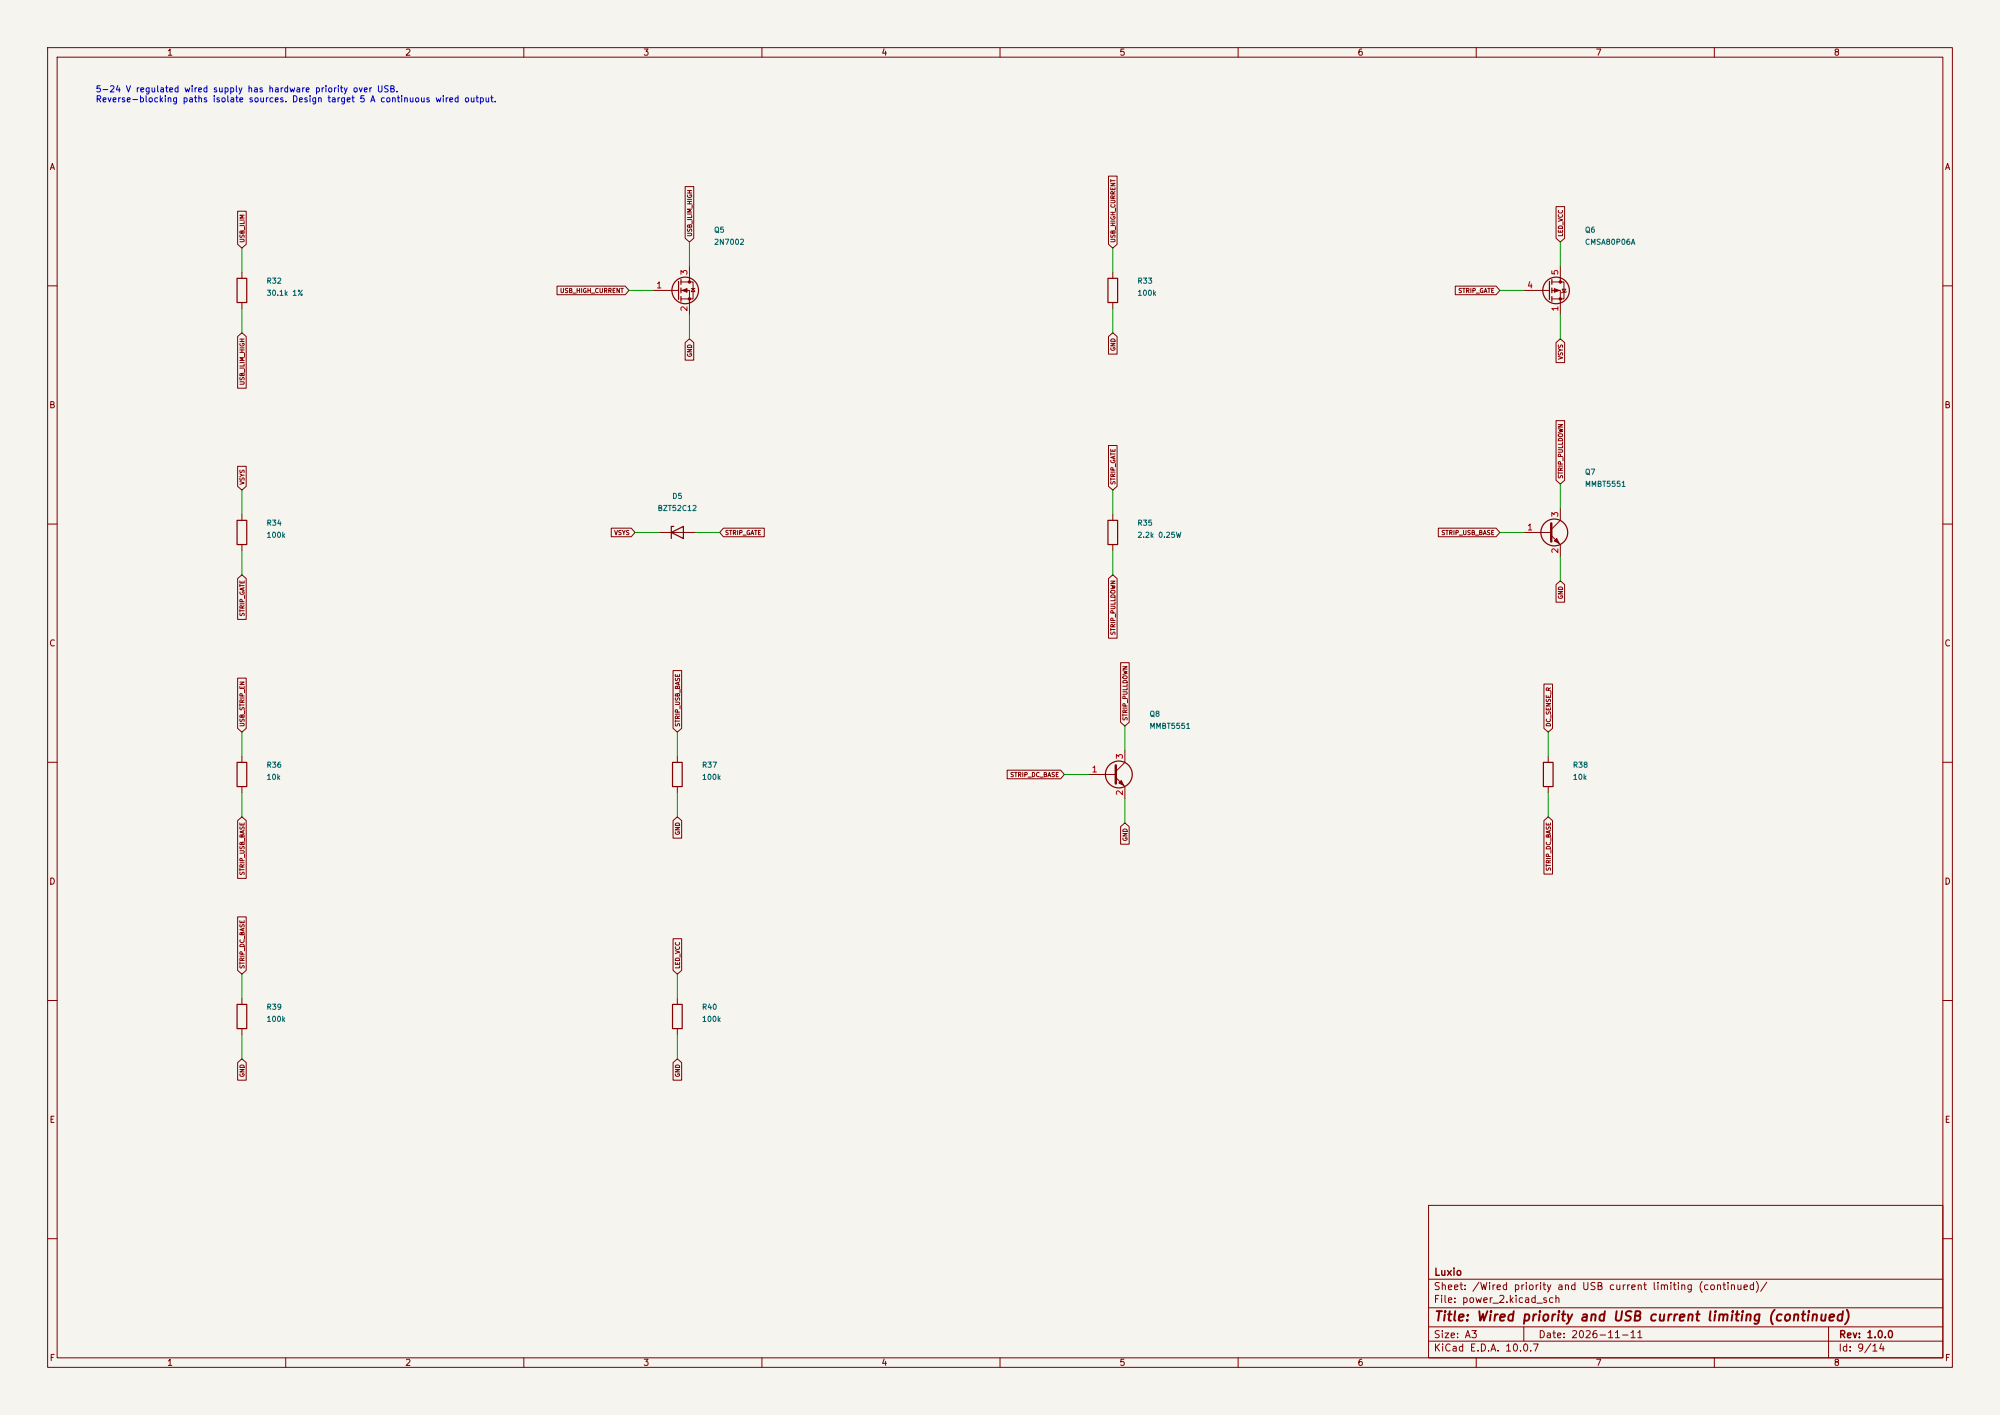
[picture p65: page 9]

5-24 V regulated wired supply has hardware priority over USB. Reverse-blocking paths isolate sources. Design target 5 A continuous wired output.

Luxio
Sheet: /Wired priority and USB current limiting (continued)/
File: power_2.kicad_sch
Title: Wired priority and USB current limiting (continued)

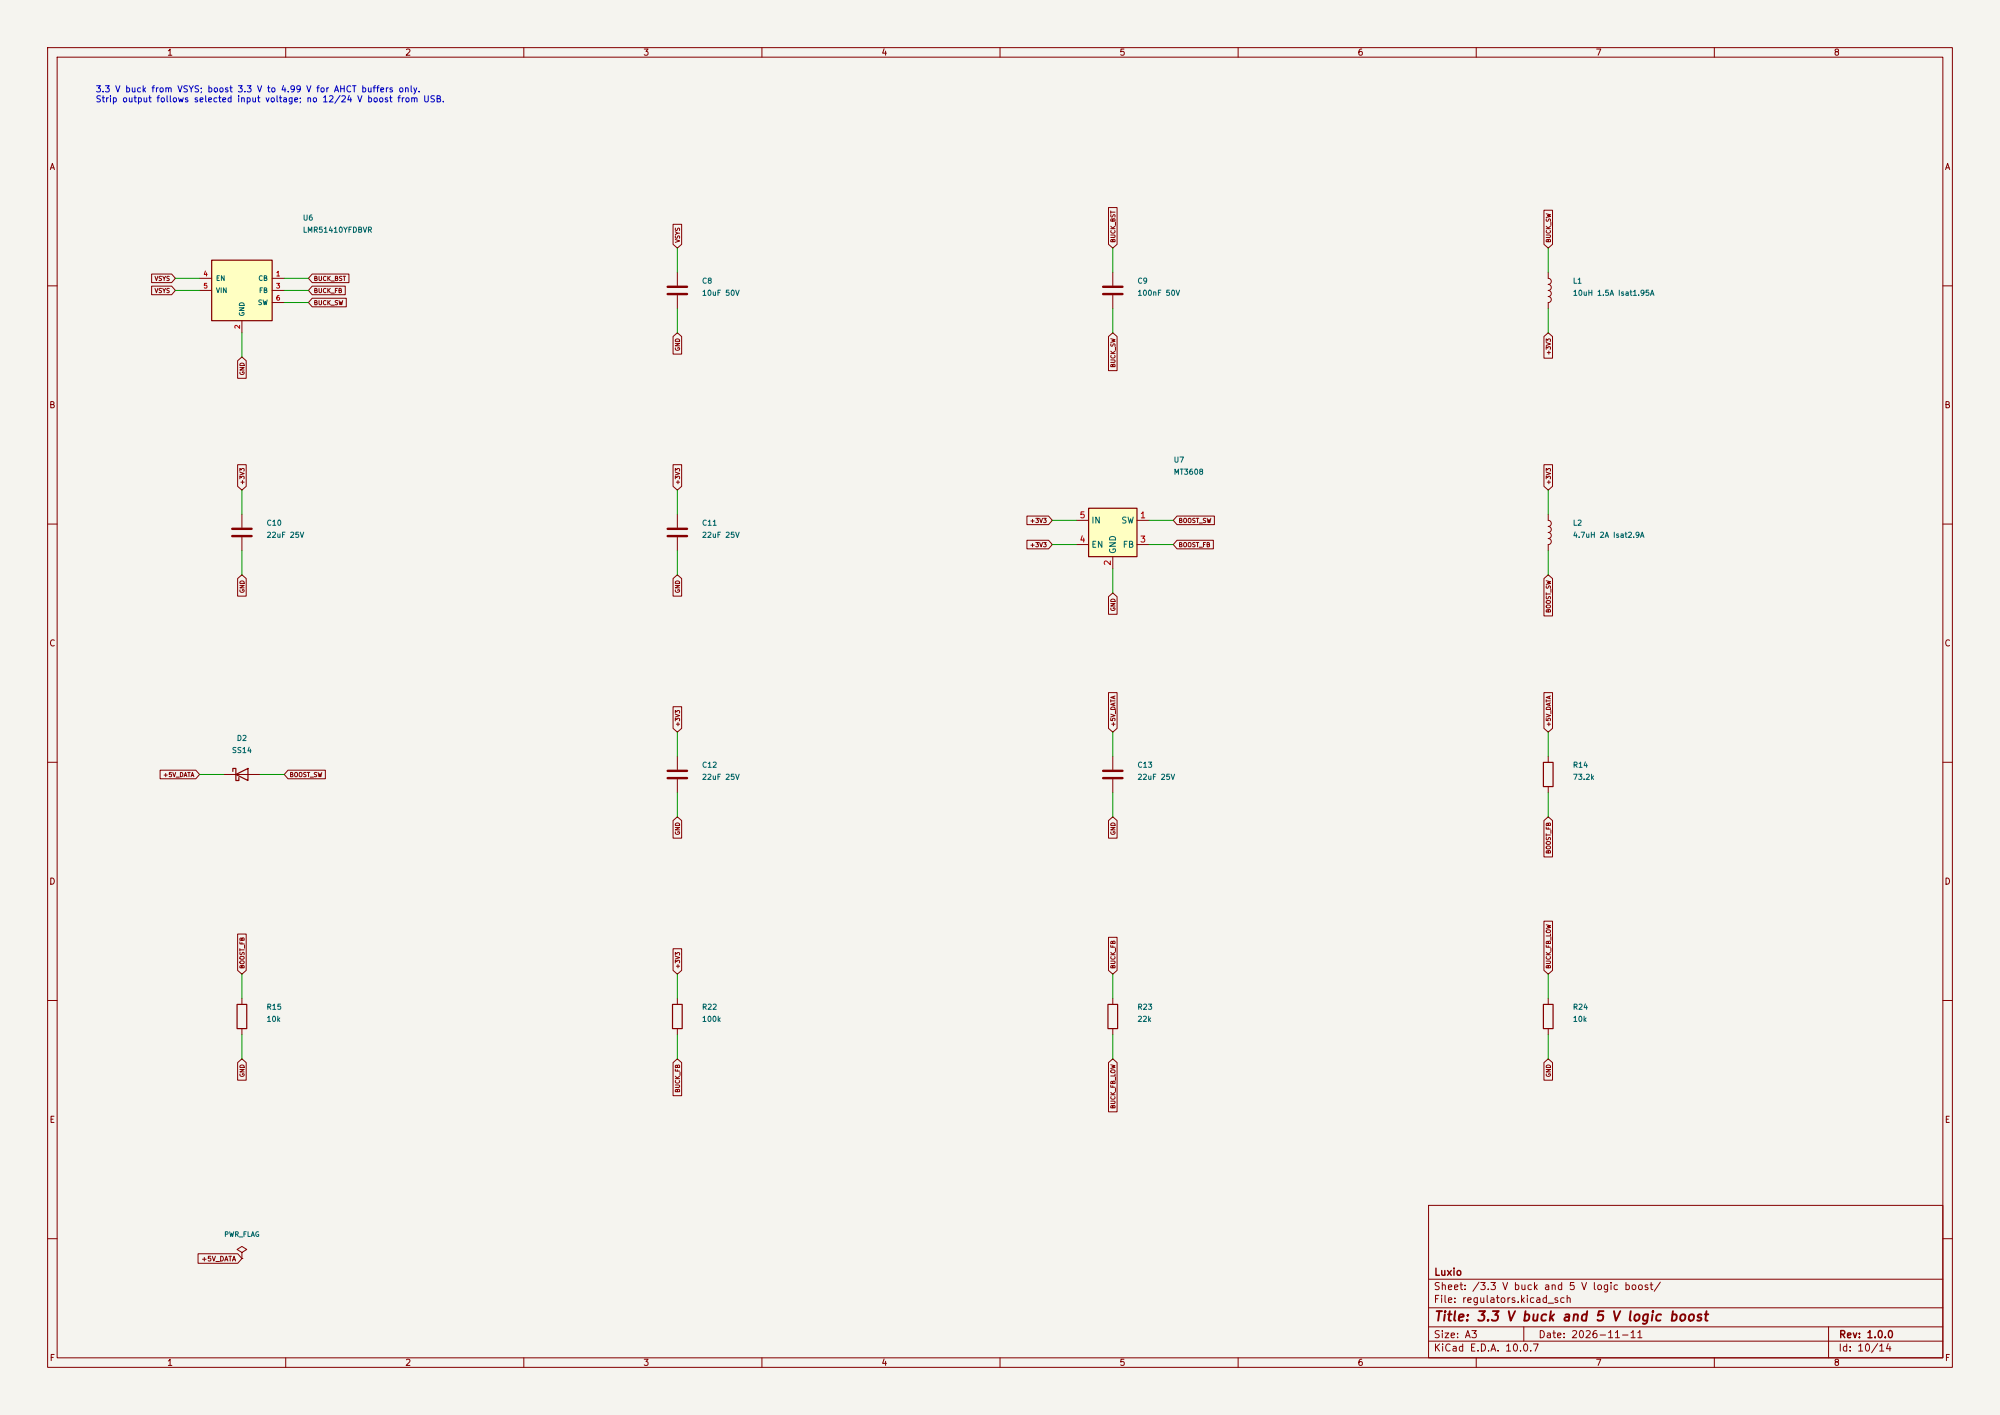
[picture p66: page 10]

Strip output follows selected input voltage; no 12/24 V boost from USB.

Luxio
Sheet: /3.3 V buck and 5 V logic boost/
File: regulators.kicad_sch
Title: 3.3 V buck and 5 V logic boost

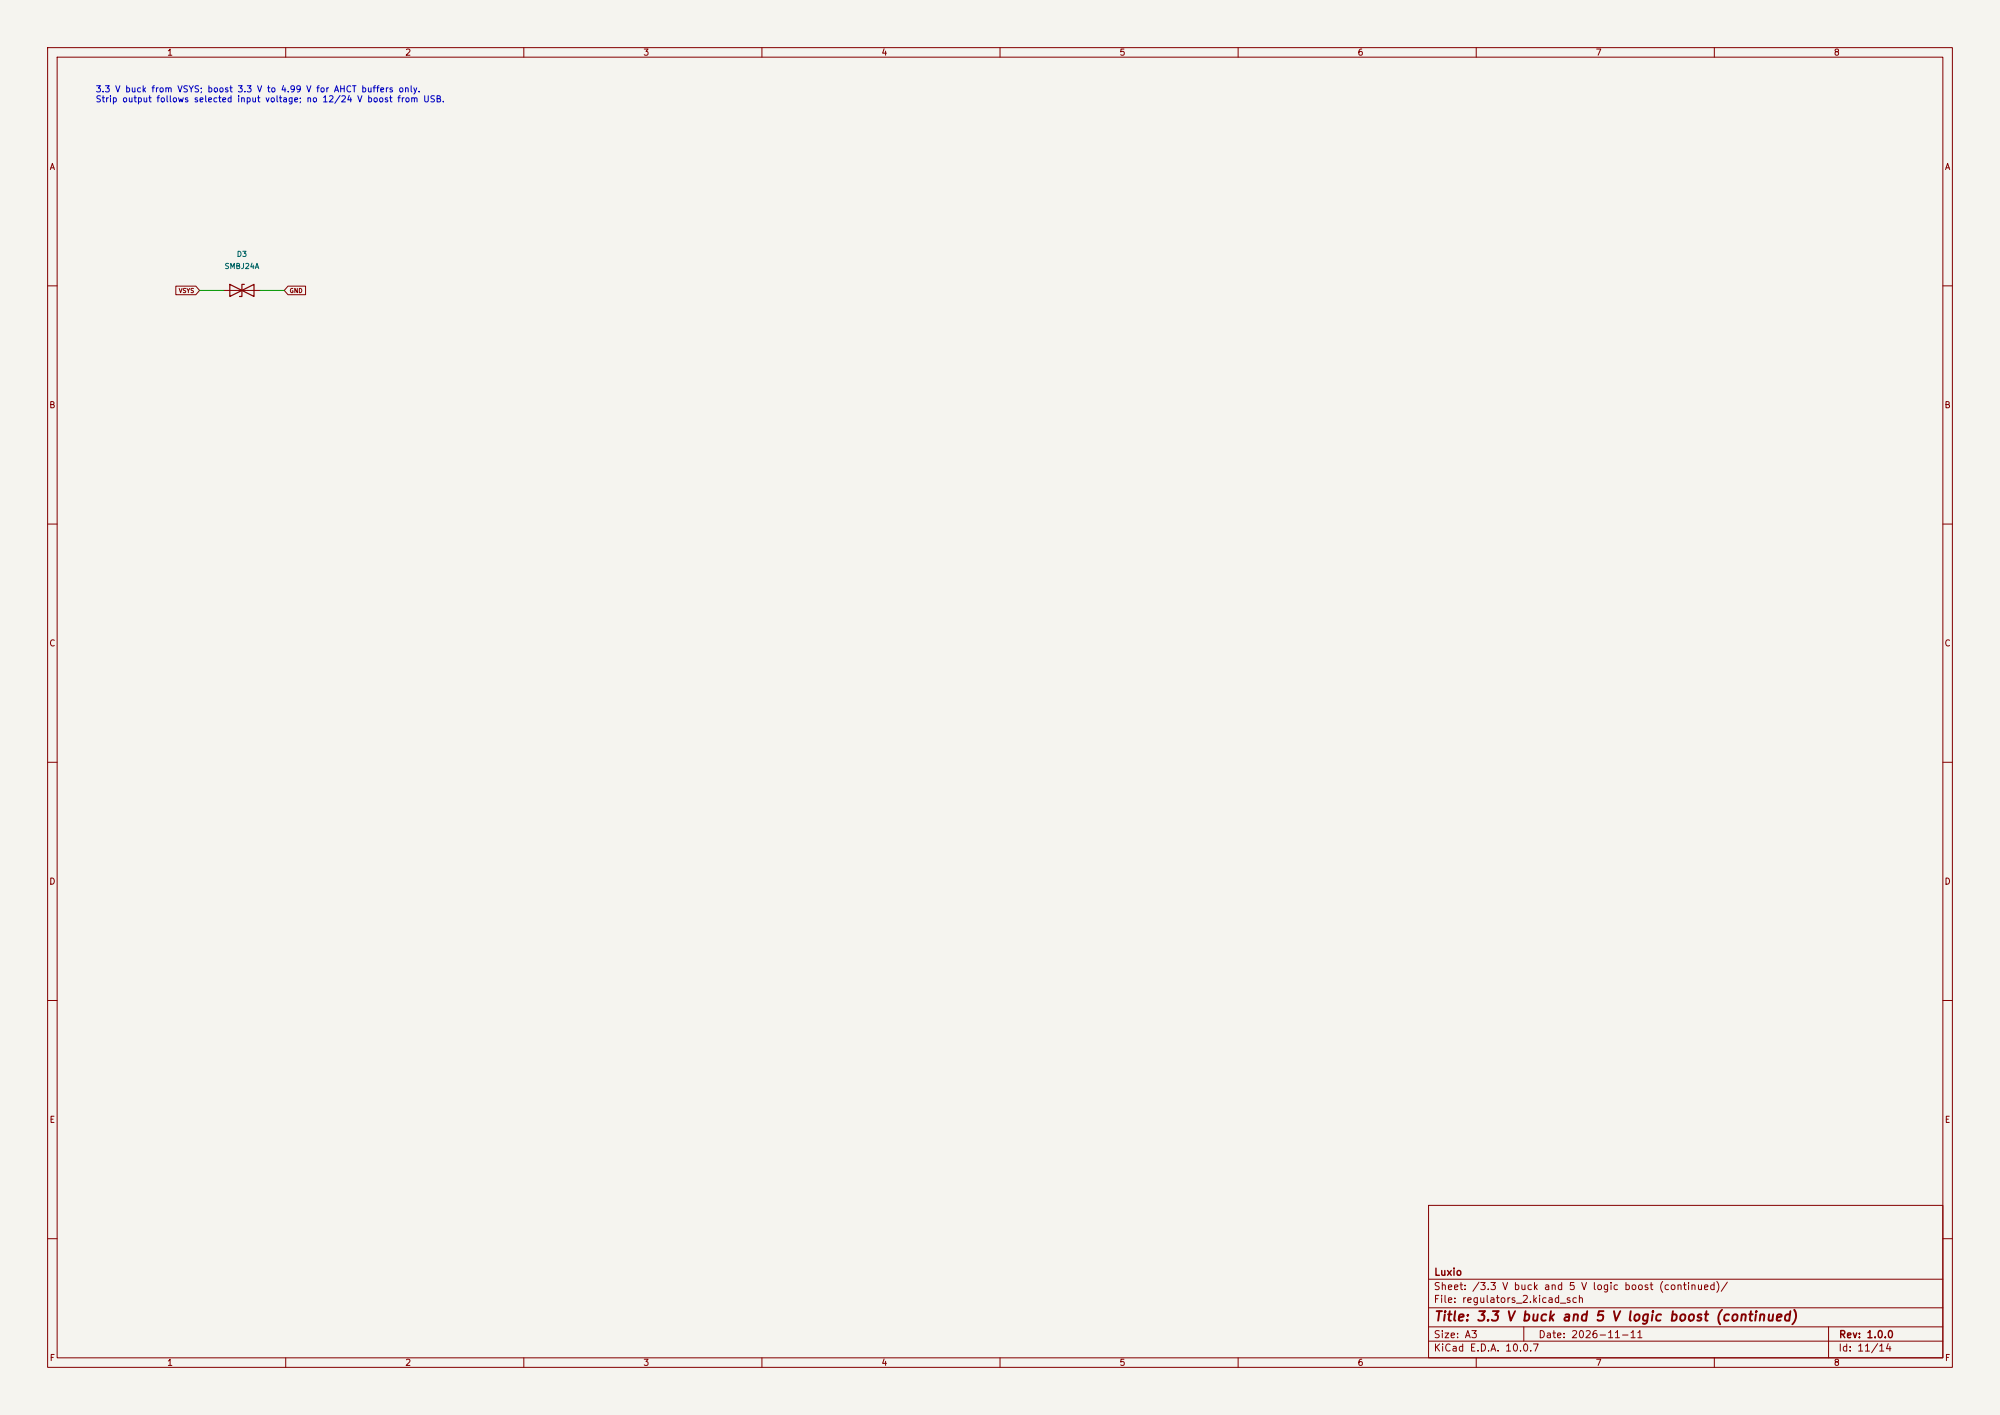
[picture p67: page 11]

Strip output follows selected input voltage; no 12/24 V boost from USB.

Luxio
Sheet: /3.3 V buck and 5 V logic boost (continued)/
File: regulators_2.kicad_sch
Title: 3.3 V buck and 5 V logic boost (continued)

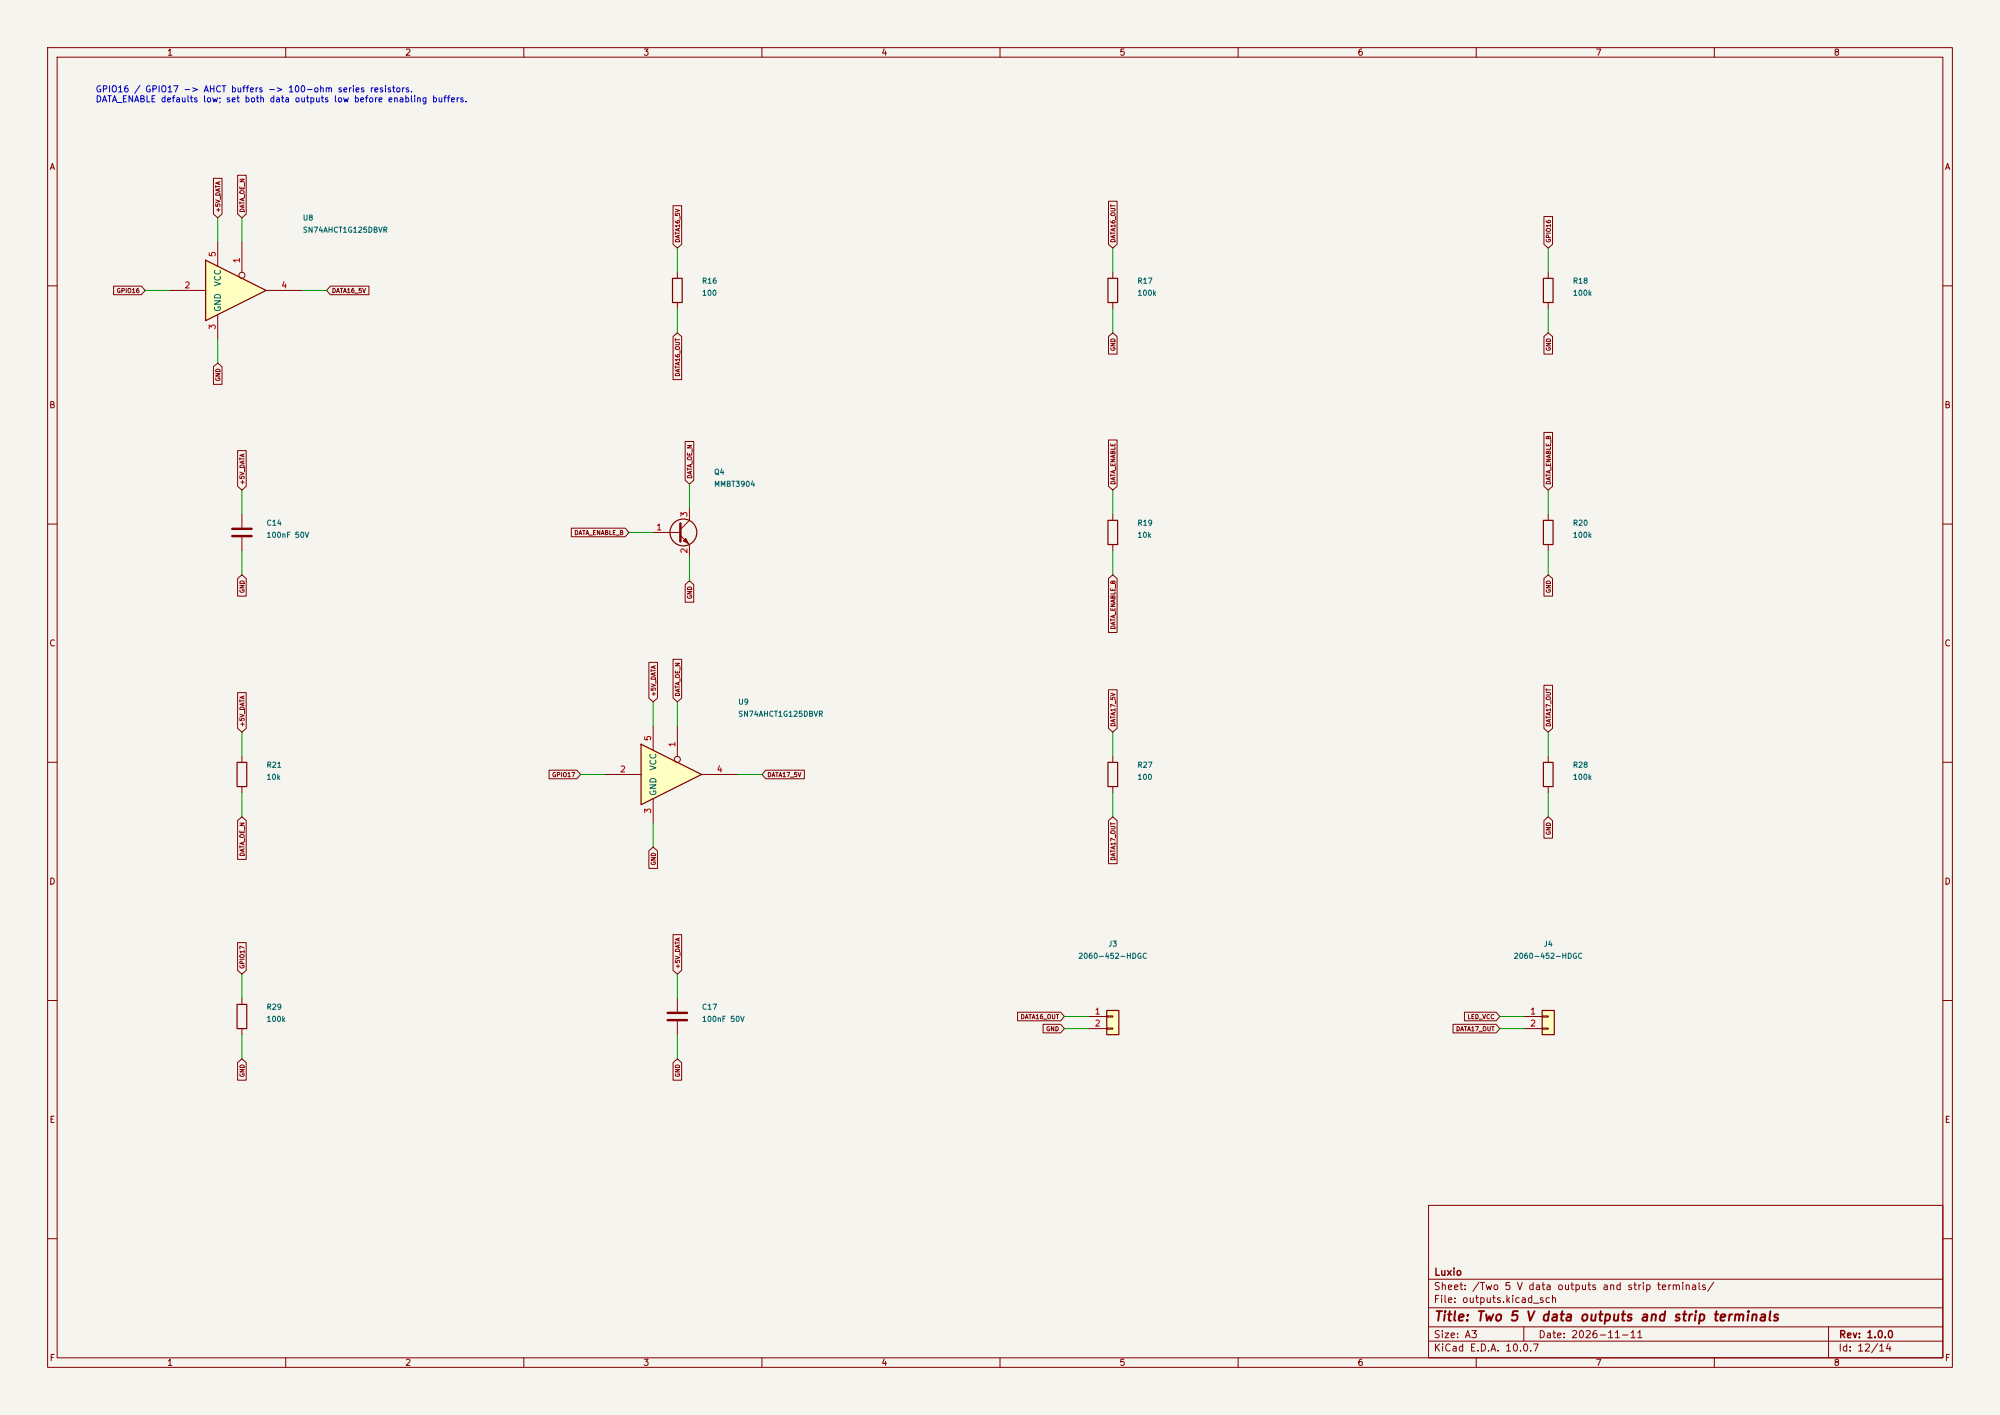
[picture p68: page 12]

DATA_ENABLE_B DATA_OE_N GPIO16 / GPIO17 -> AHCT buffers -> 100-ohm series resistors. DATA_ENABLE defaults low; set both data outputs low before enabling buffers.

Luxio
Sheet: /Two 5 V data outputs and strip terminals/
File: outputs.kicad_sch
Title: Two 5 V data outputs and strip terminals

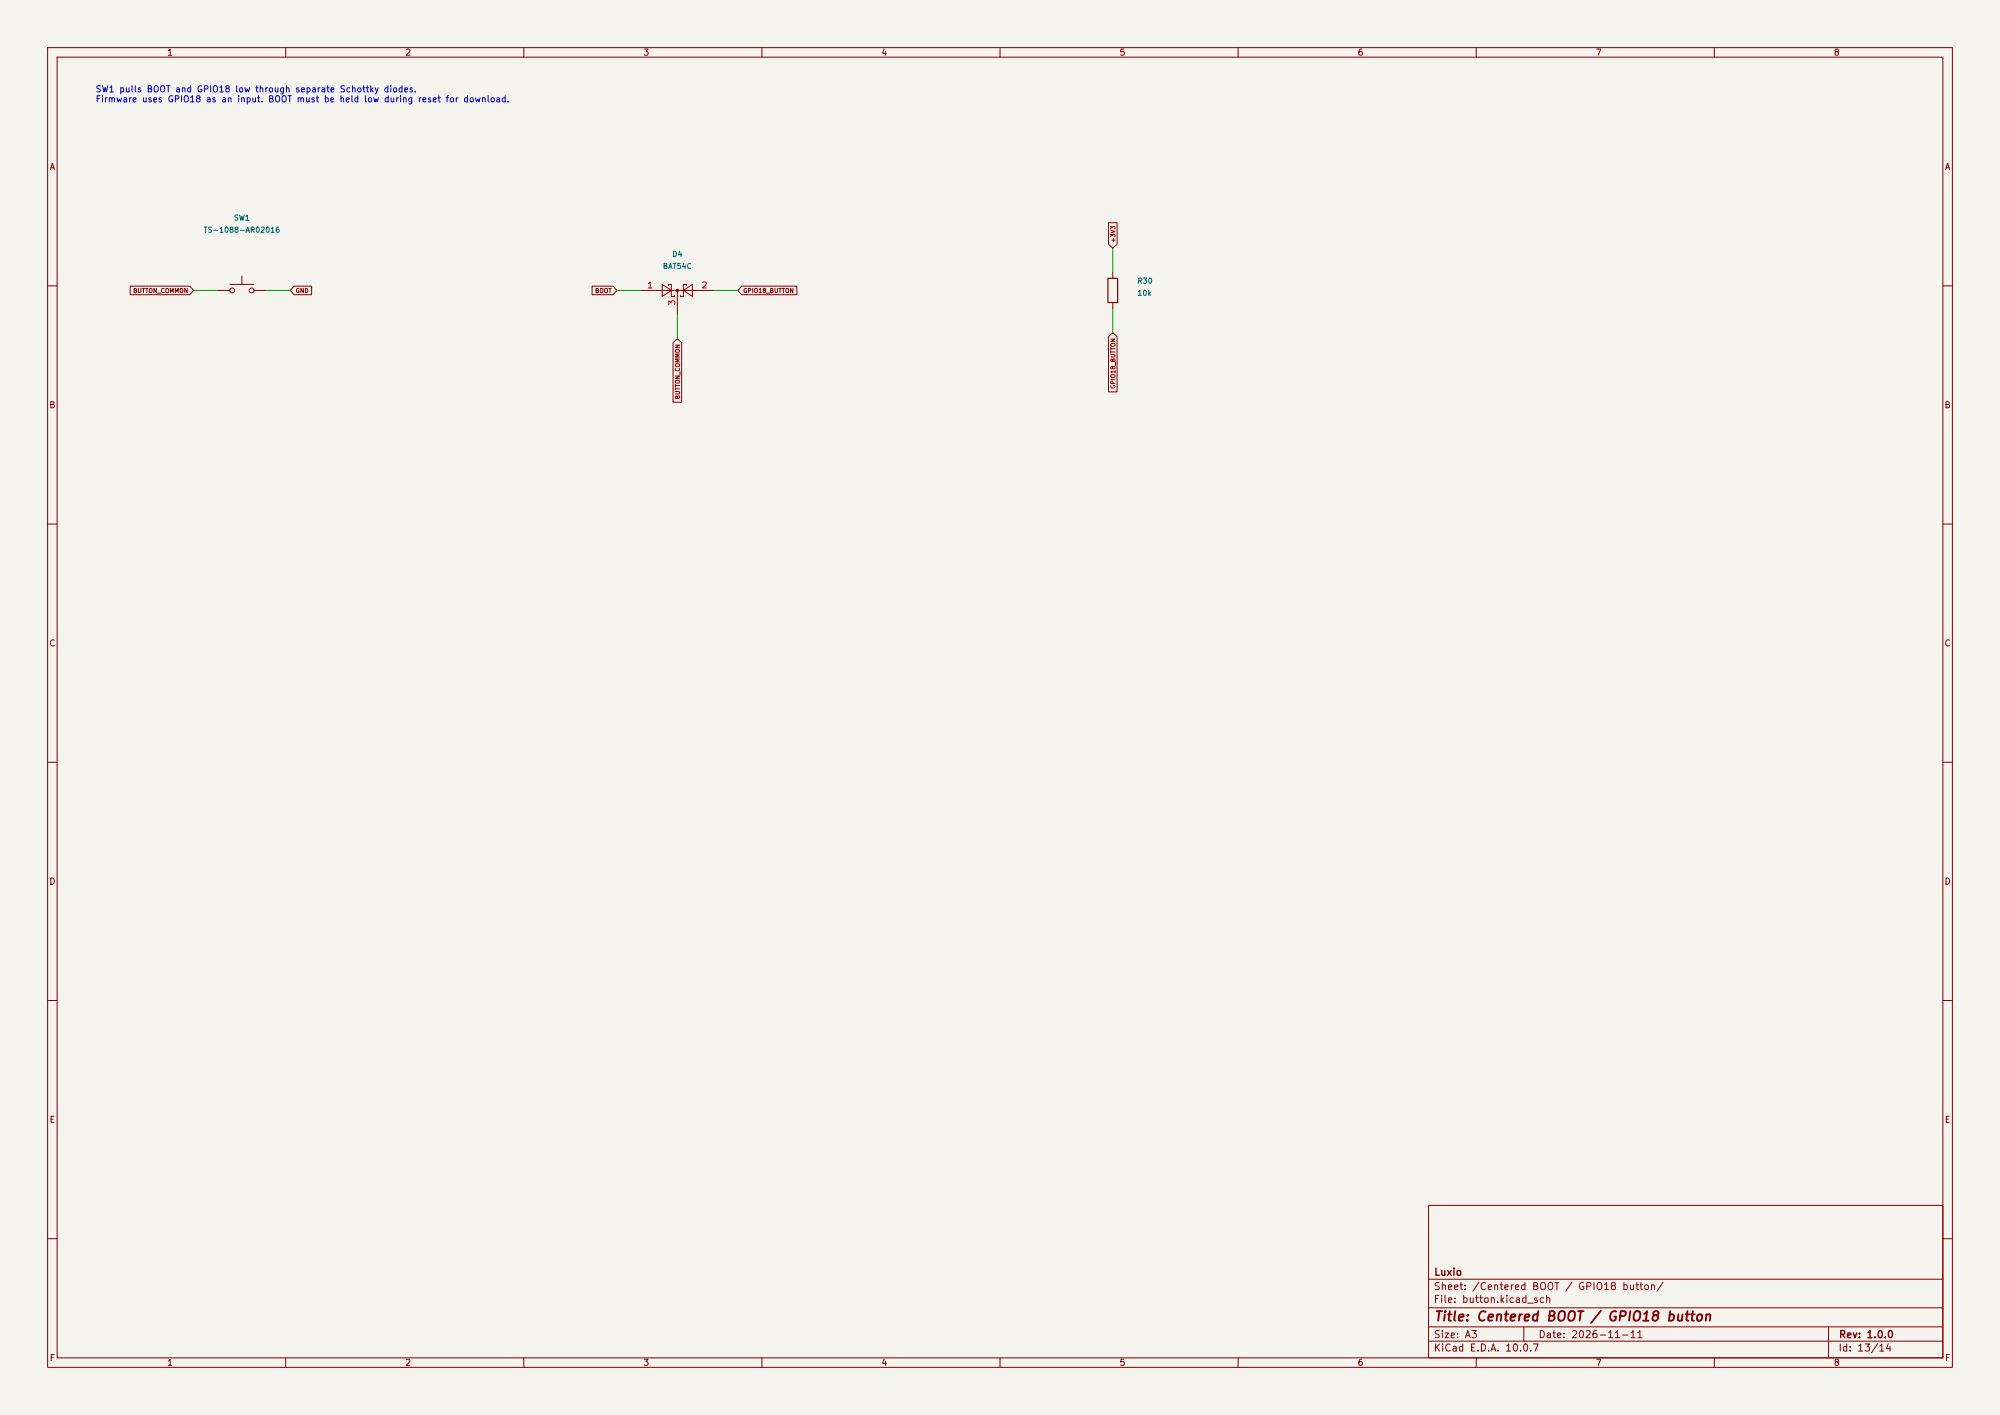
[picture p69: page 13]

SW1 pulls BOOT and GPIO18 low through separate Schottky diodes. Firmware uses GPIO18 as an input. BOOT must be held low during reset for download.

Luxio
Sheet: /Centered BOOT / GPIO18 button/
File: button.kicad_sch
Title: Centered BOOT / GPIO18 button

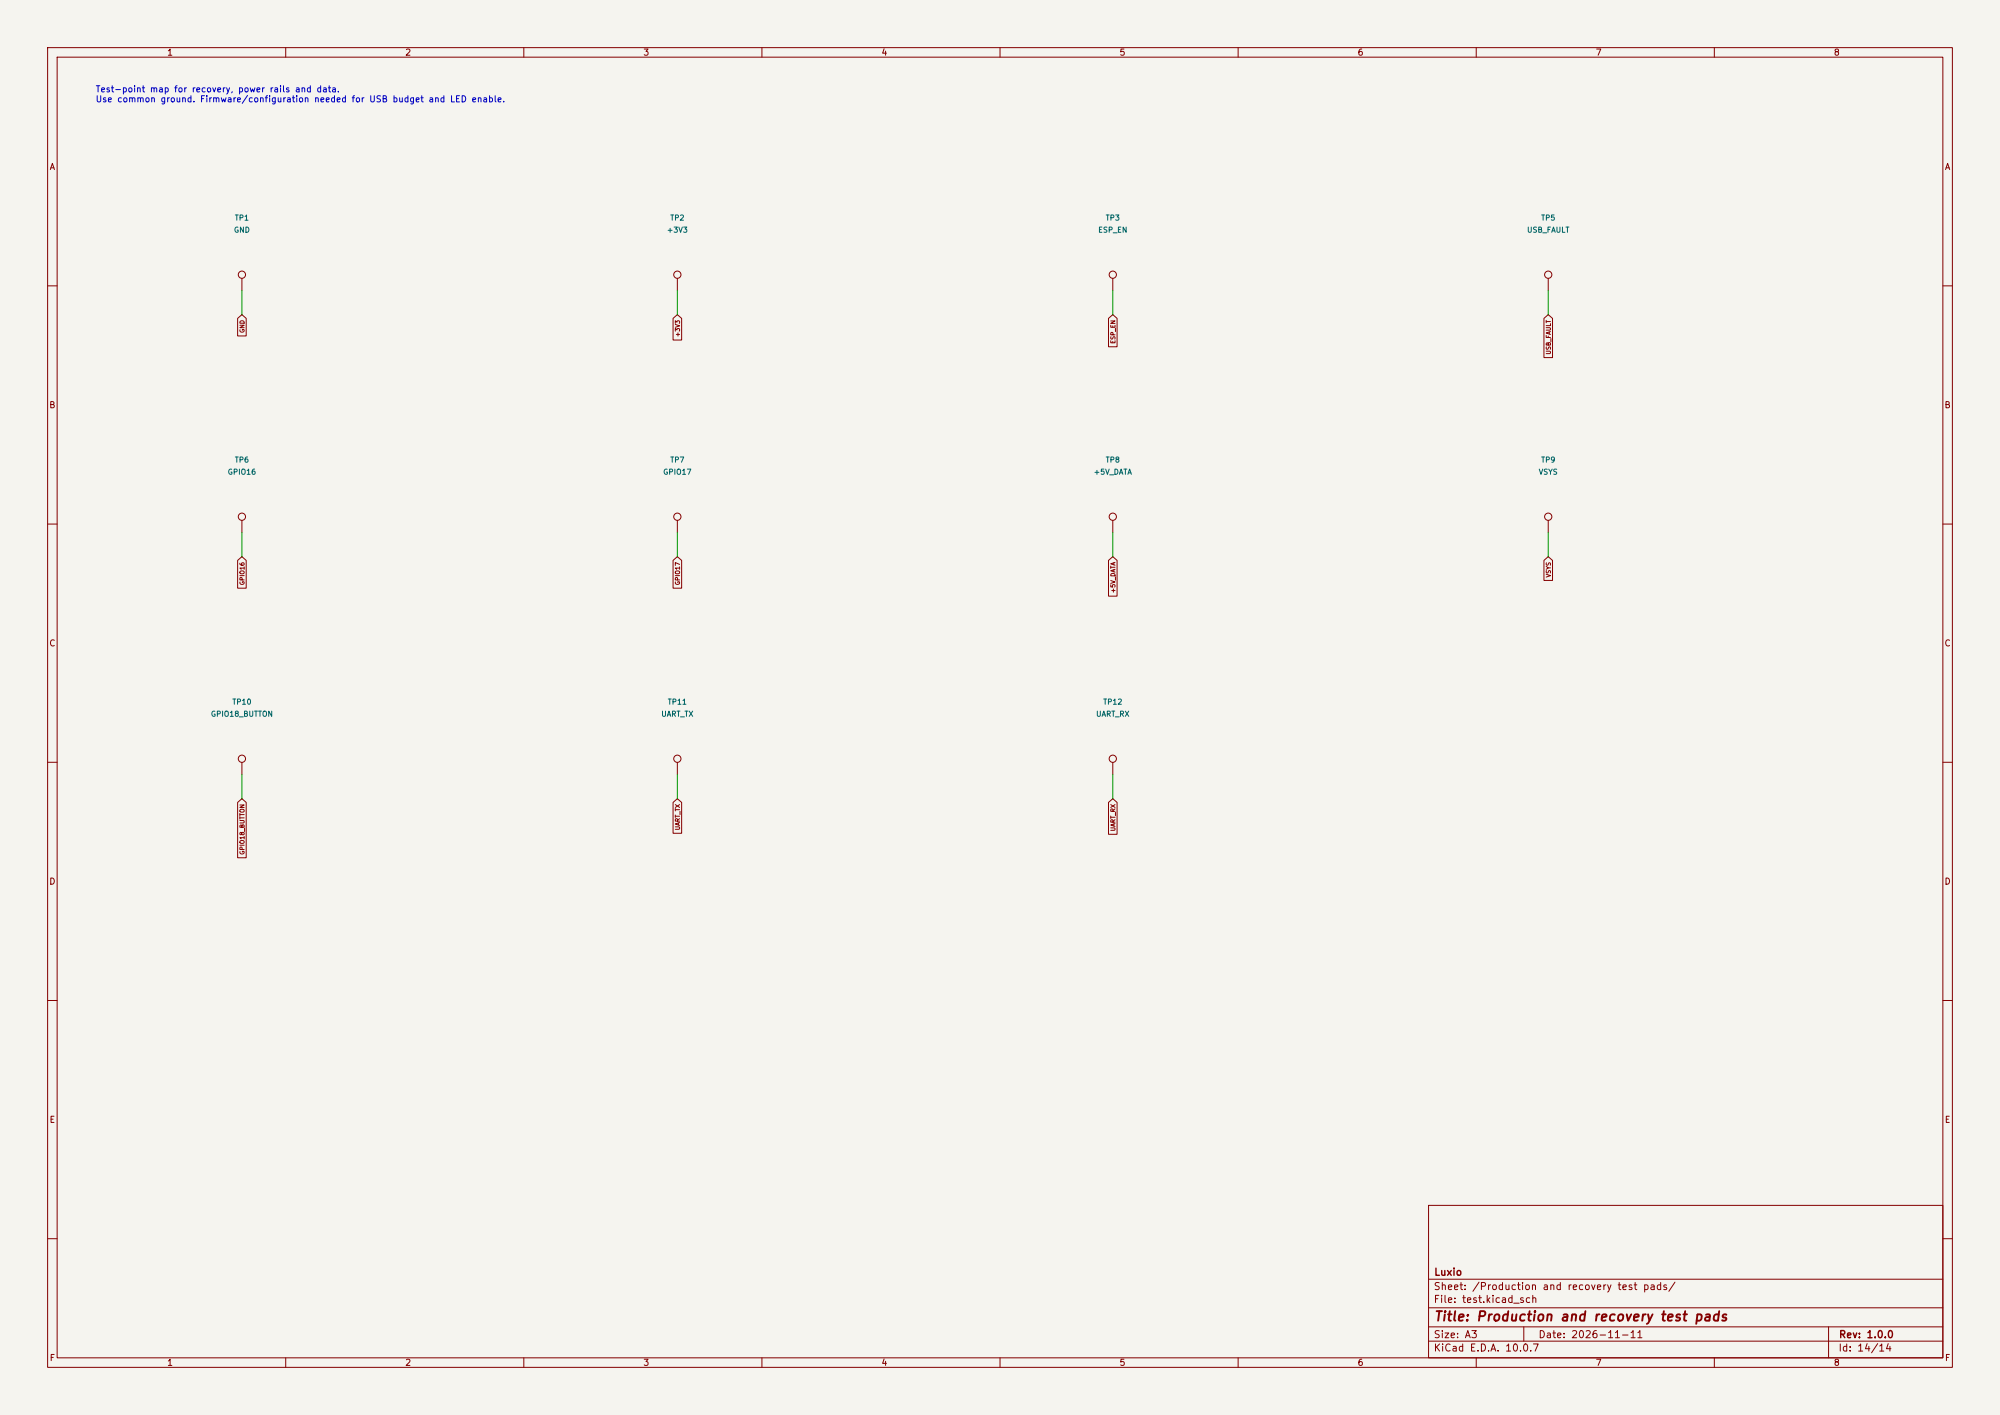
[picture p70: page 14]

Test-point map for recovery, power rails and data. Use common ground. Firmware/configuration needed for USB budget and LED enable.

Luxio
Sheet: /Production and recovery test pads/
File: test.kicad_sch
Title: Production and recovery test pads
