luxio-lighting/luxio-hardware/LX0001/v1.0.0/Assets/connectors/HDGC_2060_452_C55251566.pdf

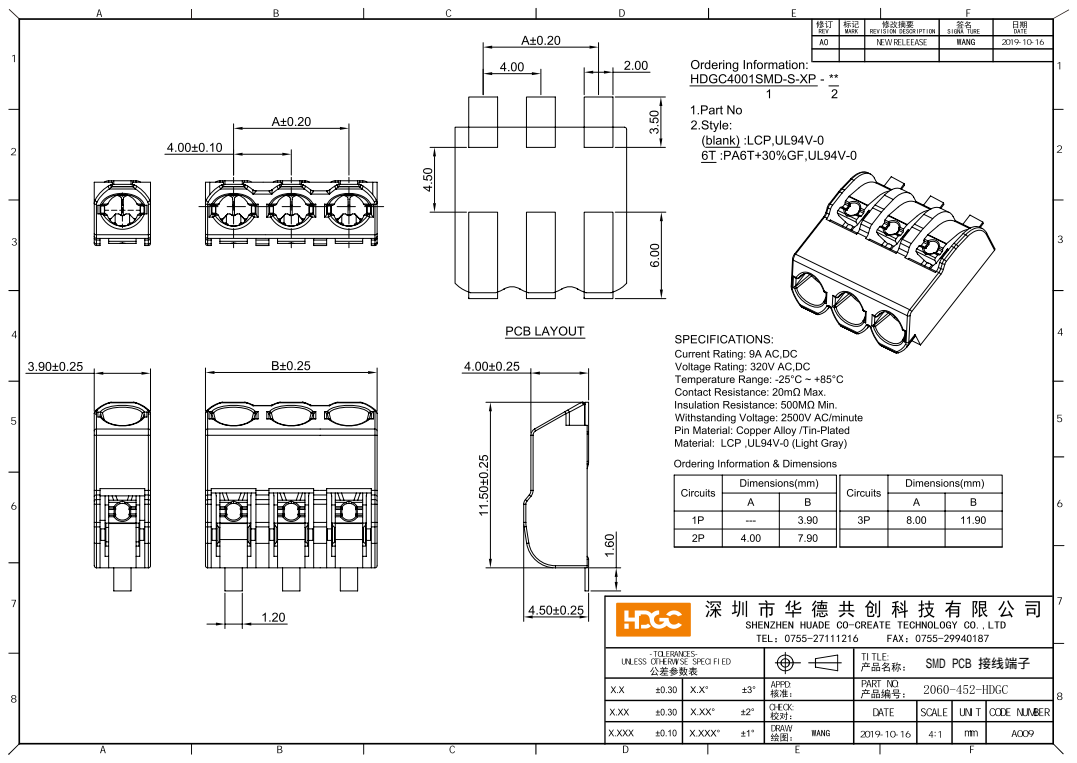
[picture p71: page 1]

SMD PCB 接线端子
