luxio-lighting/luxio-hardware/LX0001/v1.0.0/Assets/io/C42400246_USB_candidate.pdf

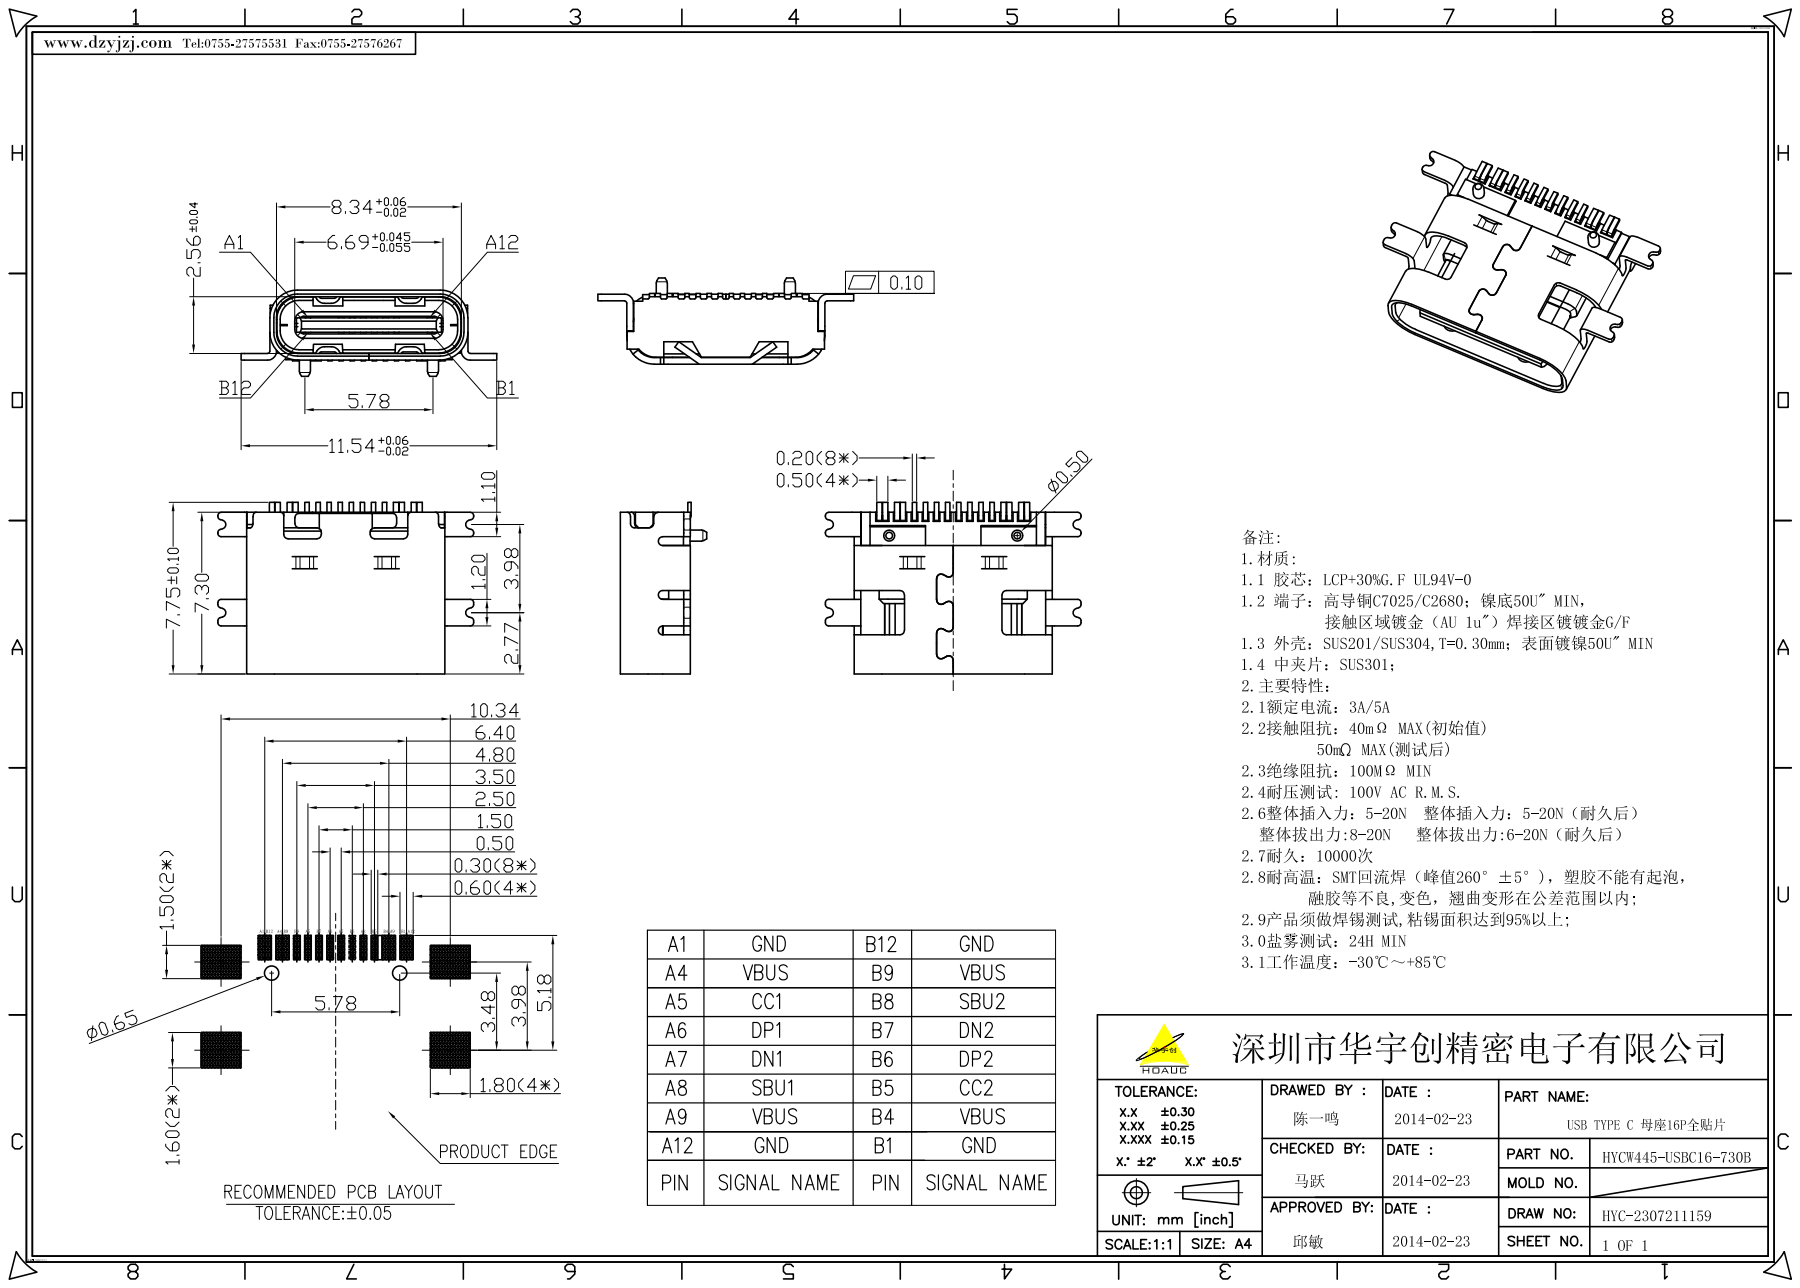
[picture p72: page 1]
