luxio-lighting/luxio-hardware/LX0001/v1.0.0/Assets/io/C53340455_USB_candidate.pdf

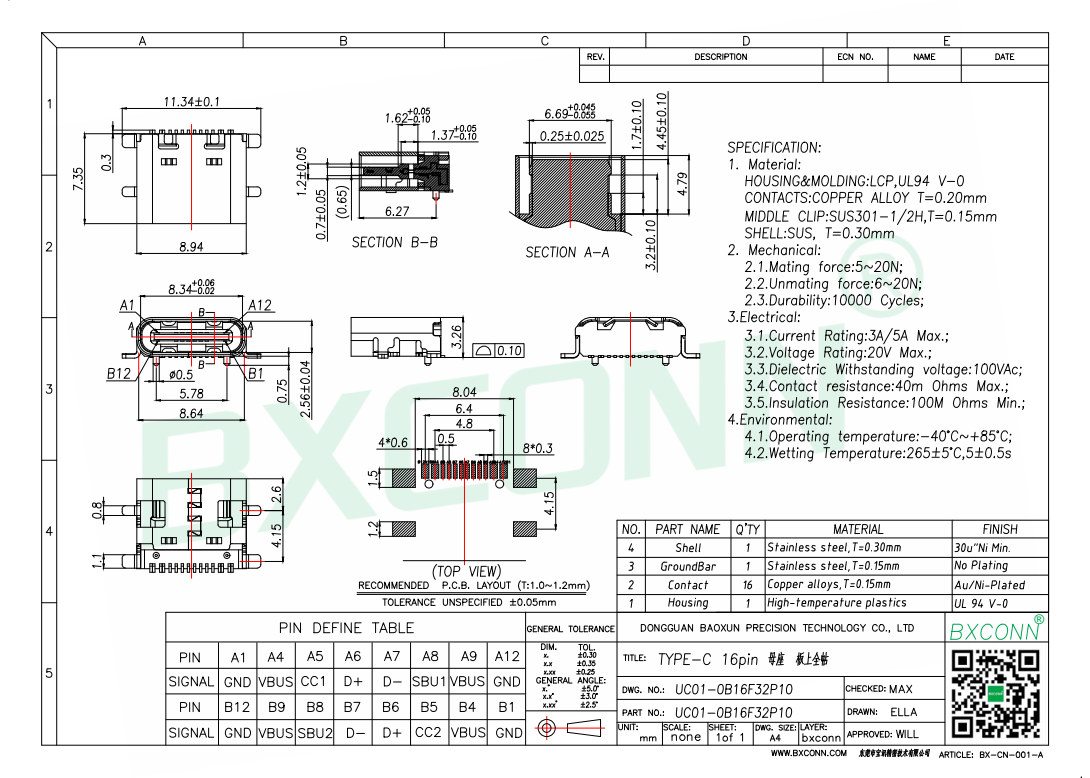
[picture p73: page 1]

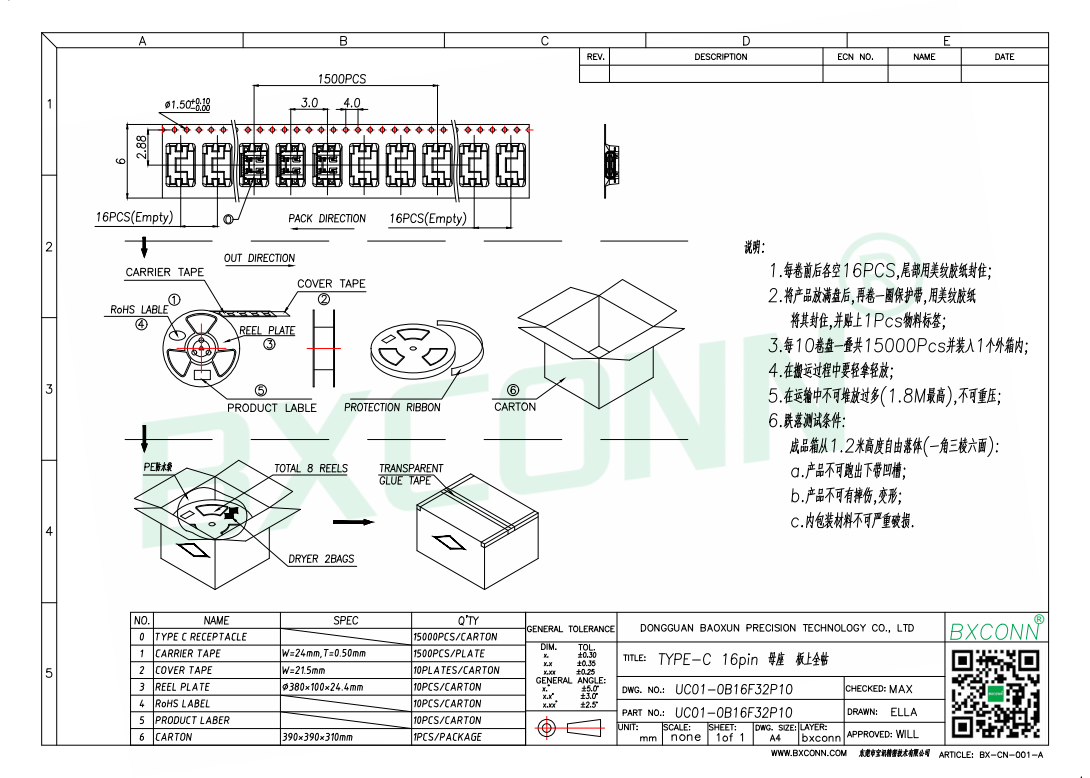
[picture p74: page 2]
