luxio-lighting/luxio-hardware/(list of files, drawings)

Other design files:
LX0001/v1.0.0/Assets/connectors/JLCEDA-C2927038/C2927038-easyeda.json
LX0001/v1.0.0/Assets/connectors/JLCEDA-C37616412/EasyEDA-C37616412-original.json
LX0001/v1.0.0/Assets/connectors/JLCEDA-C55251566/EasyEDA-C55251566-original.json
LX0001/v1.0.0/Assets/review-history/before-hardware-auto/Validation/schematic-document-review.json
LX0001/v1.0.0/Assets/review-history/before-library-3d-models/Export/Validation/schematic-document-review.json
LX0001/v1.0.0/Export/Validation/schematic-document-review.json
