luxio-lighting/luxio-hardware/LX0001/v1.0.0/Source/LX0001.kicad_pcb

## KiCad design LX0001/v1.0.0/Source/LX0001.kicad_pcb (2026-11-12)

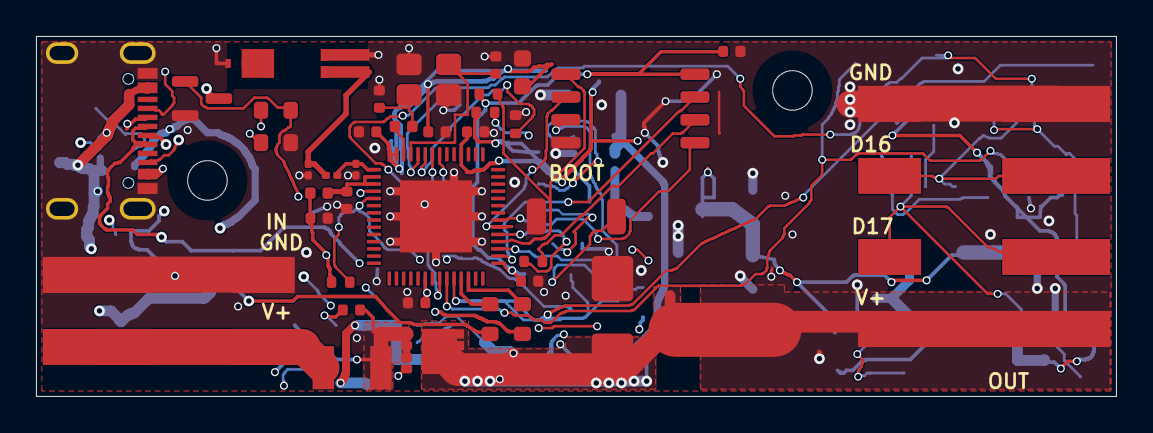
[picture p75: board LX0001.kicad_pcb from above]

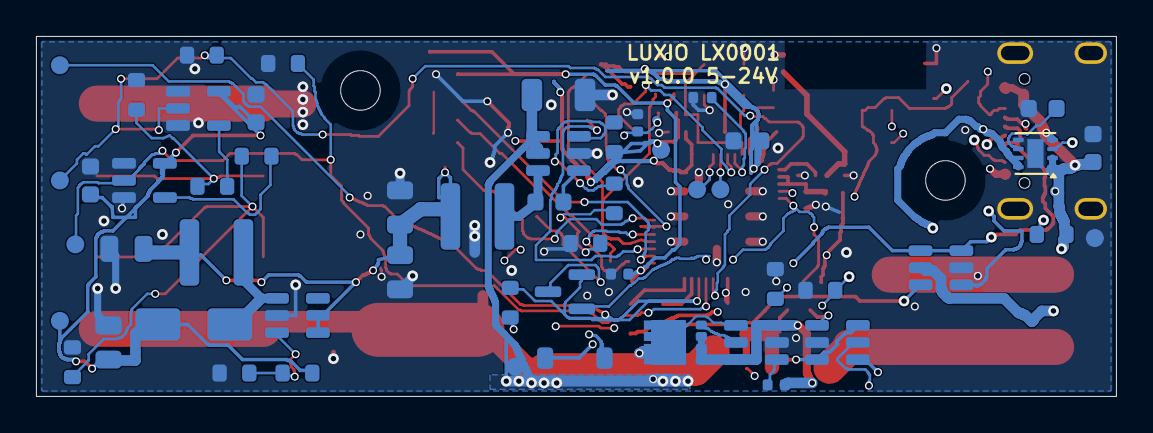
[picture p76: board LX0001.kicad_pcb from below]

Board: 4 copper layers, 60.0 x 20.0 mm, 96 parts (54 on the bottom side), 57 nets.

Parts:
ANT1: RFECA3216060A1T; Walsin_RFECA3216060A1T_Type1
C5, C7: 100nF 50V; C_0402_1005Metric
C6: 1uF 50V; C_0603_1608Metric
C8: 10uF 50V; C_1206_3216Metric
C9, C14, C17: 100nF 50V; C_0603_1608Metric
C10, C11, C12, C13: 22uF 25V; C_0805_2012Metric
C18: 1nF 50V; C_0603_1608Metric
C100, C107: 10uF 10V; C_0603_1608Metric
C101, C102, C103, C104, C105, C108, C110: 100nF 16V; C_0402_1005Metric
C106, C109, C111: 1uF 25V; C_0402_1005Metric
C112, C113: 18pF 50V C0G; C_0402_1005Metric
C114, C115: 1.5pF 50V C0G; C_0201_0603Metric
D1: 1N4148W; D_SOD-123
D2: SS14; D_SMA
D3: SMBJ24A; D_SMB
D4: BAT54C; SOT-23
F1: 8A 32V; Fuse_SART_S1206_FA
H1, H2: MountingHole_2.2mm_M2
J1: USB-TYPE-C-018; USB_C_DEALON_USB_TYPE_C_018
J2, J3, J4: 2060-452-HDGC; HDGC_2060_452
L1: 10uH 1.5A Isat1.95A; L_Sunlord_SWPA4030S
L2: 4.7uH 2A Isat2.9A; L_Sunlord_SWPA4030S
L100: 2nH 900mA; L_0402_1005Metric
L101: 24nH; L_0402_1005Metric
L102: 2.7nH; L_0201_0603Metric
L104: DNP 0R antenna tune; Walsin_RFECA_Tuner_0402
Q1, Q3: CSD18543Q3A; VSON-8_3.3x3.3mm_P0.65mm_NexFET
Q2: MMBT3904; SOT-23
R1, R2: 5.1k; R_0603_1608Metric
R3, R4: 22; R_0603_1608Metric
R10, R13, R17, R18, R22, R28, R29: 100k; R_0603_1608Metric
R12: 47k; R_0603_1608Metric
R14: 73.2k; R_0603_1608Metric
R15, R24, R30: 10k; R_0603_1608Metric
R16, R27: 100; R_0603_1608Metric
R23: 22k; R_0603_1608Metric
R100, R101, R102, R103, R110: 10k; R_0402_1005Metric
R105: 0; R_0402_1005Metric
SW1: TS-1088-AR02016; SW_TS-1088-AR02016
TP1: GND; TestPoint_Pad_D1.0mm
TP2: +3V3; TestPoint_Pad_D1.0mm
TP3: ESP_EN; TestPoint_Pad_D0.5mm
TP6: GPIO16; TestPoint_Pad_D1.0mm
TP7: GPIO17; TestPoint_Pad_D1.0mm
TP8: +5V_DATA; TestPoint_Pad_D1.0mm
TP9: VSYS; TestPoint_Pad_D1.0mm
TP10: GPIO18_BUTTON; TestPoint_Pad_D1.0mm
TP11: UART_TX; TestPoint_Pad_D1.0mm
TP12: UART_RX; TestPoint_Pad_D1.0mm
U1: ESP32-S3; QFN-56-1EP_7x7mm_P0.4mm_EP4x4mm
U2: USBLC6-2SC6; SOT-23-6
U3, U5: LM74700QDBVRQ1; SOT-23-6
U4: TPS22965DSGR; Texas_DSG0008A_WSON-8-1EP_2x2mm_P0.5mm_EP0.9x1.6mm
U6: LMR51410YFDBVR; SOT-23-6
U7: MT3608; SOT-23-6
U8, U9: SN74AHCT1G125DBVR; SOT-23-5
U10: W25Q32JVSSIQ; SOIC-8_5.3x5.3mm_P1.27mm
Y1: 40MHz 12pF 10ppm; Crystal_SMD_3225-4Pin_3.2x2.5mm

Connections:
+3V3: C10.1, C11.1, C12.1, C100.1, C101.1, C103.1, C104.1, C105.1, C106.1, C107.1, L1.2, L2.1, L100.1, R22.1, R30.1, R100.1, R101.1, TP2.1, U1.20, U1.46, U1.55, U1.56, U7.4, U7.5
+5V_DATA: C13.1, C14.1, C17.1, D2.1, R14.1, TP8.1, U8.5, U9.5
ANT_TUNE: ANT1.2, L104.1
BOOST_FB: R14.2, R15.1, U7.3
BOOST_SW: D2.2, L2.2, U7.1
BOOT: D4.1, R101.2, U1.5
BUCK_BST: C9.1, U6.1
BUCK_FB: R22.2, R23.1, U6.3
BUCK_FB_LOW: R23.2, R24.1
BUCK_SW: C9.2, L1.1, U6.6
BUTTON_COMMON: D4.3, SW1.1
CC1: J1.A5, R1.1
CC2: J1.B5, R2.1
DATA16_5V: R16.1, U8.4
DATA16_OUT: J3.1, R16.2, R17.1
DATA17_5V: R27.1, U9.4
DATA17_OUT: J4.2, R27.2, R28.1
DC_FUSED: C5.2, D1.2, F1.2, Q1.1, Q1.2, Q1.3, U3.3, U3.6
DC_GATE: Q1.4, U3.5
DC_IN: F1.1, J2.2
DC_SENSE_B: Q2.1, R12.2, R13.1
DC_SENSE_R: D1.1, R12.1
DC_VCAP: C5.1, U3.1
ESP_EN: C111.1, R100.2, TP3.1, U1.4
FLASH_CLK: R105.2, U10.6
FLASH_CS: R110.2, U1.32, U10.1
FLASH_IO0: U1.35, U10.5
FLASH_IO1: U1.34, U10.2
FLASH_IO2: U1.31, U10.3
FLASH_IO3: U1.30, U10.7
GND: ANT1.3, C6.2, C8.2, C10.2, C11.2, C12.2, C13.2, C14.2, C17.2, C18.2, C100.2, C101.2, C102.2, C103.2, C104.2, C105.2, C106.2, C107.2, C108.2, C109.2, C110.2, C111.2, C112.2, C113.2, C114.2, C115.2, D3.2, J1.A1, J1.A12, J1.B1, J1.B12, J1.SH, J2.1, J3.2, L104.2, Q2.2, R1.2, R2.2, R13.2, R15.2, R17.2, R18.2, R24.2, R28.2, R29.2, R102.2, R103.2, SW1.2, TP1.1, U1.57, U2.2, U3.2, U4.5, U4.9, U5.2, U6.2, U7.2, U8.1, U8.3, U9.1, U9.3, U10.4, Y1.2, Y1.4
GPIO16: R18.1, TP6.1, U1.22, U8.2
GPIO17: R29.1, TP7.1, U1.23, U9.2
GPIO18_BUTTON: D4.2, R30.2, TP10.1, U1.24
RF_50: ANT1.1, C115.1, L102.2
RF_CHIP: C114.1, L102.1, U1.1
SPICLK: R105.1, U1.33
STRAP45: R102.1, U1.51
STRAP46: R103.1, U1.52
UART_RX: TP12.1, U1.50
UART_TX: TP11.1, U1.49
USB_5V: C6.1, J1.A4, J1.A9, J1.B4, J1.B9, R10.1, U2.5, U4.1, U4.2, U4.4
USB_DM: R3.2, U1.25
USB_DM_CONN: J1.A7, J1.B7, R3.1, U2.1, U2.6
USB_DP: R4.2, U1.26
USB_DP_CONN: J1.A6, J1.B6, R4.1, U2.3, U2.4
USB_ENABLE: Q2.3, R10.2, U4.3
USB_GATE: Q3.4, U5.5
USB_SLEW: C18.1, U4.6
USB_SWITCHED: C7.2, Q3.1, Q3.2, Q3.3, U4.7, U4.8, U5.3, U5.6
USB_VCAP: C7.1, U5.1
VDD3P3_RF: C102.1, L100.2, U1.2, U1.3
VDD_SPI: C108.1, C109.1, C110.1, R110.1, U1.29, U10.8
VSYS: C8.1, D3.1, J4.1, Q1.5, Q3.5, TP9.1, U3.4, U5.4, U6.4, U6.5
XTAL_N: C113.1, U1.53, Y1.3
XTAL_P: L101.1, U1.54
XTAL_P_CRYSTAL: C112.1, L101.2, Y1.1
