luxio-lighting/luxio-hardware/(commit log)

2026-11-11 0.20mm → 0.30mm drill holes
2026-11-11 Finalize LX0001 v1.0.0 layout, connector models and documentation
    Restore the 60 x 20 mm board with top-side input connectors and retain 0.30 mm drills. Add aligned library STEP models, isometric renders and the hardware README. Refresh fabrication outputs and validation evidence.
2026-11-11 Correct isometric camera and orient USB bottom left
2026-11-11 Match underside render by flipping PCB around its long axis
2026-11-11 Make LX0001 power selection and data enables independent of firmware
2026-11-12 Replace LX0001 USB connector with lower-cost DEALON C2927038
